jessiepullaro414/Scan/software/docs/APP_API.md

# OpenHandScan Studio: app API (v2, milestones 1 and 2)

Milestone 1 defined everything up to [M2: setup and calibration](#m2-setup-and-calibration), which adds to it without changing it.

This is the contract between the backend (`software/ohs/server/`, FastAPI) and the UI (`software/ui/`, React).

- Server: `http://127.0.0.1:8765`. REST is under `/api`, the WebSocket at `/api/ws/live`, and the built UI is served at `/`.
- JSON uses snake_case.
- Lengths are in **mm**, times in seconds, timestamps in ISO 8601.

**Errors:** 4xx/5xx responses carry JSON `{"detail": "what happened", "hint": "what to do"}`. `hint` is optional.

## Types

```ts
type Emitters = { vertical: number; horizontal: number; dots: number };          // percent 0..100
type DeviceState = {
  source: "none" | "camera" | "replay" | "sim";
  connected: boolean;
  busy: string | null;                                   // e.g. "Generating simulator demo…"
  camera: { connected: boolean; info: Record<string, unknown> } | null;
  pico: { connected: boolean; firmware: string | null; emitters: Emitters } | null;
  calibration: { loaded: boolean; path: string | null; image_size: [number, number] | null;
                 baseline_mm: number | null; lasers: string[]; imu: boolean };
  replay: { path: string; loop: boolean } | null;
};
type ScanStatus = "recording" | "recorded" | "processing" | "processed" | "failed";
type Scan = { id: string; name: string; created: string; mode: "markerless" | "markers";
              n_frames: number; duration_s: number; status: ScanStatus;
              result: { mesh_url: string; stl_url: string; laser_points_url: string | null;
                        report: Record<string, unknown> } | null };
type ProjectSummary = { id: string; name: string; created: string; modified: string;
                        n_scans: number; thumbnail_url: string | null };
type Project = ProjectSummary & { scans: Scan[] };
type SessionState = { state: "idle" | "scanning" | "paused" | "stopping";
                      project_id: string | null; scan_id: string | null;
                      mode: "markerless" | "markers"; elapsed_s: number; frames: number };
type Job = { id: string; kind: string; state: "queued" | "running" | "done" | "failed" | "cancelled";
             progress: number; message: string; result: Record<string, unknown> | null;
             error: string | null; created: string };
```

## REST

| Method and path | Body | Returns |
|---|---|---|
| `GET /api/health` | | `{app:"openhandscan", version, engine:{opencv, open3d}}` |
| `GET /api/device` | | `DeviceState` |
| `POST /api/device/connect` | `{source:"camera"\|"replay"\|"sim", recording?:string, loop?:bool}` | `DeviceState`. For `sim`, the first time a job builds the demo recording: returns **202** with `{job: Job}`, and the device connects itself when the job finishes. |
| `POST /api/device/disconnect` | | `DeviceState` |
| `POST /api/device/emitters` | `Emitters` (partial allowed) | `DeviceState`. Ignored for replay and sim. |
| `GET /api/projects` | | `ProjectSummary[]`, newest first |
| `POST /api/projects` | `{name}` | `Project` |
| `GET /api/projects/{pid}` | | `Project` |
| `PATCH /api/projects/{pid}` | `{name}` | `Project` |
| `DELETE /api/projects/{pid}` | | `204`. The folder moves to `<projects>/.trash/` and is never hard-deleted. |
| `GET /api/scan` | | `SessionState` |
| `POST /api/scan/start` | `{project_id, mode?, name?}` | `SessionState`. `409` if no device is connected, no calibration is loaded, or a scan is already running. |
| `POST /api/scan/pause` / `resume` | | `SessionState` |
| `POST /api/scan/rewind` | `{seconds: 2.0}` | `SessionState`. Drops the last N s from the live model and records a `cut` event, which offline processing skips. |
| `POST /api/scan/stop` | | `{scan: Scan}` (the recording is finalised) |
| `POST /api/projects/{pid}/scans/{sid}/process` | `{quality:"standard"\|"best"\|"preview"}` (default `"standard"`; `"full"` = `"standard"`) | `Job` |
| `GET /api/jobs` / `GET /api/jobs/{jid}` | | `Job[]` / `Job` |
| `POST /api/jobs/{jid}/cancel` | | `Job` |
| `GET /api/projects/{pid}/scans/{sid}/files/{name}` | | result files: `mesh.ply`, `mesh.stl`, `laser_points.ply`, `report.json` |
| `GET /api/settings` | | merged config as JSON (read-only in M1) |

## WebSocket `/api/ws/live`

**Client → server (text JSON):** `{"type":"subscribe","preview":true,"mesh":true,"max_preview_hz":15}`. Every field is optional, and preview and mesh are on by default.

**Server → client, text JSON messages:**
- `{"type":"hello","version":"0.1.0"}` on connect, followed by the current `device`, `session` and active `job` messages.
- `{"type":"status","t":…,"session":SessionState,"tracking":{"state":"idle"|"ok"|"weak"|"lost","reason":string|null,"fitness":number|null,"rmse_mm":number|null},"distance_mm":number|null,"fps":{"camera":number,"pipeline":number},"laser_points":number,"model":{"vertices":number,"triangles":number},"emitters":Emitters|null}` at about 10 Hz.
- `{"type":"pose","T_wc":[16 numbers, row-major],"ok":bool}` with each processed frame, and `{"type":"ghost","T_wc":[…]}` when tracking is lost (the last good pose).
- `{"type":"device", …DeviceState}`, `{"type":"job", …Job}`, `{"type":"log","level":"info"|"warn"|"error","message":…}` whenever they change.

**Server → client, binary messages:** a `uint32` little-endian header length, then the UTF-8 JSON header, then the payload.
- `{"type":"preview","camera":"left"|"depth","format":"jpeg","w":…,"h":…,"seq":…}`. The payload is a JPEG. `left` is the rectified left image with the laser overlay; `depth` is a colourised depth map.
- `{"type":"mesh","seq":…,"vertices":V,"triangles":T,"units":"mm","frame":"world"}`. The payload is four sections, each starting on a 4-byte boundary:
  1. `positions` Float32[V·3]
  2. `normals` Float32[V·3]
  3. `colors` Uint8[V·4] (RGBA quality colours: green = well observed, yellow = thin)
  4. `indices` Uint32[T·3]
  
  It's sent every ~1.5 s while scanning, decimated to at most 300k triangles.

**Backpressure:** the server keeps only the latest message of each binary type per client, so a slow client never stalls the scanner.

## Coordinates
- The world frame is the camera frame of the first tracked frame, with OpenCV axes (x right, y down, z forward), in mm.
- The UI converts to three.js (y up) by rotating 180° about X. It then frames the model automatically.

## Project folders
- Location: `<projects_dir>/<project_id>/` (default `~/OpenHandScan/projects`).
- Contents: `project.json`, plus `scans/<scan_id>/recording/` (the raw recording format from ARCHITECTURE.md) and `scans/<scan_id>/result/` (the output of `process_recording`).
- `project.json` holds `{id, name, created, modified, scans:[{id, name, created, mode, status}]}`.

## API deviations (backend, M1)

Everything above is implemented as written. Where the contract was silent or ambiguous, the backend does this. Fields marked *extra* are additions that a UI can ignore.

**Clarifications**
- Binary framing: the JSON header is padded with spaces so the payload starts on a 4-byte boundary *of the whole message* (`(4 + header length) % 4 == 0`), so `Float32Array`/`Uint32Array` views can be made directly on the received `ArrayBuffer`. Mesh sections follow back to back (their sizes are always multiples of 4).
- `Job.progress` is a fraction from 0 to 1. A job's final `job` message comes after its side effects (scan status updated in the store, the simulator device connected).
- `GET /api/projects` is sorted by `created`, newest first. `POST /api/projects` returns 200 with the `Project`.
- `replay.loop` defaults to `false`. A non-looping replay disconnects at its end (a running scan is stopped and saved, and a `log` message says so). The sim source always loops; its demo is a seamless back-and-forth sweep, so tracking continues across passes.
- `status.laser_points` is the running total of the live model (a rewind lowers it). `status.model` counts the live mesh before decimation.
- Every scan start first sends an empty `mesh` (`seq` 0, 0 vertices) so the UI can clear the previous model. The ghost is the last good pose; the UI hides it when a `pose` arrives with `ok: true`.
- Quality colours: the proxy is the number of tracked frames that saw each 8 mm cell of the world (not the TSDF weight, which a rewind rebuild would distort). Yellow at 4 views or fewer, green at 12 or more, blended in between.
- Pause: frames are neither recorded nor integrated, and the emitters are off. IMU samples and events are still recorded so that offline tracking can bridge the pause with the gyro. `events.csv` gets `session,pause` / `session,resume` rows.
- Rewind cuts the frame-clock interval `[t1 - seconds, t1]`, where `t1` is the newest recorded frame; paused time counts. Offline processing skips cut frames (`report.json` has `frames.cut` and `cuts`).
- `POST /api/device/emitters`: during a scan the levels are kept for the rest of it. While paused they are only stored, and the emitters stay off until Resume. Without a Pico (replay, sim, or a camera with no Pico) the call is ignored and returns the `DeviceState`.
- Status codes besides 409: 400 for an empty name or a replay without `recording`; 404 for a replay path that is not a recording; 422 for an invalid body; 503 when the camera or Pico cannot be opened or the Pico refuses a command; 403 from the local guard. The local guard refuses a `Host` other than localhost or an IP address, and refuses mutating requests or WebSockets whose `Origin` is neither this server nor the Vite dev server on port 5173.
- Pico trigger: a short press pauses or resumes a running scan, or starts a scan in the last-used project when idle. A long press (1 s or more) stops the scan.

**Extra fields**
- `hello`: `app`, `app_version`. `log`: `t`. `health`: `api`.
- `status`: `tracking.code` (machine-readable: `no_depth`, `few_inliers`, `low_overlap`, `degenerate`, `rewound`, ...), `laser_points_frame`, `latency_ms` (frame captured to result published), `process_ms` (pipeline time of the frame), `dropped_frames` (frames the live pipeline skipped; every frame is still recorded), `record_backlog` (frames waiting to be written to disk: the recorder's queue plus unwritten PNGs; 0 when idle; the recorder logs one warning past 120), `gpu_fallback` (`null`, or `{stage: reason}` once a GPU stage failed in the running scan and went on on the CPU, e.g. `{"depth": "out of memory"}`, stages `depth` and `track_filter`; kept until the scan stops; the server also sends one `log` message with level `warn` when it first happens).
- `status.tracking.weak` (M3): what the surface can't pin down in this frame, `"slide"` and/or `"turn"` (a flat panel, a sphere's axis).
  - `degenerate` shows with a matching hint when 4 of the last 6 frames have it.
  - Sliding counts even with the gyro, which holds rotations only; turning counts only without the gyro.
  - The processing report has the share of tracked frames with each, in `frames.weak`.
- `DeviceState`: `error` (the last device failure), `warnings` (strings), `imu_stream` (bool), `camera.info.measured_fps` / `frames` / `frame_size`, `pico.imu` / `port` / `error`.
- `DeviceState.imu_temp_c` (number or null): the IMU chip's temperature in °C, rounded to 0.1. It is live from firmware 1.1+ (about once a second while the IMU streams), or as recorded for a replay or the simulator, and null when there has been no reading for 10 s. A `device` message goes out when it has moved 0.5 °C. Recordings store every reading as a `temperature` event, and a scan starts with the latest one.
- `SessionState`: `name` (the scan name) while a scan is active. The `POST /api/scan/rewind` reply also has `rewind: {t0, t1, seconds, dropped_frames, kept_frames, rebuilt_keyframes, rebuild_s}`.
- `Scan`: `thumbnail_url` (or null), `error` (after a failed processing), `quality` (of the last processing). `ProjectSummary.thumbnail_url` is the newest scan's thumbnail.
- `Job`: `project_id`, `scan_id` and `quality` for `process_scan`. `result` is `{project_id, scan_id, scan}` for `process_scan` and `{path, frames, image_size}` for `generate_demo`.
- `Job.frames` (optional): `{stage, done, total, fps, elapsed_s} | absent`, present only while a job goes through the recording's frames (the track pass, and the fuse passes of straighten and fuse, in the processing jobs).
  - `stage` is `"track"`, `"straighten"` or `"fuse"`; `done` counts frames from 1 to `total` (the frames this pass processes, after Standard's frame limit); `fps` is the rate since the first frame was done (null until the second), and `elapsed_s` the time since then. The rate leaves out loading the recording and the first frame's warm-up.
  - The last frame always goes out. From then until the pass ends (`done == total`) the mesh is made from the frames, cleaned and saved; the message then reads like "Tracking: all 412 frames done, making the mesh".
  - The field disappears when the pass ends and is never in a finished job. A job can have several passes; each starts its own count. The UI turns it into "About 3 min left for tracking" (`ui/src/lib/estimate.ts`). An engine without it simply sends no `frames`.
- `mesh` header: `decimated` (bool).
- `GET .../files/{name}` also serves `trajectory.csv`, `mesh.obj` (when exported) and `thumbnail.jpg` (the left camera view saved at stop).

---

## M2: setup and calibration

The first-run wizard and the calibration screens (see the M2 plan in [`DESKTOP_APP_PLAN.md`](DESKTOP_APP_PLAN.md#m2-plan-setup-and-calibration-wizard)). Everything here adds to the M1 contract; nothing in M1 changes. `health.api` and `hello.version` become `"0.2.0"`.

**Targets.** The wizard calibrates one *target*:
- `"device"`: the real scanner's calibration file (`paths.calibration`).
- `"sim"`: a sandbox file for the simulator (`<data_dir>/sim/calibration.json`). Calibrating the simulator never touches the real calibration, and the simulator's scan demo keeps its own true calibration.

The target is `"sim"` while the simulator is connected, and `"device"` otherwise. `data_dir` defaults to `~/.ohs/studio`.

### Types

```ts
type CalibKind = "stereo" | "lasers" | "imu" | "check";
type CalibTarget = "device" | "sim";
type SimScene = "demo" | "calib_stereo" | "calib_lasers" | "calib_imu" | "calib_check";

// DeviceState gains (M2):
//   launch_check: LaunchCheck | null   the silent drift check run after each connect
//   sim_scene: SimScene | null         what the simulator shows (null unless source is "sim")
type LaunchCheck = { state: "running" | "ok" | "drift" | "unknown"; dv_px: number | null;   // median rectified row error, full-res px
                     matches: number; message: string | null; when: string };

// ---- setup
type StepId = "connect" | "selftest" | "print" | "stereo" | "lasers" | "imu" | "check";
type SetupStep = { id: StepId; state: "done" | "todo" | "warn" | "optional"; summary: string; when: string | null };
type PartInfo = { when: string; summary: string; session: string | null };   // recorded by Studio when it saved that part
type SetupState = {
  target: CalibTarget;
  first_run: boolean;      // the target has no stereo calibration and the wizard was not dismissed
  dismissed: boolean;
  steps: SetupStep[];      // always all seven, in the StepId order above
  calibration: { path: string; exists: boolean; modified: string | null; image_size: [number, number] | null;
                 baseline_mm: number | null; stereo: boolean; lasers: string[]; imu: boolean;
                 parts: { stereo: PartInfo | null; lasers: PartInfo | null; imu: PartInfo | null };
                 backup: string | null };            // the previous version (calibration.json.bak), if any
  selftest: SelfTestResult | null;                    // the last self-test for this target
  print_check: PrintCheck | null;                     // null for the sim target (its board is virtual and exact)
  board: BoardInfo;
  launch_check: LaunchCheck | null;
  last_check: { when: string; ok: boolean; verdict: string } | null;
};
type BoardInfo = { squares_x: number; squares_y: number; square_mm: number; marker_mm: number;   // as printed (config [board])
                   dictionary: string; paper: "letter" | "a4"; scale: number;                    // measured print scale used for calibration (1 = exact)
                   describe: string };

type CheckStatus = "PASS" | "WARN" | "FAIL" | "SKIP" | "INFO";
type SelfTestCheck = { name: string; status: CheckStatus; detail: string; fix: string | null };   // fix: what to do, in plain words
type SelfTestResult = { overall: "PASS" | "WARN" | "FAIL"; when: string; source: "camera" | "replay" | "sim"; checks: SelfTestCheck[] };

type CameraProbe = { index: number; width: number; height: number; fps: number; fourcc: string; name: string | null;
                     stereo_like: boolean; configured: boolean; in_use: boolean };
type DevicesProbe = { cameras: CameraProbe[]; pico_port: string | null; configured_index: number; note: string | null };

type PrintFile = { name: string; kind: "board" | "tags" | "mask"; title: string; description: string;
                   url: string; preview_url: string | null; bytes: number };
type Printables = { dir: string; generated: string | null; paper: "letter" | "a4"; files: PrintFile[] };
type PrintCheck = { measured_mm: number; error_pct: number; ok: boolean; scale: number; verdict: string;
                    can_apply: boolean; when: string };

// ---- calibration session
type CalibState = "idle" | "capturing" | "armed" | "recording" | "solving" | "result" | "saved";
// capturing: stereo / lasers / check take views. armed -> recording: the IMU step (hold still, then rotate).
type CalibView = { index: number; t: number; auto: boolean; corners_left: number; corners_right: number | null;
                   distance_mm: number | null; tilt_deg: number | null;
                   lines: { vertical: number; horizontal: number } | null;     // laser points on the page margin
                   thumb_url: string; error_px: number | null; bad: boolean;   // error and bad: after a solve
                   warnings: string[] };
type CalibMetric = { label: string; value: string; ok: boolean | null; help: string };
type CalibAdvice = { text: string;
                     action: "add_views" | "remove_bad_views" | "start_over" | "recalibrate_stereo" | "reprint" | "check_board" | null };
type CalibResult = {
  kind: CalibKind; ok: boolean; grade: "excellent" | "good" | "usable" | "poor" | "failed";
  headline: string;        // e.g. "Excellent stereo calibration"
  verdict: string;         // one or two plain sentences: what happened and what it means
  metrics: CalibMetric[];  // plain-language rows: "Reprojection error 0.21 px (want < 0.5 px)"
  advice: CalibAdvice[];
  per_view: { index: number; error_px: number; bad: boolean }[];
  sim_truth: CalibMetric[] | null;   // simulator only: the estimate against the virtual scanner's true calibration
  can_save: boolean;                 // false for "check" and for "failed"
  report_url: string;
};
type CalibSession = {
  state: CalibState; kind: CalibKind | null; target: CalibTarget; id: string | null; started: string | null;
  auto: boolean;                     // auto-capture on (default)
  views: CalibView[]; target_views: [number, number]; min_views: number;
  guidance: string;                  // the one-line how-to for this kind
  emitters: string;                  // e.g. "Line lasers on: Class 3R, never look into the beams"
  job_id: string | null;             // the solve job
  result: CalibResult | null;
  recording: string | null;          // folder of the captured views
  saved: { path: string; backup: string | null; notes: string[] } | null;
};
type CalibHint = { text: string;                                   // "Move the board to the top-left corner"
                   region: [number, number, number, number] | null; // x0, y0, x1, y1 as fractions of the image: where to put the board
                   tilt: "left" | "right" | "up" | "down" | "more" | null;
                   distance: "closer" | "farther" | null };
type CalibLive = {
  type: "calib"; t: number; kind: CalibKind; state: CalibState;
  image_size: [number, number];      // full-resolution size of one camera image; every coordinate below is in it
  fps: number;                       // processed frames per second
  left: { corners: number[] } | null;      // flattened [u0, v0, u1, v1, ...]
  right: { corners: number[] } | null;     // stereo only
  common: number | null;                   // stereo: corners seen by both cameras
  board_found: boolean; distance_mm: number | null; tilt_deg: number | null;
  outline: number[] | null;                // board outline, 4 points
  page: number[] | null;                   // lasers / check: page outline, 4 points
  lines: { vertical: number; horizontal: number; vertical_uv: number[]; horizontal_uv: number[] } | null;
  ready: boolean;                          // a capture now would be accepted
  reason: string | null;                   // why not: "Show the whole board to both cameras", "Hold still", "Too close to view 3"
  steady: number;                          // 0..1: progress of the auto-capture hold
  auto: boolean;
  hint: CalibHint | null;
  coverage: { cols: number; rows: number; left: number[]; right: number[] | null;   // views per cell, row-major
              left_pct: number; right_pct: number | null } | null;
  diversity: { flat: number; tilt_left: number; tilt_right: number; tilt_up: number; tilt_down: number;
               near: number; mid: number; far: number } | null;                       // captured views per pose bin
  views: number; target_views: [number, number];
  imu: { phase: "armed" | "still" | "rotate" | "done"; elapsed_s: number; still_s: number; min_s: number; max_s: number;
         gyro_dps: number; board_pct: number } | null;
};
```

### REST

| Method and path | Body | Returns |
|---|---|---|
| `GET /api/setup` | | `SetupState` |
| `POST /api/setup/dismiss` | `{dismissed: bool}` | `SetupState` |
| `POST /api/setup/selftest` | | `Job` (kind `selftest`, result `SelfTestResult`). While it runs, `job.message` is the instruction for the user (e.g. "Press and release the trigger now"). |
| `GET /api/setup/devices` | | `DevicesProbe` (cameras found, the Pico's serial port) |
| `POST /api/settings/camera` | `{index?: int, swap_lr?: bool}` | `Settings`. Written to the config file; takes effect on the next connect. |
| `GET /api/setup/printables` | | `Printables` (what was generated last; `files` empty before) |
| `POST /api/setup/printables` | `{paper?: "letter" \| "a4"}` | `Job` (kind `printables`, result `Printables`). A paper change is saved to `board.paper`. |
| `GET /api/setup/printables/files/{name}` | | a generated file (PDF, PNG, Gerber); 404 for anything else |
| `POST /api/setup/printables/open` | | `{opened: bool, dir: string}`: opens the folder in the system file manager |
| `POST /api/setup/print-check` | `{measured_mm: number, apply?: bool}` | `PrintCheck` |
| `GET /api/calibration` | | `CalibSession` (`state: "idle"` when none) |
| `POST /api/calibration/start` | `{kind}` | `CalibSession` |
| `POST /api/calibration/capture` | | `{view: CalibView, session: CalibSession}`. 409 with the plain reason when the current view can't be used. |
| `DELETE /api/calibration/views/{index}` | | `CalibSession` |
| `POST /api/calibration/auto` | `{enabled: bool}` | `CalibSession` |
| `POST /api/calibration/imu/start` | | `CalibSession` (armed -> recording) |
| `POST /api/calibration/imu/stop` | | `CalibSession` (recording -> capturing, ready to solve) |
| `POST /api/calibration/solve` | | `Job` (kind `calibrate`). The session goes to `solving`, then `result`. A failed solve returns the session to `capturing` with a `result` of grade `failed` that says why. |
| `POST /api/calibration/continue` | | `CalibSession`: back to `capturing` with the views kept ("add more views") |
| `POST /api/calibration/save` | `{force?: bool}` | `{session: CalibSession, setup: SetupState}`. `force` is needed when `result.ok` is false. 409 for `check` and `failed` results. |
| `POST /api/calibration/cancel` | | `CalibSession` (idle). The captured views stay on disk. |
| `GET /api/calibration/views/{index}/thumb.jpg` | | small JPEG of the view's left image |
| `GET /api/calibration/report.json` | | the engine's full report of the last solve |

### WebSocket additions
- Text `{"type":"calib", ...CalibLive}` at about 10 Hz while a calibration session is active (latest-only).
- Text `{"type":"calib_session", ...CalibSession}` whenever the session changes. New clients get it in the seed.
- Text `{"type":"setup", ...SetupState}` whenever it changes (self-test, print check, save, launch check, connect).
- Binary `preview` with `camera` `"calib_left"` or `"calib_right"`: the calibration views, JPEG, downscaled (about 640 px wide). The `preview` subscription flag gates them like the other previews.
  - stereo: raw (unrectified) left and right images;
  - lasers / check / imu: the rectified left image only.
  
  `CalibLive` coordinates are full-resolution pixels of the image that preview shows; the UI scales them by `w / image_size[0]`.

### Rules
- **One activity at a time:** a scan and a calibration session never run together (409 either way). Calibration needs the camera or the simulator. A replay is refused with 409.
- **Preconditions:** lasers, imu and check need a stereo calibration in the target (409 with a hint otherwise). imu also needs IMU data: the Pico's IMU, or the simulator. With a camera, lasers and check need the Pico for the emitters; without it they start with a warning.
- **Device lost:** if the device disconnects during a session, the session is cancelled (the views stay on disk) and a `log` says so.
- **Trigger:**
  - stereo / lasers / check: a short press captures a view; a long press solves (once there are enough views).
  - imu: a short press starts and stops the recording.
- **Emitters:** each kind uses its profile from the config (`[emitters.profiles]` `stereo` / `lasers` / `imu` / `check`) while the session runs, and they are off afterwards.
- **Simulator:** `start` switches the simulator to that kind's virtual board (`DeviceState.sim_scene`). Cancel and save switch it back to `"demo"`. Results carry `sim_truth`.
- **Saving** merges like `ohs calibrate`:
  - A new stereo calibration drops the laser planes and the IMU calibration, and `saved.notes` says so.
  - The previous file is kept as `calibration.json.bak`.
  - After saving to the device target, a connected camera reloads the calibration (`device` message).
- **Launch check:**
  - After each connect with a calibration, the device compares the rectified rows of left and right features on a few idle frames.
  - It stays silent unless they disagree (`launch_check.state: "drift"`). Then a `warn` log and a `DeviceState.warnings` entry suggest running the check.
  - `"unknown"` (too few features, e.g. a blank wall) is also silent.

## API deviations (M2)

Where the backend had to decide something the M2 contract left open, it is listed here.

Everything in the M2 section is implemented as written, with these clarifications. Fields marked *extra* are additions that a UI can ignore.

**Setup state**
- `setup.json` lives in `data_dir` (config key `paths.data_dir`). The dismissed flag is kept per target. The printables manifest is shared by both targets.
- The target is `"sim"` while the simulator is connected, in any scene, and `"device"` otherwise (also with a replay or nothing connected).
- Step rules:
  - `connect` is done once a camera (device target) or the simulator (sim target) has connected. Replays don't count. The summary reads like "Camera (2560x800) and Pico (firmware ohs-fw 1.0) connected, today".
  - `selftest` is done on PASS. It is a warning on WARN or FAIL, and its summary names the checks.
  - `print` (device) is done within ±0.3 % and a warning otherwise, even after "use my measurement".
  - `lasers` is done with both planes and a warning with only one.
  - `check` is done or a warning only when the last check is newer than the last save. The last save is Studio's part info, else the file's modification time. Otherwise the step is to do.
- `when` is the time behind the summary, or null.
- `calibration.parts.<part>` is set only for parts that are in the file and were saved by Studio. A file from `ohs calibrate` gives null.

**Print check**
- `error_pct` is `measured_mm - 100`, signed. `measured_mm` must be greater than 0 and less than 1000, else 422.
- Each check replaces the previous one:
  - within ±0.3 %: scale 1;
  - up to ±4 %: `measured / 100` with `apply: true`, else 1;
  - beyond ±4 %: always 1, and `apply` is ignored.
- The print is physical, so a print check made while the simulator is connected is stored for the device. The sim's `SetupState.print_check` stays null.
- The scale only changes the board spec used to calibrate the device (`board.scale`; `board.describe` mentions it). Capture recordings store that scaled spec as `board`, plus `board_scale`.

**Self-test**
- With nothing connected, the self-test runs on the configured camera and Pico and leaves the device disconnected.
- With the camera connected, the device is busy ("Running the self-test…") during the test and is reconnected afterwards.
- `run_selftest` has one duration for its measurement and its trigger window: 8 s. The measurement therefore also takes 8 s, and the whole test about 25 s.
- `job.message` shows the instructions, then "Camera frame rate: passed" and so on after each check.
- The simulator and replay stream checks take 3 s.
- Refused with 409 also while a self-test is running or the device is busy.
- *extra*: `SelfTestCheck.id` is the engine's check name (e.g. `camera fps`); `name` is the readable one ("Camera frame rate"). The job result also carries `message`, which the stored `setup.selftest` does not.

**Devices probe and camera settings**
- The probe opens indices 0–7 with the configured `camera.backend` and reports each camera's default mode. `name` is only available on Linux.
- The connected camera is never opened again. Its entry (`in_use: true`) comes from the running camera, with the side-by-side size.
- `pico_port` falls back to the connected Pico's port.
- `POST /api/settings/camera` returns the same object as `GET /api/settings`.
  - Errors: 422 for an index outside 0–63; 409 during a scan or a calibration.
  - It updates the running config too and takes effect on the next connect.
  - The file written is `Settings.effective.config_path` (*extra*, along with `data_dir`, `printables_dir` and `sim_calibration`). When there is no file, the commented template is written first. Comments and other lines are kept.

**Printables**
- The paper is saved before the job starts. The job result is `Printables` plus `message`.
- Errors: 409 while a printables job runs; 422 for an unknown paper.
- A new run first removes the previous run's files (only whitelisted names).
- File names:
  - board: `charuco_board.pdf` / `.png`;
  - tags: `apriltags.pdf` / `.png` (`apriltags_p<k>.png` for several sheets);
  - mask: `projector_mask_sheet.pdf` / `.png` and `projector_mask_film.gbr` / `.svg`.
- `preview_url`:
  - board: `charuco_board.png`;
  - tags: the sheet's PNG;
  - mask: `projector_mask_preview.png`, one mask enlarged. It is served but not listed, because the 1200 dpi sheet shows nothing at screen size.
- The file route serves only those names, from the last run, with `X-Content-Type-Options: nosniff`.
- `POST .../open` creates the folder if it is missing.
- The 1200 dpi mask sheet takes about 20 s.

**Simulator scenes**
- `sim_scene` is `"demo"` for the scan demo and `"calib_<kind>"` during a calibration.
- *extra*: `DeviceState.sim_demo_ready` is true when the simulator's demo recording exists, so connecting the simulator is instant and needs no `generate_demo` job.
- A scene swap is not a reconnect: there is no "Connected" log and no launch check.
- During a calibration scene, `DeviceState.replay` is null and `DeviceState.calibration` is the sandbox calibration.
- A scene that cannot start returns 503, and the demo comes back.

**Launch check**
- It runs after every fresh connect with a calibration, including the simulator demo.
- `launch_check` is `{state: "running", dv_px: null, matches: 0, …}` until 3 idle frames, at least 0.3 s apart in frame time, are in. While a scan or a calibration takes the frames, it waits.
- `dv_px` is rounded to 0.001 px.
- `"unknown"` also covers a camera image size that differs from the calibration.
- The result is recorded for the target: `sim` for the simulator, else `device`.
- The drift warning reads "The cameras may have moved since the calibration … Run the 2-minute check (Setup, step 7)."

**Calibration session**
- **Views:**
  - `CalibView.index` is a stable id: 0, 1, 2… in capture order, never reused. Deleting a view leaves a gap, and the next capture continues the count. Show `index + 1` as the view number: "Too close to view 3" means index 2.
  - The snapshot recording uses the same numbers for its frames. A delete rewrites `frames.csv` and `meta.json` and removes the PNG.
  - `CalibView.t` is seconds since the session's first processed frame (frame clock).
  - `CalibView.lines` (lasers / check) counts the laser points on the blank page margin, at least 5 mm clear of ink and of the paper edge: the points the laser fit uses. A view needs ≥ 15 per line.
- **Recordings:**
  - Views are written by Studio's own writer, in the recording format. `RecordingWriter` keeps `frames.csv` open and cannot drop a row.
  - The IMU uses `ohs.app.live.Recorder` and keeps the last second of IMU history (not on the simulator).
  - `recording` is null until the first capture or `imu/start`.
  - A solve writes `calib_report_<kind>.json` into the recording.
  - Cancelled recordings stay on disk, including a partial IMU recording.
- **imu:** `views` is `[]`, `target_views` is `[0, 0]` and `min_views` is 0. States run `armed` → `recording` → `capturing` (recorded, ready to solve) → `solving` → `result`.
- **State rules:**
  - Solve is allowed from `capturing` or `result`, so you can delete views and solve again.
  - Capture only in `capturing`; delete in `capturing` or `result`.
  - `continue` clears `result`: back to `capturing`, or `armed` for imu, to record again. The view errors stay until the next solve.
  - After a save, the state is `saved`, and `GET /api/calibration` shows the saved session until the next start or a cancel.
- **Auto-capture:**
  - Steady means the 90th percentile of the common corners' motion is under 1 px (both cameras for stereo) for 0.5 s.
  - New means the board centre moved more than 12 % of the width, or the distance changed more than 10 %, or the board normal turned more than 8°.
  - It stops at the upper target view count (25 / 10 / 5) with the reason "Enough views: press Finish & calibrate".
- **IMU timing:** `elapsed_s`, `still_s` (2), `min_s` (22, which is 2 s still plus 20 s of rotation) and `max_s` (62) are seconds of frame time since the first recorded frame.
  - `imu/stop` before `min_s` returns 409 "Keep rotating: N s more" (a trigger press logs the same).
  - Recording stops by itself at `max_s`, with an `info` log.
  - On the simulator, `imu/start` restarts the script and drops the one frame rendered before the restart.
- **Emitters:**
  - The kind's profile is on while capturing. The emitters are off while solving and while the result is shown, on again after `continue` or a failed solve, and off after save, cancel or a lost device.
  - `CalibSession.emitters` reads, for example, "Line lasers on: Class 3R, never look into the beams", "Emitters off: ambient light only", "No Pico: the line lasers stay off, …" or "Simulated line lasers on".
- **More 409 rules:**
  - lasers, imu and check also need the camera's image size to match the target's stereo calibration;
  - connect is refused during a calibration, and disconnect cancels it first (the views are kept);
  - `POST /api/setup/selftest` and `POST /api/settings/camera` are refused during a calibration.
- **Device lost:** losing the camera cancels the session. A lost Pico cancels only the IMU step; the other kinds continue with a warning that the lasers are off.
- **Trigger:**
  - imu: a short press starts or stops the recording; after recording, a long press solves.
  - Refusals are sent as `warn` logs in plain words.
- **Thumbnails** are JPEGs 240 px wide.
- *extra*: `CalibLive.frame_t` is the frame time of the processed frame. `CalibLive.t` is wall time, like `status.t`.

**CalibLive**
- Coordinates are full-resolution pixels of the image that the preview shows: raw for stereo, rectified left otherwise.
- `vertical_uv` / `horizontal_uv` are thinned to at most 200 points per line, rounded to 0.1 px.
- `page` is the paper outline.
- `ready` means a manual capture would be accepted now.
- `reason` is the first unmet auto-capture condition. It can also be "View N captured: move the board to a new pose", "Calibrating…" or "Press Continue to add more views".
- `coverage.*_pct` is the percentage (0–100) of the 64 cells that hold at least one view.
- Tilt bins say where the printed face points:
  - `left`: turned toward the image's left side;
  - `up`: tipped back, with the top edge farther away;
  - `flat`: under 15°.
- Distance bins:
  - stereo: near < 300 mm ≤ mid < 400 mm ≤ far;
  - lasers / check: near < 220 mm ≤ mid < 330 mm ≤ far.
- Hints:
  - `region` boxes are thirds of the image: the centre first, then the corners, then the edges.
  - `distance` is relative to the board's current distance, and null without a board.
- `calib` messages are sent about 10 Hz while frames are processed.
- The `calib_left` / `calib_right` previews are the plain images, at most 640 px wide and about 9 Hz (less if `max_preview_hz` asks). They have no overlays: the UI draws them from `calib`.

**Solve and results**
- `job.result` is `{kind, session, result: CalibResult, message}`. *extra* job fields: `calib_kind`, `calib_session`.
- A failed flow ends the job in `failed`, with `error` = the plain reason and the hint. The session is back in `capturing` with the failed result.
- Progress messages read like "Looking at view 3 of 8". The stereo solve itself reports no progress, for up to a minute.
- The IMU flow uses at most about 600 frames (it steps through longer recordings).
- `ok` means a grade of excellent or good. `can_save` is false for `check` and `failed`. Saving anything below good needs `force`.
- Grades:
  - **stereo:**
    - excellent: rms < 0.3 px, coverage > 60 % in both cameras, row error < 0.2 px, scale error < 0.3 %, ≥ 12 views and a tilt of ≥ 20°;
    - good: rms < 0.5 px, coverage > 60 % and a passing rectification check (< 0.3 px, < 0.5 %);
    - usable: rms < 1 px, coverage > 40 % and row error < 0.5 px;
    - else poor.
    - A positive `T_x` (swapped cameras) is `failed`, with the advice to turn on swap left/right and start over.
  - **lasers:**
    - excellent: both planes fitted on the margin, median residual < 0.05 mm, ≥ 6 views;
    - good: both on the margin, < 0.15 mm;
    - usable: both, < 0.3 mm (a plane may also have needed the pattern);
    - poor: one plane only;
    - failed: none.
  - **imu:**
    - excellent: the engine's verdict is good, residual < 0.1° and the board seen in ≥ 90 % of the frames;
    - good: the engine's verdict is good;
    - usable: residual < 0.5° and < 20 % outliers;
    - else poor.
  - **check:**
    - good (excellent with wide margins) when it holds, else poor.
    - On the simulator the engine's IMU part never decides it. The simulator's check moves the board, and that part assumes a still board; a check recording has no IMU samples anyway.
- `per_view` covers the views the solver looked at.
  - `error_px`: for stereo, the larger stereo rms of the view; for lasers, the board-pose rms.
  - It is null for a view the solver rejected, which is `bad: true`.
  - Views are also bad above max(2 × median, 0.5 px) (stereo), or with fewer than half of their laser points as inliers (lasers).
- Metric values include their target, e.g. "0.21 px (want < 0.5 px)".
- `sim_truth` compares planes and `R_ci` in the raw left camera frame.
- *extra*: `sim_truth_values` holds the numbers behind `sim_truth`.
- `GET /api/calibration/report.json`:
  - the engine report of the last solve, plus a `studio` block with kind, session, target, grade and views;
  - after a failed flow, `{kind, error, recording}`;
  - 404 before any solve. It is kept after a cancel.

**Save**
- `saved.notes` is in plain words: the dropped parts, a laser plane that kept its previous value, and the backup's name.
- A new stereo calibration also clears the dropped parts' info.
- The response's `setup` is the target's state after saving.

**WebSocket**
- New clients also get `setup` in the seed.

---

## M3 phase 2: processing studio

The Process page of a scan (see the M3 plan in [`DESKTOP_APP_PLAN.md`](DESKTOP_APP_PLAN.md)). It adds to M1 and M2 and changes nothing in them.
- `POST .../process` ("Make mesh") keeps its contract. It now runs the **Default** recipe at the requested quality.
- **Quality levels** (maintenance plan F2 step 3): `"standard"` (the default) processes at full resolution at most `[process] standard_frame_rate` frames per second of scanning (30: every 2nd frame of the 60 fps camera, every frame of a 30 fps recording); `"best"` processes every frame (less noise on smooth surfaces, about twice the wait); `"preview"` as before. `"full"`, the old name, is accepted everywhere and read as `"standard"`, also in stored state and saved recipes; responses and new state say `"standard"` / `"best"`. Stage summaries name the level ("Tracked 540 of 540 frames (100 %) at standard quality"). The report's `frames` has the effective `step`, `recorded_fps` and `max_frame_rate`.
- `health.api` and `hello.version` become `"0.3.0"`.

**Model.**
- A scan's processing is five **stages**: `track`, `straighten`, `fuse`, `spacetime` (M3 phase 3, a trial build: "Refine from the images") and `refine` (M3 phase 3: "Refine with lasers"). Each ends in a new **base mesh**.
- An ordered list of **edits** applies to the base mesh. `cursor` is how many of them are active; undo and redo move it.
- The **current mesh** is the base plus the active edits. It is always written to the scan's `result/mesh.ply` (and `mesh.stl`, plus `mesh.obj` when configured), so the M1 viewer and downloads show the current version.
- Re-running a stage replaces the base and **clears the edits**: face indices no longer match. The UI confirms first.
- Files live in `scans/<sid>/process/`; their layout is the backend's choice. It records it under "API deviations (M3)".

### Types

```ts
type StageState = "none" | "running" | "done" | "failed" | "skipped";
type MeshOp = "remove_floaters" | "fill_holes" | "smooth" | "decimate" | "delete_faces" | "keep_faces";
// params per op:
//   remove_floaters { min_triangles?: number; min_size_mm?: number; keep_largest_only?: boolean }
//   fill_holes      { max_hole_mm: number; watertight?: boolean }  // largest hole perimeter to fill; the outer edge too
//   smooth          { method: "taubin" | "bilateral"; strength: number /* 0..1 */; keep_edges?: boolean;
//                     within_sigma?: boolean }                     // no vertex moves more than 2 sigma
//   decimate        { target_triangles?: number; ratio?: number;   // at most one of the two, and / or
//                     max_error_mm?: number }                      // a tolerance (0.001-10 mm)
//   delete_faces / keep_faces { faces: string }                    // base64 of little-endian uint32 face indices
//                                                                  // of the CURRENT mesh
type MeshStats = {
  triangles: number; vertices: number; components: number;
  holes: number;                      // boundary loops except the outer border (the longest loop)
  largest_hole_mm: number | null;     // perimeter of the largest hole
  border_mm: number | null;           // perimeter of the outer border
  boundary_edges: number; non_manifold_edges: number; watertight: boolean;
  bbox_mm: [number, number, number]; area_cm2: number; volume_cm3: number | null;   // volume only when watertight
  sigma_mm: SigmaStats | null;        // the confidence, when the mesh has per-vertex sigmas
  filled_cm2: number;                 // area made by hole filling (not measured)
};
type SigmaStats = {                   // each vertex's sigma (1 standard deviation, mm), shares of the surface
  median: number; p95: number;        // mm
  within_0_1: number; within_0_3: number;   // share with sigma <= 0.1 / 0.3 mm
  not_measured: number;               // share nothing measured (sigma 50 mm: filled holes)
};
type EditEntry = { id: string; op: MeshOp; params: Record<string, unknown>;
                   label: string;               // "Fill holes up to 12 mm"
                   created: string; triangles_after: number; ms: number };
type StageInfo = { state: StageState; summary: string | null; when: string | null; job_id: string | null };
type ProcessState = {
  project_id: string; scan_id: string;
  stages: {
    track: StageInfo & { quality: "standard" | "best" | "preview" | null; tracked_pct: number | null };
    straighten: StageInfo & { loops: number | null; correction_mm: number | null; correction_deg: number | null;
                              crossings?: number | null };   // laser crossings used (M3 phase 3)
    fuse: StageInfo & { voxel_mm: number | null };
    spacetime: StageInfo & { source: "track" | "straighten" | "fuse" | null;   // the stage whose mesh was refined
                             frames: number | null; patches: number | null;   // frames read; patches on the surface
                             kept: number | null;                             // patches with dots in enough frames
                             covered_pct: number | null; moved_mm: number | null;  // % refined; p95 move (mm)
                             device: "gpu" | "cpu" | null };
    refine: StageInfo & { source: "track" | "straighten" | "fuse" | "spacetime" | null;   // the stage whose mesh was refined
                          points: number | null; outliers: number | null;  // laser points used / left out
                          moved_pct: number | null; moved_mm: number | null;  // % of the surface moved; p95 offset (mm)
                          residual_before_mm: number | null; residual_after_mm: number | null };  // median, mm
  };
  base: { triangles: number; vertices: number; stage: "track" | "straighten" | "fuse" | "spacetime" | "refine" } | null;
  edits: EditEntry[]; cursor: number;       // edits[0:cursor] are applied
  can_undo: boolean; can_redo: boolean;
  current: { version: number;             // increases on every change: use it to reload the mesh
             mesh_url: string;            // result/mesh.ply of this scan
             stats: MeshStats } | null;
  busy: string | null;                    // e.g. "Filling holes…" while an edit or stage job runs
  job: Job | null;                        // the running job of this scan, if any
};
type Recipe = {
  id: string; name: string; description: string; builtin: boolean;
  settings: { quality: "standard" | "best" | "preview"; straighten: "auto" | "off"; refine: "auto" | "off"; voxel_mm: number | null };
  ops: { op: Exclude<MeshOp, "delete_faces" | "keep_faces">; params: Record<string, unknown> }[];
};
type HoleOutline = { perimeter_mm: number; n_edges: number; points: number[] };   // flattened xyz, closed loop
type TrajectoryView = { raw: number[][]; straightened: number[][] | null;          // camera positions (mm), subsampled
                        loops: [number, number][] };                             // index pairs into raw
```

### REST
Paths are relative to `/api/projects/{pid}/scans/{sid}`.

| Method and path | Body | Returns |
|---|---|---|
| `GET .../process` | | `ProcessState` |
| `POST .../process/track` | `{quality}` | `Job` (kind `process_track`) |
| `POST .../process/straighten` | `{}` | `Job` (kind `process_straighten`): loop closure, then a fuse at the corrected poses |
| `POST .../process/fuse` | `{voxel_mm}` | `Job` (kind `process_fuse`) |
| `POST .../process/spacetime` | `{}` | `Job` (kind `process_spacetime`): "Refine from the images", see below |
| `POST .../process/refine` | `{}` | `Job` (kind `process_refine`): "Refine with lasers", see below |
| `POST .../process/edits` | `{op, params}` | `Job` (kind `mesh_edit`). Any redo steps after the cursor are dropped first. |
| `POST .../process/undo` | | `ProcessState` (instant for the last 10 steps) |
| `POST .../process/redo` | | `ProcessState` |
| `POST .../process/recipe` | `{recipe_id, scope: "edits" \| "all"}` | `Job`. `edits`: replace the edits with the recipe's ops. `all`: run the stages with the recipe's settings, then its ops. |
| `GET .../process/holes.json` | | `HoleOutline[]` of the current mesh |
| `GET .../process/trajectory.json` | | `TrajectoryView` |
| `GET /api/recipes` | | `Recipe[]` (built-ins first) |
| `POST /api/recipes` | `{name, description?, from_scan: {project_id, scan_id}}` or `{name, description?, settings, ops}` | `Recipe` |
| `DELETE /api/recipes/{id}` | | `204` (user recipes only; 409 for a built-in) |

Rules:
- 409 while the scan is recording, or while another stage or edit job of this scan runs.
- `straighten` and `fuse` need a finished `track`.
- Edits need a base mesh.
- A failed edit leaves the mesh as it was, with a plain reason.

### WebSocket
`{"type":"process", ...ProcessState}` whenever a scan's processing state changes (keyed per scan). Jobs keep their M1 `job` messages.

### Engine interfaces (for the agents building this)
```python
# ohs/mesh/ (new): pure functions on (V float64 (N,3), F int64 (M,3)) -> (V, F); no I/O
remove_floaters(V, F, min_triangles=None, min_size_mm=None, keep_largest_only=False)
fill_holes(V, F, max_hole_mm)                     # fair (smooth) fill, not flat fans
smooth(V, F, method="taubin"|"bilateral", strength=0.5, keep_edges=True)
decimate(V, F, target_triangles=None, ratio=None)
delete_faces(V, F, faces) / keep_faces(V, F, faces)
mesh_stats(V, F) -> dict (MeshStats)              ;  hole_outlines(V, F) -> list[dict]
sigma_stats(S, V, F) -> dict (SigmaStats) | None  ;  carry_sigma(op, V, F, S, V2, faces=None) -> S2  # ohs/mesh/confidence.py
anchor_to_points(V, F, P, params=AnchorParams()) -> (V2, delta, report)   # ohs/mesh/anchor.py: Refine with lasers
refine_from_images(V, F, left, right, T_wc, K, baseline, params=SpacetimeParams()) -> (V2, delta, report)
frames_from_recording(rec, calib, poses, max_frames=120) -> (left, right, T_wc, K, baseline)   # ohs/track/spacetime.py

# ohs/track/posegraph.py (new)
straighten_trajectory(rec_path, calib, trajectory, *, params=None, depth_params=None, progress=None,
                      cancelled=None) -> tuple[dict[int, np.ndarray], dict]
#   trajectory: [(frame_index, t_host, ok, T_wc 4x4)] as process_recording writes trajectory.csv
#   returns the corrected T_wc for every tracked frame and a report:
#   {keyframes, loop_candidates, loops_accepted, correction_mm, correction_deg, loops: [(i, j)],
#    verdict (plain words), ground_truth: {before, after} when the recording has true poses,
#    drift_scale (M3 phase 3: the drift model scaled to the loops), candidates[]: {..., large, via}}
#   large drift (M3 phase 3 item 6): a candidate ICP can't verify from the tracked pose is checked
#   again with wider bounds, from the tracked pose or a global FPFH + FGR guess (global_match)

# ohs/track/curve_ba.py (M3 phase 3): the laser lines' crossings line up the poses (research plan 7.3)
laser_curve_adjustment(rec_path, calib, trajectory, *, reference=None, params=None, progress=None,
                       cancelled=None) -> tuple[dict[int, np.ndarray], dict]
#   report: {frames, crossings, miss_mm: {before, after}, holdout: {before_mm, after_mm, ratio}, moved_mm,
#            moved_deg, changed, reason (adjusted | no_lasers | few_crossings | not_better), verdict, ...}

# ohs/app/process.py: process_recording(..., poses: dict[int, np.ndarray] | None = None)
#   fuses at the given poses (no tracking) when poses are passed
```

## API deviations (M3)

The backend lists here what it had to decide.

Everything in the M3 phase 2 section is implemented as written, with these clarifications. Fields marked *extra* are additions that a UI can ignore.

**Files** (`scans/<sid>/process/`)
- `state.json`: stages, base, edits, cursor, version, and the stats of every step.
- `track/`, `straighten/`, `fuse/`: each stage's `process_recording` output (`mesh.ply`, `trajectory.csv`, `report.json`, `laser_points.ply`, `marker_map.json` in marker mode). `straighten/` also holds `straighten.json`; `process/straighten.json` is the last loop-closure report, also when the stage was skipped.
- `cache/base.npz` and `cache/<edit id>.npz`: the base and the mesh after each edit within 10 steps of the cursor (V float32, F int32, vertex normals float16; about 21 MB per step at 1M triangles).
- `selections/<edit id>.npy`: the face indices of a delete / keep edit, to replay it.
- A new base also copies the stage's `report.json`, `trajectory.csv`, `laser_points.ply` and `marker_map.json` into `result/`, and updates the scan's `report` summary and `quality`.
- The current mesh in `result/` is written to a temporary file and renamed, so a download never sees half a file. `mesh.ply` carries area-weighted vertex normals and, when the mesh has them, each vertex's sigma (`quality`, see "Confidence" below).
- **A scan processed before M3** (`result/mesh.ply` but no `state.json`) is taken over on first access: its result becomes the `track` stage (done) and the base, version 1.

**ProcessState**
- `current.mesh_url` is `/api/projects/{pid}/scans/{sid}/files/mesh.ply`, the M1 file. The files route sends `Cache-Control: no-cache` and ignores a query, so `?v=<version>` can be appended.
- `current.version` starts at 1 with the first base. It goes up by 1 on every change of the current mesh: a new base, an edit, an undo, a redo, and the clearing of the edits by a recipe.
- `busy` reads "Tracking the scan…", "Straightening…", "Fusing…", "Refining from the images…", "Refining with the laser lines…", "Making the mesh…", "Applying the recipe Body panel…", "Removing floaters…", "Filling holes…", "Smoothing…", "Simplifying…", "Deleting the selection…" or "Keeping the selection…".
- `job` is the scan's running processing job, or null. A `process` message is also sent with every update of that job (at most 5 per second), so its `job.progress` is current.
- Stages:
  - `when` is when the stage last finished; `job_id` is the job that ran it (for a recipe or Make mesh, that job's id).
  - `track.tracked_pct` is 0–100. *extra*: `track.voxel_mm`, the voxel size a recipe asked for (null = the quality's default).
  - `straighten.loops` is the engine's `loops_accepted`; `correction_mm` / `correction_deg` are its largest change of a camera position / orientation.
  - `fuse.voxel_mm` is the voxel size actually used.
  - A new track resets straighten, fuse and both refinements to `none`, a new straighten resets fuse and the refinements (they built on the old poses), a new fuse resets the refinements, and a new `spacetime` resets `refine`.
- A cancelled stage returns to its previous state, and its files are untouched. A failed stage is `failed` with the reason as its `summary`; the base and the edits stay.

**Stages**
- **The base keeps every piece.** The M1 filter that dropped pieces under 1 % of the triangles is no longer part of tracking, so removing floaters is an edit you can see and undo. The Default recipe removes the same pieces (see Recipes).
- `POST .../process/track`: `quality` defaults to `"standard"`; anything but `"standard"`, `"best"`, `"preview"` and `"full"` is 422.
- `POST .../process/straighten`: the body is optional. It runs `ohs.track.posegraph.straighten_trajectory` on the track stage's trajectory, then fuses at the corrected poses (`process_recording(poses=...)`). The stage is `skipped`, and the base and edits stay, when:
  - the engine's loop closure is missing ("Straightening is not available in this version of the engine, so the scan was left as it is") or fails ("Straightening failed (…), so the scan was left as it is");
  - it accepts no loop;
  - its loops show that the passes already line up (report `changed: false`).

  The `summary` is then the engine's verdict, e.g. "No loops found: to let Studio straighten a scan, pass over an earlier part again.". When straightening worked, the stage is `done` and its summary is the verdict, e.g. "Closed 4 loops: the end moved 1.8 mm into place.".
  - **Laser crossings** (M3 phase 3, research plan 7.3): after the loops, Straighten lines the poses up where the laser lines of different frames cross (`ohs.track.curve_ba.laser_curve_adjustment`, with the loops' fuse, or the track's mesh without loops, as the reference surface). It changes the poses only when, fitted on half the crossings, the other half meet clearly better; then it fuses again. So the stage can be `done` without loops: "No loops found, but the laser lines cross: lined the scan up on 597 laser crossings (median miss 0.10 -> 0.04 mm, the camera moved by up to 1.1 mm)". With loops, that part follows the loops' verdict after "; then". *extra*: `straighten.crossings`, the crossings used (null when they changed nothing). `straighten.json` gets a `laser_curves` section with the full numbers.
- `POST .../process/fuse`:
  - `voxel_mm` must be 0.25–10 (else 422); null means the track's voxel size.
  - It fuses at the track stage's resolution (its quality), at the given poses, so exactly the frames the track processed.
  - The poses are the straightened ones when straighten is `done`, else the track's tracked frames.
- `POST .../process/refine` ("Refine with lasers", M3 phase 3): the body is optional; 409 without a finished Track.
  - It takes the mesh of the stage that made the base (`source`; when the base is already refined, the mesh it refined) and that stage's `laser_points.ply`, and moves the vertices along their normals by a smooth correction where the laser lines disagree with the surface (`ohs.mesh.anchor_to_points`). Laser points off the surface (more than 2 mm, or rejected by the robust fit) are `outliers`.
  - It is `skipped`, and the base and edits stay, when the scan has fewer than 200 laser points ("This scan has no laser points (the lasers were off or not calibrated), so the mesh was left as it is") or when less than 1 % of the surface would move ("The mesh already agrees with the laser lines (0.08 mm median difference over 65,643 points), so nothing was changed").
  - When it moves the mesh, it is `done`, the refined mesh becomes the base (each vertex keeps its sigma), and the summary says by how much, e.g. "Pulled 9.7 % of the surface onto 65,589 laser points, by up to 0.50 mm (95 %); the median difference fell from 0.41 to 0.07 mm". `report.json` gets a `refine` section with the full numbers.
  - A new track, straighten (when it changes the poses) or fuse resets it. Recipes run it after Straighten when `settings.refine` is `"auto"` (the default; "Quick preview" has `"off"`), so Make mesh refines too; when it fails there, the recipe goes on with the fused mesh.
- `POST .../process/spacetime` ("Refine from the images", M3 phase 3 item 5, a **trial build**): the body is optional; 409 without a finished Track.
  - It takes the mesh of the stage that made the base (`source`: when the base is refined by either refinement, the mesh before it) and up to 120 frames of the recording with a pose (the straightened poses when Straighten is `done`), rectified at full resolution, and measures the surface against them (`ohs.track.spacetime.refine_from_images`, research plan 7.2): small patches of the surface are searched along their normals for where the left and right images of every frame agree best. Where a patch holds dots in at least 16 frames and its match is clear, the vertices around it move onto the measured surface; elsewhere the mesh stays as fused.
  - It runs on the GPU when there is one (about 10 s for 36 frames on a Radeon 680M); without one the same search runs on the CPU, much more slowly.
  - It is `skipped`, and the base and edits stay, when fewer than 50 patches (or 1 % of the surface) qualify ("Too few parts of the surface hold dots in enough frames (0 of 9,875 patches), so the mesh was left as it is").
  - When it moves the mesh, it is `done`, the refined mesh becomes the base (each vertex keeps its sigma), and the summary says how much, e.g. "Measured 45 % of the surface against 36 frames (20,338 patches, on the GPU); it moved by up to 0.12 mm (95 %)". `report.json` gets a `spacetime` section with the full numbers.
  - It resets `refine`: run it before Refine with lasers. Recipes and Make mesh don't run it (a trial build).
- **Laser points** are also checked per frame against that frame's dense depth (`ohs.vision.laser.depth_check`: within 4 sigma, at least 1 mm, at the point's pixel or 6 px to a side). The report counts the dropped ones as `lasers.n_rejected_by_depth`.
- **Scan status:** stage jobs and recipe `all` jobs set the scan to `processing`. Afterwards it is `processed` when it has a mesh, else `failed` (with `error`) or `recorded`. Edit jobs leave the status alone.
- **Make mesh** (`POST .../process`) is the Default recipe with scope `all` at the requested quality. Its job kind (`process_scan`), result `{project_id, scan_id, scan, message: "Mesh ready"}` and statuses are M1's.
  - Second Make mesh on the same scan: 409 "this scan is already being processed".
  - Any other processing job running on the scan: 409 "this scan is busy (…)".

**Jobs**
- Kinds: `process_track`, `process_straighten`, `process_fuse`, `process_spacetime`, `process_refine`, `mesh_edit`, `process_recipe` (the contract leaves the recipe kind open) and `process_scan`.
- *extra* job fields: `project_id`, `scan_id`, plus:
  - `quality` (track, Make mesh);
  - `op` (edits);
  - `voxel_mm` (fuse);
  - `recipe_id`, `recipe_name`, `scope` (recipes).
- Results:
  - stage jobs and recipe `all`: `{project_id, scan_id, scan, message}`, where `message` is the stage's summary;
  - `mesh_edit`: `{project_id, scan_id, edit: EditEntry, message}`;
  - recipe `edits`: `{project_id, scan_id, recipe_id, message}`.
- Progress messages read like "Tracking: frame 12 of 696 on the GPU (…)", "Fill holes up to 12 mm: Filling hole 3 of 40" or "Simplify to 200,000 triangles: Simplifying: 412,000 triangles".

**Edits**
- `params` in an `EditEntry` are normalised (defaults filled in). For `delete_faces` / `keep_faces` they are `{"count": n}`: the indices themselves are kept in `selections/`.
- *extra* `EditEntry` fields:
  - `summary`: what the edit did, e.g. "Removed 12 loose pieces (3,410 triangles)", "Filled 3 holes (412 new triangles)", "Moved the surface by 0.012 mm on average and 0.08 mm at most", "1,204,311 -> 200,000 triangles";
  - `job_id`.
- Labels:
  - "Remove loose pieces smaller than 5 mm or under 1 % of the mesh";
  - "Keep the largest piece only";
  - "Fill holes up to 12 mm";
  - "Smooth (bilateral, 50 %, edges kept)";
  - "Simplify to 200,000 triangles", "Simplify to 50 % of the triangles" or "Simplify to within 0.02 mm";
  - "Delete 1,234 triangles" or "Keep 1,234 triangles".
- `remove_floaters`:
  - A piece is a set of faces connected through shared edges; the largest piece is the one with the most triangles. A lone triangle or a flap that touches the surface at one vertex only is a piece of its own (since 2026-11-13; before, pieces were connected through shared vertices and such a flap counted as surface).
  - `min_size_mm` compares the diagonal of the piece's bounding box. *extra* `min_fraction` (0–1) compares the piece's share of all triangles.
  - The given limits combine with "or".
  - `{}` means `{min_size_mm: 5}`, and `keep_largest_only` ignores the other limits.
  - The largest piece is never removed.
- `fill_holes`:
  - `max_hole_mm` is the hole's perimeter.
  - Outer borders are left open (see MeshStats), unless `watertight` (M3 phase 3): then every opening up to `max_hole_mm` is closed, the outer edge too ("Make watertight: close every opening up to 60 mm"). The summary says whether the mesh is now watertight, or how many openings are still larger than the limit.
  - New vertices are added only where the hole is wider than the mesh around it, so pin holes get a few triangles and larger holes a smooth patch. A smooth patch that would leave the hole (more than 1.25 hole radii from its centre) becomes a flat "soap film" instead.
  - **Filled faces are flagged** (M3 phase 3): `mesh.ply` gets the face property `uchar filled` (1 = made by hole filling, not measured), the flags follow every later edit, and `MeshStats.filled_cm2` adds up their area. The viewer and the Process page draw them striped grey, and the viewer's distance tool won't put a point on them.
- `smooth`:
  - `keep_edges` defaults to true; `strength` must be 0–1.
  - Strength sets the work: Taubin `1 + 49 s` iterations; bilateral `2 + 18 s` normal and `5 + 15 s` vertex iterations.
  - `within_sigma` (M3 phase 3; the Process page sends it by default when the mesh has sigmas, and the Body panel and Bracket recipes use it): no vertex moves more than twice its own sigma; a longer move is shortened. Without sigmas it does nothing.
- `decimate`:
  - Send at most one of `target_triangles` (at least 4) or `ratio` (above 0, at most 1), and / or `max_error_mm` (0.001–10). A target at or above the current count changes nothing.
  - `max_error_mm` (M3 phase 3) simplifies only while the surface stays within that tolerance, with the outer edge and folds held; with a target too, whichever stops first.
  - The summary measures how far every old vertex now lies from the new surface: "855,246 -> 473,148 triangles; the surface moved at most 0.062 mm (0.016 mm for 99.9 % of it)".
- `delete_faces` / `keep_faces`:
  - `faces` is base64 of little-endian uint32; duplicates are ignored.
  - They are checked against the current mesh when posted. An index the mesh does not have, bad base64, a length that is not a multiple of 4, or an empty selection is 422.
  - The edits body may carry a top-level `version`: the `current.version` the selection was made on. When it is given and is not the current version, any edit is refused with 409 "the mesh changed since you selected (version N, now M)", hint "select again on the current mesh".
- **Failed and empty edits:**
  - An edit that would leave no triangle fails ("this would remove the whole mesh"), and the mesh stays as it was.
  - The redo steps are dropped only when the new edit succeeds.
  - An edit that matches nothing is still recorded, with a summary saying so, and its version counts.
- Parameter errors are 422 naming the parameter, e.g. "fill_holes: max_hole_mm is missing", "remove_floaters: unknown parameter 'size'".

**Undo / redo**
- The last 10 steps around the cursor are cached on disk, with their normals, so undo and redo only load the step and write `mesh.ply` + `mesh.stl`: about 0.3 s per step at 1.3M triangles.
- A step outside the cache is rebuilt in the request by replaying the edits from the nearest cached step, which takes as long as those edits.
- Repeated calls are safe: each moves one step and answers with the new state, and past either end it is 409 "nothing to undo" / "nothing to redo" with nothing changed. Also 409 while any processing job of the scan runs.

**MeshStats**
- `components` counts the pieces with faces (faces connected through shared vertices).
- **Outer borders:**
  - Every open piece's longest boundary loop is its outer border, not a hole.
  - A *nearly closed* piece has no outer border: one whose longest loop could be capped with less than a fifth of the piece's area (perimeter² / 4π < 0.2 × area). All its loops are holes, so a part scanned all round can have its last hole filled.
  - Small loose pieces therefore never count as holes.
- `border_mm` is the longest outer border.
- Where two loops touch at one vertex, they are separated by walking around that vertex.
- A boundary chain that cannot be closed (inconsistently oriented faces) counts as a hole but is never filled.
- Rounding: perimeters and `bbox_mm` to 0.01 mm, `area_cm2` to 0.01 cm², `volume_cm3` to 0.001 cm³ (the absolute volume).

**Confidence (per-vertex sigma)**
- A mesh made by the confidence reconstruction (the default with a GPU; report `mesh.reconstruction`) gives each vertex its standard deviation in mm. `mesh.ply` carries it as the vertex property `float quality`, which MeshLab reads too; STL and OBJ have no place for it. A sigma of 50 mm means "nothing measured it", and caps the rest.
- Every step keeps it: smoothing moves the vertices, which keep their sigma; filled holes are 50 mm; deleting or keeping faces keeps the vertices left; removing floaters and simplifying take the nearest vertex's sigma from the step before. The cache stores it with each step.
- `MeshStats.sigma_mm` sums it up, area-weighted (each vertex stands for a third of its triangles' area). It is `null` for meshes without sigmas: made without a GPU, by Poisson, or before this version (run Track again to get them).
- The processing report has the same summary for the fused mesh, as `mesh.sigma_mm`.

**Recipes**
- Built-ins, in this order:
  - `default`: standard quality, straighten `auto`, then remove loose pieces under 5 mm or 1 % of the mesh and fill holes up to 5 mm. No smoothing and no simplification.
  - `body-panel`: the same, then holes up to 15 mm and bilateral smoothing at 0.5 with `keep_edges`.
  - `bracket`: the same as `default`, then bilateral smoothing at 0.25 with `keep_edges`.
  - `quick-preview`: preview quality, straighten `off`, remove loose pieces, simplify to 200,000 triangles.
- User recipes are `<data_dir>/recipes/<id>.json`, where the id is a slug of the name plus 4 hex digits (*extra* `created` in the file). They are listed after the built-ins, sorted by name.
- `POST /api/recipes`:
  - `name` is required (400 when empty, at most 80 characters); `description` is optional (at most 500 characters).
  - With `from_scan`:
    - `quality` is the track stage's;
    - `straighten` is `auto` when the straighten stage ran (done or skipped), else `off`;
    - `voxel_mm` is the fuse stage's when the base came from fuse, else the track's;
    - `ops` are the active edits, without the selections.
    - 409 if the scan has no mesh.
  - Otherwise `settings` and `ops` are both required (422).
  - Ops are validated like edits, at most 30. `delete_faces` / `keep_faces` are refused (422): a selection belongs to one scan.
- A recipe's `voxel_mm` is used by its track (and straighten) stage; a recipe never runs a separate fuse stage.
- `POST .../process/recipe`:
  - `edits` first clears the edits, then applies each op as an edit of its own. Undo steps back through them; the edits from before the recipe are gone. If an op fails, the ones before it stay.
  - `all` runs track at the recipe's quality, straighten when `auto`, then the ops.
  - 404 for an unknown recipe.
- `DELETE /api/recipes/{id}`: 204, 409 for a built-in, 404 when unknown.

**Overlays**
- `holes.json` (409 before there is a mesh):
  - the holes of `MeshStats.holes`: outer borders are left out;
  - the 500 largest holes, largest first;
  - `points` has `n_edges + 1` points, the first repeated at the end, so it draws as a closed line with any line primitive;
  - coordinates are rounded to 0.01 mm.
- `trajectory.json` (404 before a track):
  - `raw` is the track stage's tracked camera positions: every k-th, at most 2000, the last always included.
  - `straightened` holds the same frames after straightening, or null unless straighten is `done`.
  - `loops` are the engine's loop frame pairs, mapped to the nearest `raw` entries.
  - *extra* `frames`: the frame index of each `raw` point.

**WebSocket**
- `process` messages are latest-only per scan.
- New clients get the `process` state of every scan with a running processing job.
- `hello.version` and `health.api` are `"0.3.0"`.

**Errors besides 409:** 404 for an unknown project, scan or recipe; 422 for invalid bodies and parameters; 500 when the process folder lost its base mesh (run the stage again).

**Speed** of the mesh operations on 1.3M triangles (Ryzen 7 7735U, CPU only):

| Operation | Time |
|---|---|
| Stats | 1.3 s |
| Remove floaters | 0.3 s (about 1.1 s on 1.7 million triangles since pieces are counted by shared edges, 2026-11-13; 0.45 s before) |
| Fill holes up to 5 mm / 80 mm | 1.5 s / 3.4 s |
| Smooth: Taubin 0.5 (with `keep_edges`) | 1.8 s (3.7 s) |
| Smooth: bilateral 0.5 / 1.0 | 5.0 s / 9.1 s |
| Simplify to 200k | 9.2 s |
| Delete / keep a selection | 0.05 s |
| Undo / redo | 0.3 s |

An edit job adds about 2 s at this size: stats, normals, the cached step and the result files.

## M5 first slice: fitted shapes
The plan is in [`DESKTOP_APP_PLAN.md`](DESKTOP_APP_PLAN.md), "M5 plan, first slice". The fits work on the
scan's current mesh, the one the viewer shows (`result/mesh.ply`, `ProcessState.current.version`).

### Types
```ts
type FitKind = "plane" | "cylinder" | "hole";
type FitRequest = {
  kind: FitKind;
  face: number;                        // the clicked face of result/mesh.ply
  point: [number, number, number];     // the clicked point on it (mm, the mesh's frame)
  tolerance_mm?: number | null;        // null = chosen from the seed's measured scatter (and sigma, when it agrees)
  version?: number;                    // the mesh version the click was made on: 409 when it is no longer current
};
// All ± values are 1σ, statistical only (calibration and scale errors come on top).
type PlaneShape = { kind: "plane"; point: number[]; normal: number[]; rms_mm: number; flatness_mm: number; n: number;
                    normal_sigma_deg: number; offset_sigma_mm: number };
type CylinderShape = { kind: "cylinder"; point: number[]; axis: number[]; radius_mm: number; diameter_mm: number;
                       rms_mm: number; n: number; radius_sigma_mm: number; diameter_sigma_mm: number;
                       axis_sigma_deg: number; point_sigma_mm: number };
type CircleShape = { kind: "circle"; center: number[]; normal: number[]; radius_mm: number; diameter_mm: number;
                     rms_mm: number; n: number; radius_sigma_mm: number; diameter_sigma_mm: number; center_sigma_mm: number };
type FitResult = {
  kind: FitKind;                        // as asked; a hole's shape is a circle
  shape: PlaneShape | CylinderShape | CircleShape;
  faces: string;                        // the region: base64 of little-endian uint32 face indices, sorted
  n_faces: number;
  tolerance_mm: number | null;          // the tolerance used (null for a hole)
  mean_sigma_mm: number | null;         // mean sigma of the fitted points (null when the mesh has none)
  warnings: string[];                   // plain language, e.g. "small region: 23 points"
  version: number;                      // the mesh version it was fitted on
};
```

### REST
Paths are relative to `/api/projects/{pid}/scans/{sid}`.

| Method and path | Body | Returns |
|---|---|---|
| `POST .../fit` | `FitRequest` | `FitResult` |

Rules:
- 409 before the scan has a mesh (as `holes.json`).
- 422 for an unknown kind, a face outside the mesh, or when no such shape is found there; the
  detail says why and the hint what to try (e.g. "click on the wall of the bore and choose
  Cylinder").
- 409 when `version` is given and the mesh has changed since (reload it and click again).
- A hole is always a circle; a click on a scanned bore wall answers 422 with the hint to use Cylinder.
- Face indices are those of `result/mesh.ply` (polygon faces as in the file, like `delete_faces`).
- Read-only and quick (well under a second on a 1M-triangle mesh); it does not wait for a running
  edit job of the scan: it uses the current version and says which in `version`.

## M5 second slice: the deviation map
The plan is in [`DESKTOP_APP_PLAN.md`](DESKTOP_APP_PLAN.md), "M5 plan, second slice". It compares the scan's
current mesh with its base mesh: the last stage's result, before any edit.

```ts
type DeviationInfo = {
  version: number;                      // the mesh version it was made for
  vertices: number;                     // values in deviation.bin = vertices of result/mesh.ply
  edits: number;                        // the cursor: 0 = no edits, every value is 0
  reference: { stage: string; triangles: number; vertices: number };   // the base mesh
  stats: { n: number; new: number;      // compared vertices; vertices of filled faces only (no value)
           rms_mm: number | null; mean_mm: number | null;               // mean: signed
           p50_mm: number | null; p95_mm: number | null; p99_mm: number | null; max_mm: number | null;  // of |move|
           moved: number | null };      // share moved by more than 0.01 mm; the numbers are null when n = 0
};
```

Paths are relative to `/api/projects/{pid}/scans/{sid}`.

| Method and path | Returns |
|---|---|
| `GET .../process/deviation.json` | `DeviationInfo` |
| `GET .../process/deviation.bin` | one little-endian float32 per vertex of `result/mesh.ply`, in its order: the signed distance to the base mesh in mm (+ outward along the base's normal, - inward), NaN for a vertex that only filled faces use. The header `X-OHS-Mesh-Version` has the version. |

Rules:
- 409 before the scan has a mesh.
- Made once per mesh version (about 1.5 s for 1M vertices against 2M triangles), then kept; a second
  request during the first waits for it.

## M5 fourth slice: where the lasers and the mesh disagree
[`ROADMAP.md`](ROADMAP.md), section 3, item 4. The laser lines are triangulated on their calibrated planes,
independently of the stereo depth that makes the mesh. This map shows how far the two are apart on the scan's
current mesh (`ohs.mesh.laser_agreement`). It moves nothing: "Refine with lasers" does that.

```ts
type LaserInfo = {
  version: number;                      // the mesh version it was made for
  vertices: number;                     // values in lasers.bin = vertices of result/mesh.ply
  available: boolean;                   // false: this scan has no laser points (the lasers were off or not calibrated)
  gate_mm: number;                      // laser points farther than this from the surface are left out as stray (3)
  points: { total: number;              // laser points of the scan (result/laser_points.ply)
            on_surface: number;         // those that fall on the mesh (not past an edge or over a hole)
            used: number;               // those within gate_mm: they make the map
            stray: number };            // on the surface but farther than gate_mm (glints, reflections)
  stats: { n: number;                   // vertices with a value
           covered: number | null;      // share of the surface (by area) that has a value, 0..1
           mean_mm: number | null;      // signed mean
           rms_mm: number | null; p50_mm: number | null; p95_mm: number | null; max_mm: number | null;  // of |distance|
           within_0_1: number | null;   // share of the vertices with a value that are within 0.1 mm
           within_0_3: number | null }; // ... within 0.3 mm; the numbers are null when n = 0
};
```

Paths are relative to `/api/projects/{pid}/scans/{sid}`.

| Method and path | Returns |
|---|---|
| `GET .../process/lasers.json` | `LaserInfo` |
| `GET .../process/lasers.bin` | one little-endian float32 per vertex of `result/mesh.ply`, in its order: the mean signed distance in mm from the mesh to the laser points nearest that vertex, along the vertex normal (+ = the lasers see the surface further out than the mesh, - = further in); NaN where no laser point came near. The header `X-OHS-Mesh-Version` has the version. |

Rules:
- 409 before the scan has a mesh. With `available: false` every value is NaN.
- A laser point belongs to its nearest vertex. One that projects more than 1.5 median edges from that vertex is
  off the mesh and ignored.
- Made once per mesh version (1.2–2.1 s for 0.6–0.8 million vertices and 150,000 laser points), then kept; a
  second request during the first waits for it.
- On simulated scans at Standard quality the lines cover 8–9 % of the surface, and there the mesh and the lasers
  agree within 0.1 mm for 62–69 % of the vertices and within 0.3 mm for 91–97 % (median 0.06–0.07 mm).

## M5 third slice: areas that need another pass
The plan is in [`DESKTOP_APP_PLAN.md`](DESKTOP_APP_PLAN.md), "M5 plan, third slice". It works on the scan's
current mesh.

```ts
type CheckArea = {
  kind: "uncertain" | "not_measured";  // 2 sigma above the tolerance | made up by hole filling (or no sigma there)
  area_mm2: number; share: number;      // share of the whole surface, 0..1
  center: [number, number, number];     // area-weighted, mm
  extent_mm: number; radius_mm: number; // largest side of its bounding box; farthest vertex from the centre
  n_faces: number;
  sigma_median_mm: number | null; sigma_worst_mm: number | null;   // over its measured vertices
  faces: string;                        // base64 of little-endian uint32 face indices of result/mesh.ply, sorted
};
type CheckResult = {
  version: number; tolerance_mm: number; k: number;                 // k = 2: a face fails when k x its mean sigma > tolerance
  has_sigma: boolean;                   // false: this mesh has no confidence values (made without a GPU)
  area_mm2: number; min_area_mm2: number;                           // the whole surface; smaller areas are not listed
  share_ok: number | null; share_uncertain: number | null;          // null when has_sigma is false
  share_not_measured: number | null;
  n_areas: number;                      // all areas above the minimum
  areas: CheckArea[];                   // largest first, at most 50
};
```

| Method and path | Body | Returns |
|---|---|---|
| `POST /api/projects/{pid}/scans/{sid}/check` | `{tolerance_mm}` (above 0, at most 100) | `CheckResult` |

Rules: 409 before the scan has a mesh; 422 for a bad tolerance. Read-only and quick (about 0.5 s on a
2M-triangle mesh). The answer rests on each vertex's sigma: statistical, and so far checked on
simulated scans only (`VALIDATION.md`).
