jessiepullaro414/Scan/docs/screenshots/01-live-scan.png

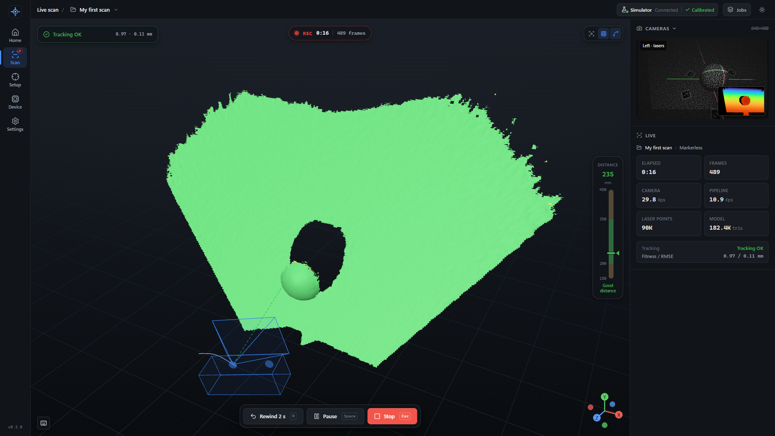
docs/screenshots/01-live-scan.png
