jessiepullaro414/Scan/docs/screenshots/04-process-studio.png

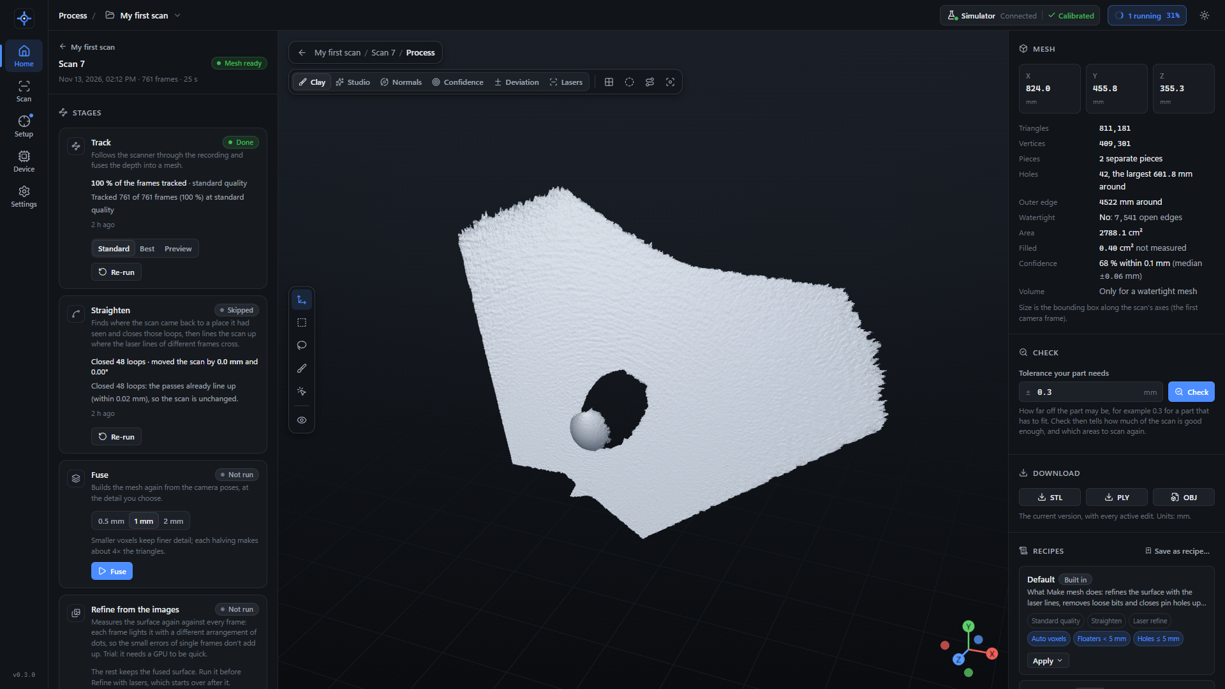
docs/screenshots/04-process-studio.png
