jessiepullaro414/Scan/renders/rear.png

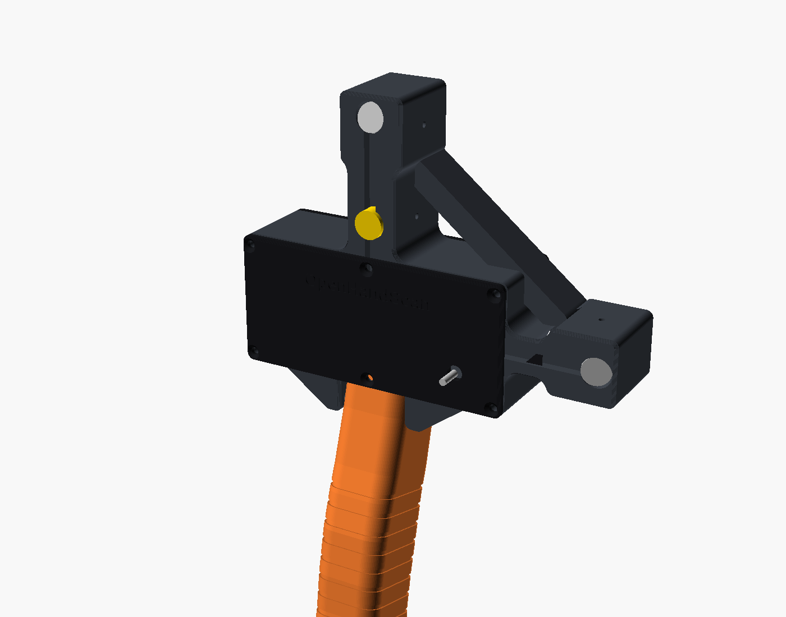
renders/rear.png
