jessiepullaro414/Scan/renders/side_led.png

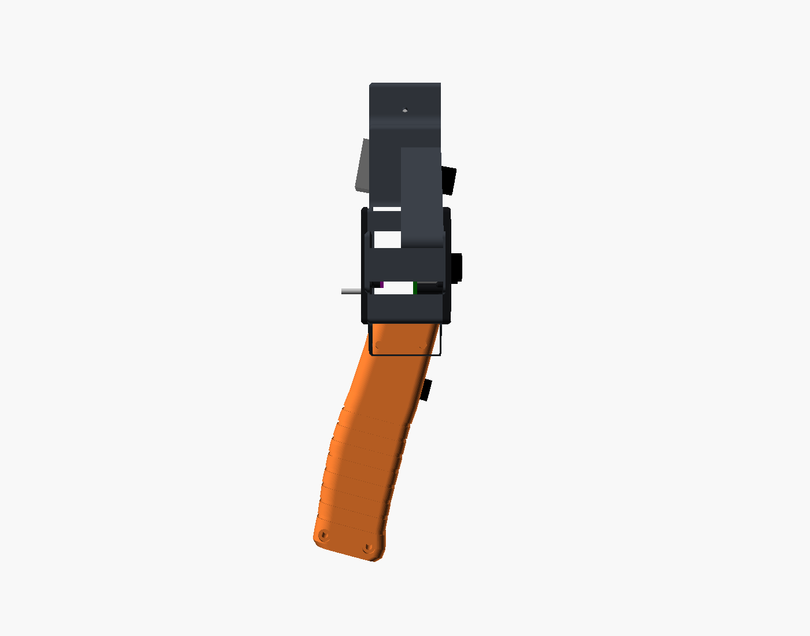
renders/side_led.png
