jessiepullaro414/Scan/PARTS.md

# OpenHandScan: parts order list (US)

Links collected November 2026. Prices change; check before you order.

Each link has a **Status**:
- **✔ loaded**: the page was opened and matches the spec.
- **search**: the URL came from search results; the page itself wasn't opened (often Amazon blocked it). Check the listing title before buying.
- **Amazon search**: a commodity part where any listing matching the spec is fine.

## Order these

| # | Part | Qty | Buy here | Backup | Price seen | Status |
|---|---|---|---|---|---|---|
| 1 | **Stereo camera**: ELP dual-lens, hardware-synced, global-shutter OV9281 mono, USB, "83° no distortion" lens | 1 | [Amazon B0D9VY8JG4](https://www.amazon.com/ELP-Monochrome-Synchronization-OmniVision-Distortion/dp/B0D9VY8JG4) | [hdusbcameras (ELP)](https://www.hdusbcameras.com/elp-ov9281-global-shutter-stereo-usb-camera-module-monochrome-120fps-at-800x600-210fps-at-320x240-hardware-synchronized-for-robotics-3d-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) | ~$100–150 | search |
| 2 | **Line laser module** 650 nm 5 mW, Ø12 mm, 3–5 V, adjustable focus (glass lens if offered) | 2 (+spare) | [Amazon search](https://www.amazon.com/s?k=650nm+5mW+line+laser+module+12mm+adjustable+focus) | [Phipps (ships from Australia)](https://www.phippselectronics.com/product/650nm-5mw-red-line-laser-module-with-adjustable-focus-5v-industrial-grade/) | ~$8–15 per pack | Amazon search |
| 3–4 | **Pattern projector**: pick **option A** or **option B** from the tables below | — | — | — | — | — |
| 5 | Raspberry Pi Pico (no headers) | 1 | [Adafruit 4864](https://www.adafruit.com/product/4864) | — | $4.00 | ✔ loaded |
| 5b | **Instead of 5:** Waveshare ESP32-S3-Pico (no headers, SKU 23803); needs a USB-C data cable. Same wiring; not yet tried on a real board | 1 | [Amazon search](https://www.amazon.com/s?k=Waveshare+ESP32-S3-Pico) | [Waveshare](https://www.waveshare.com/esp32-s3-pico.htm?sku=23803) | ~$9 | Amazon search |
| 6 | IMU: Adafruit LSM6DSOX 6-DoF | 1 | [Adafruit 4438](https://www.adafruit.com/product/4438) | — | $11.95 | ✔ loaded |
| 7 | Trigger: 16 mm panel-mount momentary pushbutton | 1 | [Adafruit 1504 (green)](https://www.adafruit.com/products/1504) | [1503 (burgundy)](https://www.adafruit.com/products/1503) | ~$1 | search |
| 8 | Laser kill switch: MTS-102 mini toggle (SPDT, 2-position ON-ON) | 1 | [Amazon search](https://www.amazon.com/s?k=MTS-102+mini+toggle+switch) | — | ~$7 per pack | Amazon search |
| 9 | NPN transistors PN2222 (10-pack) | 3 | [Adafruit 756](https://www.adafruit.com/product/756) | — | $1.95 | ✔ loaded |
| 10 | 1 kΩ resistors (25-pack) | 3 | [Adafruit 4294](https://www.adafruit.com/product/4294) | [Jameco](https://www.jameco.com/z/4294-Adafruit-Industries-Through-Hole-Resistors-1-0K-Ohm-5-1-4W-Pack-of-25_2517951.html) | $0.75 | ✔ loaded |
| 11 | 26 AWG silicone wire (get 3 colours) | 3 spools | [Adafruit 2514 (blue)](https://www.adafruit.com/product/2514) | other colours: Adafruit 2517 black / 2516 green / 2518 white (IDs not checked) | $4.95 each | ✔ loaded (2514) |
| 12 | Heat-shrink assortment | 1 | [Adafruit 4559](https://www.adafruit.com/product/4559) | — | $9.95 | ✔ loaded |
| 13 | Micro-USB **data** cable, ~2 m (for the Pico) | 1 | [Amazon search](https://www.amazon.com/s?k=micro+usb+data+cable+6ft) | — | ~$8 | Amazon search |
| 14 | M3 heat-set inserts, M3 × 5.7, OD 4.6 (100) | 22 used | [Prusa 100 pcs](https://www.prusa3d.com/en/product/threaded-inserts-m3-standard-100-pcs/) | [VXB (US)](https://vxb.com/products/100-pcs-m3-brass-heat-set-threaded-inserts-for-3d) | $10.99 / $19.99 | search |
| 15 | M3 socket-head screw kit (must include 10, 12, 16 mm) | 1 | [Amazon search](https://www.amazon.com/s?k=M3+socket+head+cap+screw+assortment+kit+8mm+10mm+12mm+16mm) | — | ~$12 | Amazon search |
| 15b | M3 × 8 flat-head (countersunk) screws, black, for the faceplate and back cover | 12 used | [Amazon search](https://www.amazon.com/s?k=M3+x+8mm+flat+head+countersunk+socket+screw+black) | — | ~$7 | Amazon search |
| 16 | M2 + M2.5 screw kit (M2×5–6, M2.5×5) | 1 | [Amazon search](https://www.amazon.com/s?k=M2+M2.5+socket+head+screw+assortment+kit) | — | ~$12 | Amazon search |
| 17 | ASA filament 1.75 mm, 1 kg, black | 1 | [MatterHackers: Polymaker PolyLite ASA](https://www.matterhackers.com/store/l/polymaker-polylite-asa-black-175mm-1kg/sk/M4QCXUKG) | [B&H](https://www.bhphotovideo.com/c/product/1721180-REG/polymaker_pf01001_polylite_asa_1_75mm_1000g.html) | ~$30 | ✔ loaded (MH) |
| 18 | AESUB Blue vanishing scanning spray | 1 | [UMAX (US only)](https://umax.com/products/aesub-blue-scanning-spray-universal-self-evaporating-3d-scanning-spray.html) | [Einstar US](https://us.einstar.com/products/aesub-blue-spray) | $39.99 | search |
| 19 | Removable full-sheet label paper (for printing AprilTag stickers) | 1 pack | [Avery 6465 at Staples](https://www.staples.com/Avery-reg-6465-Removable-Inkjet-Laser-Labels-8-1-2-x-11-25-Pack/product_859654) | [Avery 6470 at Office Depot](https://www.officedepot.com/a/products/580826/Avery-Removable-Full-Sheet-Labels-6470) | — | search |
| 20 | 8.5×11 in picture frame with **real glass** (flat backing for the calibration board) | 1 | [Amazon search](https://www.amazon.com/s?k=8.5x11+picture+frame+real+glass) | — | ~$10 | Amazon search |
| 21 | 150 mm digital calipers | 1 | [iGaging at Walmart](https://www.walmart.com/ip/18872621958) | [Amazon search](https://www.amazon.com/s?k=6+inch+digital+caliper) | ~$25–46 | search |

## Pattern projector: two options

Both options plug into the same Pico channel (GP6), and the software works with either. Print `head.stl` for option A, or `head_led.stl` + `led_cartridge.stl` for option B.

| | **Option A: laser + DOE** | **Option B: LED + printed mask** |
|---|---|---|
| How it works | 650 nm dot laser through a 10k random-dot diffractive element | Red LED backlights a random-dot mask, projected by a 3.6 mm M12 lens |
| Simulated depth accuracy (median) | 0.11–0.18 % (≈0.3–0.45 mm at 250 mm) | 0.23–0.27 % with a film mask (≈0.6 mm), 0.31–0.46 % with a printed mask |
| Depth coverage of the view | 92–98 % | 73–97 % |
| Sourcing | Lasermate DOE is quote-only, single source | All commodity parts, and you print the mask yourself |
| Cost | ~$16 laser + DOE (quote) | ~$30 |

### Option A: laser + DOE

| Part | Qty | Buy here | Backup | Price seen | Status |
|---|---|---|---|---|---|
| Dot laser module, 650 nm 5 mW, Ø12 mm, 3–5 V, adjustable focus | 1 (+spare) | [Amazon search](https://www.amazon.com/s?k=650nm+5mW+dot+laser+module+12mm+adjustable+focus) | [Phipps (ships from Australia)](https://www.phippselectronics.com/product/5mw-650nm-red-dot-laser-module-focus-adjustable-laser-head-5v-industrial-grade/) | ~$8–15 per pack | Amazon search |
| Random-dot DOE: Lasermate DOE-RD10K650 (10k dots, 650 nm, 80°×64°) | 1–2 | [Lasermate product page](https://lasermate.com/optics/diffractive-optical-element/random-dots-pattern/doe-rd10k650) | [Request a quote](https://lasermate.com/quotation-and-information-request/) | quote | ✔ loaded |
| (alternative) complete module: Lasermate MDOE650A10R103, 650 nm, 10k dots, with lens + driver | 1 | [Lasermate](https://lasermate.com/lasers/laser-modules/structured-light-laser-modules/mdoe650a10r103/) | — | quote | search |

### Option B: LED + printed mask

| Part | Qty | Buy here | Backup | Price seen | Status |
|---|---|---|---|---|---|
| Red 3 W LED on a 20 mm star: **one** LED (not "3-up"), red **620–630 nm** (not 660 nm deep red) | 1 (+spare) | [Addicore 3W Red LED on Star (ships from US stock)](https://addicore.com/products/3w-red-led-on-star-board-heatsink) | [Amazon search](https://www.amazon.com/s?k=3W+red+LED+620nm+20mm+star) | — | search |
| Heatsink 25×25×20 mm with 3M thermal tape (LEDSupply "1-inch chipset") | 1 | [LEDSupply](https://www.ledsupply.com/led-heatsinks/chipset-led-heatsink) | — | — | search |
| M12 lens, **3.6 mm**, made for 1/2.5" (or larger) sensors, e.g. Arducam M25360H06 or M25360H06S (low distortion isn't needed) | 1 | [Amazon search](https://www.amazon.com/s?k=Arducam+M12+3.6mm+lens) | [Arducam M25360H06S](https://www.arducam.com/product/m25360h06s-2/) | ~$10 | Amazon search |
| M12 lens holder, **metal, 20 mm hole spacing**: Arducam LHK01 holder kit. Use the **10 mm** tall metal one; the other heights help if the lens can't reach focus | 1 kit | [Amazon search](https://www.amazon.com/s?k=Arducam+M12+lens+holder+kit) | [Commonlands CLA020](https://commonlands.com/products/m12-lens-mount-20mm-spacing) (then print the `_cla020` parts) | — | Amazon search |
| Lens-holder screws: M2×6 from your M2 kit (Arducam holder). Only the Commonlands holder needs M1.6×6 | 2 | [Amazon search: M1.6×6](https://www.amazon.com/s?k=M1.6+x+6mm+screws) | — | — | — |
| N-MOSFET IRLB8721 (logic level) | 1 | [ProtoSupplies](https://protosupplies.com/product/irlb8721/) | — | ~$2 | search |
| 8.2 Ω 3 W resistor (LED current ≈ 340 mA) | 1 | [Amazon search](https://www.amazon.com/s?k=8.2+ohm+3W+resistor) | — | — | Amazon search |
| 10 kΩ ¼ W resistor (gate pull-down) | 1 | [Amazon search](https://www.amazon.com/s?k=10k+ohm+resistor+1%2F4W) | — | — | Amazon search |
| White diffusion film, polyester ~0.1 mm (only a 10×10 mm piece is needed) | 1 kit | [RENIAN GEL-09 kit, Amazon B08PTCGTX9](https://www.amazon.com/dp/B08PTCGTX9) | [Amazon search: LEE 216](https://www.amazon.com/s?k=LEE+216+white+diffusion+filter+sheet) | — | search (chosen by you) |
| Laser-printer transparency film (for the printed mask) | 1 pack | [Amazon search](https://www.amazon.com/s?k=laser+printer+transparency+film) | — | — | Amazon search |
| (optional, sharper) film mask from any photoplot service | 1 | send `projector_mask_film.gbr` from `ohs printables` | — | — | — |

Print the mask with `ohs printables` at 100 % on a 1200 dpi laser printer. You get 48 copies per sheet, so cut out the cleanest one.

## Optional

| Part | Link | Status |
|---|---|---|
| 650 nm laser safety glasses, OD 2+ at 630–660 nm | [MSE Supplies](https://www.msesupplies.com/products/mse-pro-laser-safety-glasses-630-660nm-od-2-800-1100nm-od-5) | search |
| Perma-Proto half-size board (for the 3 transistor circuits) | [Adafruit 1609](https://www.adafruit.com/product/1609) | ✔ loaded |
| Heat-set insert soldering tips (TS100/TS101/Pinecil) | [West3D CNC Kitchen tip set](https://west3d.com/products/cnc-kitchen-installation-tips-set-and-adapter-compatible-with-ts100-ts101) | search |
| USB 2.0 extension, 2 m (if the camera cable is short) | [Amazon search](https://www.amazon.com/s?k=usb+2.0+extension+cable+6ft) | Amazon search |

## Notes before ordering

- **Camera:**
  - ELP's own page for the same board family (model ELP-USB3DGS800P-V90, 73° lens) lists the PCB as **80 × 16.5 mm**, with MJPEG 2560×800 at 120 fps. [ELP page](http://www.elpcctv.com/elp-800p-global-shutter-monochrome-synchronous-dual-lens-usb-camera-module-m9-lens-73-degree-p-489.html) (quote only).
  - The lens spacing (baseline) and mounting holes are **not published**. Measured on the real board: lenses 60 mm apart, four M2 corner holes (see "Stereo board measurements" in README.md).
  - On Windows it delivers 2560×800 MJPG at about 46–55 fps through DirectShow (its MJPG decoder is the limit), not 60 or 120.
  - Lens options run from 63° to 86°. Choose the ~83–86° "no distortion" version if offered.
- **Camera IR filter vs 650 nm lasers:**
  - Reviews say the ELP stereo camera has an IR-cut filter. Common ones cut off around 650 nm, which is right where the lasers are. Expect the laser lines (and the option-A dots) to come through dimmer, and to vary a little as the lasers warm up.
  - The simulation shows that losing half the light still works fine (0.13 % vs 0.11 % depth error).
  - If lines look weak in `ohs preview`, raise exposure or gain. Other fixes: use 635–638 nm lasers (fewer US sellers), or remove the IR-cut glass from the lens holders.
  - Option B's 625 nm LED is unaffected.
- **Picking laser modules on Amazon.** The listing should show all of these:
  - **"Line"** (or "dot" for option A), not "cross"
  - **650 nm**
  - **5 mW**, not 50 or 58 mW
  - **Ø12 mm** body
  - **3–5 V** supply
  - **adjustable focus**
  
  Packs of 5–10 are cheapest and give you spares. A glass lens is nicer than plastic but not required. Line fan angles of 60–90° are best; 110–120° lines are dimmer.
- **Lasers:**
  - Lengths vary by seller (12×30 to 12×45 mm). Any length works: the bore is open at the back.
  - Make sure the listing says **line** for #2 and **dot** for #3, and **5 mW** (some look-alikes are 58 mW).
  - Ideally choose a 60–90° fan angle; 120° lines are dimmer.
- **DOE (option A):**
  - Lasermate sells by quote: sales@lasermate.com, (909) 718-0999.
  - Ask for a 5 mm PET disc of DOE-RD10K650. The page lists a 6×6 mm active area and ≥2 mm beam, so confirm the disc size.
  - The 30k-dot version (DOE-RD30K650) also works.
- **Trigger button:** the grip now takes a **16 mm** button (Adafruit's), not 12 mm. The STLs are updated.
- **MTS-102:** comes with M6 or 1/4-40 threads; the back-cover hole fits either.
- **Transistors:** Adafruit lists the part as PN2222, without the "A". The pinout is the same E-B-C as the PN2222A, so it works.
