jessiepullaro414/Scan/stl/faceplate.stl

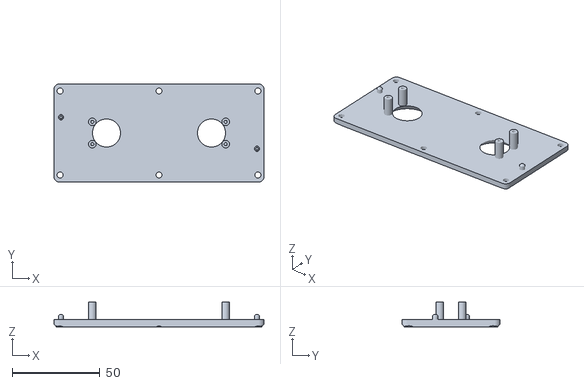
[picture p7: CAD file, 2026-11-12]
stl/faceplate.stl
120.0 x 56.0 x 14.0
