jessiepullaro414/Scan/stl/back_cover.stl

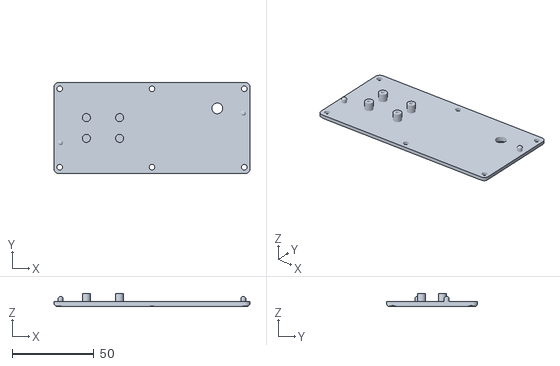
[picture p8: CAD file, 2026-11-12]
stl/back_cover.stl
120.0 x 56.0 x 8.00
