jessiepullaro414/Scan/stl/grip_left.stl

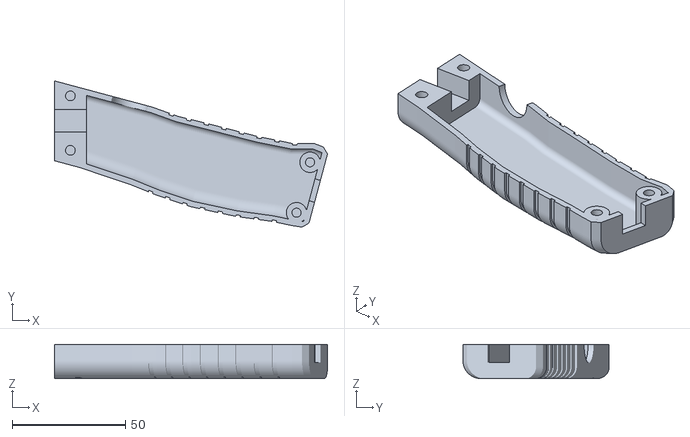
[picture p9: CAD file, 2026-11-12]
stl/grip_left.stl
120.3 x 64.4 x 15.0
