jessiepullaro414/Scan/stl/grip_right.stl

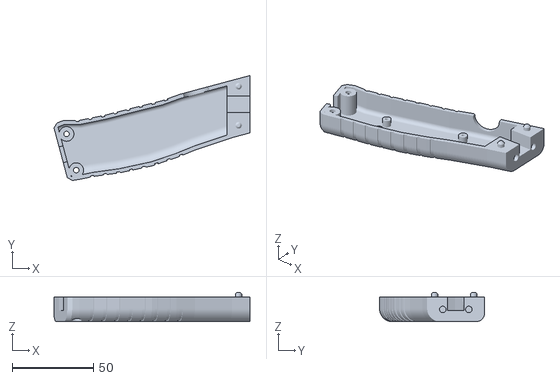
[picture p10: CAD file, 2026-11-12]
stl/grip_right.stl
120.3 x 64.4 x 18.0
