jessiepullaro414/Scan/stl/head.stl

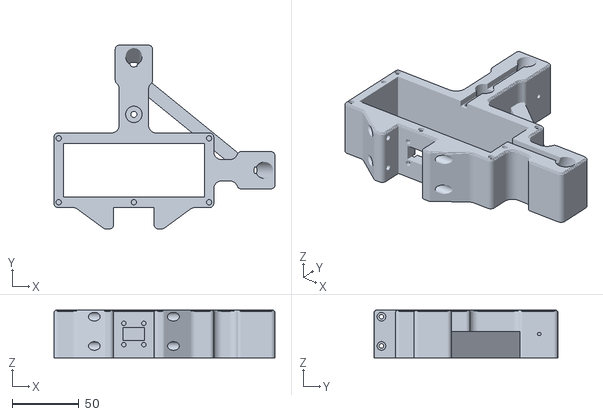
[picture p11: CAD file, 2026-11-12]
stl/head.stl
166.0 x 138.0 x 36.0
