jessiepullaro414/Scan/stl/head_led.stl

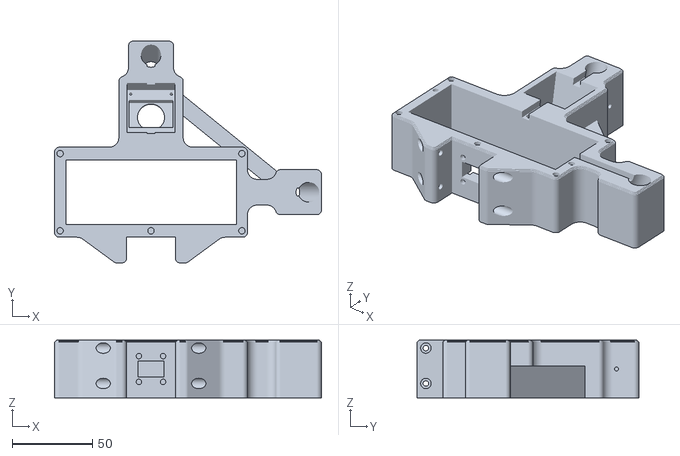
[picture p12: CAD file, 2026-11-12]
stl/head_led.stl
166.0 x 138.0 x 36.0
