jessiepullaro414/Scan/stl/led_cartridge.stl

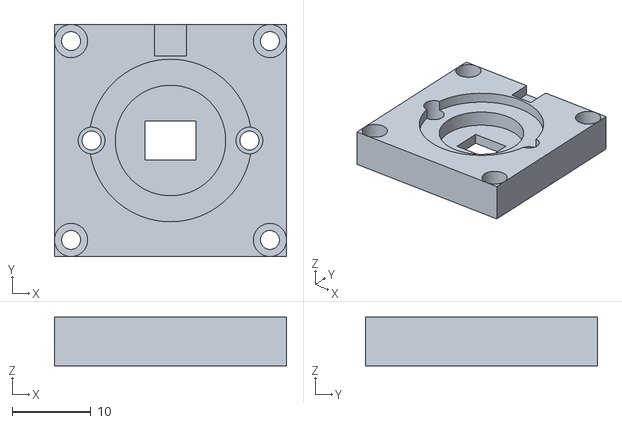
[picture p13: CAD file, 2026-11-09]
stl/led_cartridge.stl
29.4 x 29.4 x 6.20
