jessiepullaro414/Scan/(list of files, cad)

Other CAD files:
stl/head_led_cla020.stl
stl/led_cartridge_cla020.stl
