jessiepullaro414/Scan/renders/assembly.png

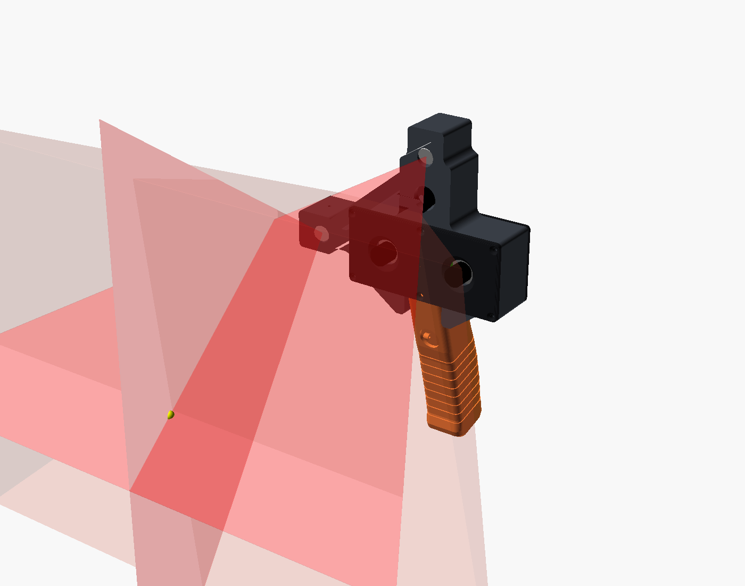
renders/assembly.png
