jessiepullaro414/Scan/renders/grip_print.png

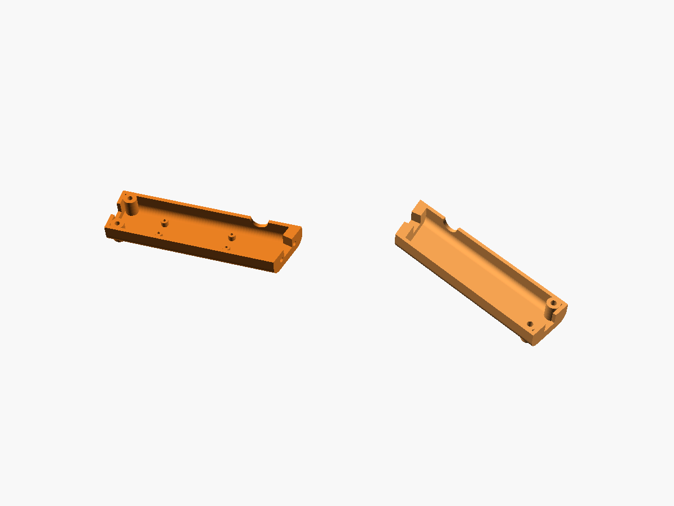
renders/grip_print.png
