jessiepullaro414/Scan/docs/screenshots/02-viewer-measure.png

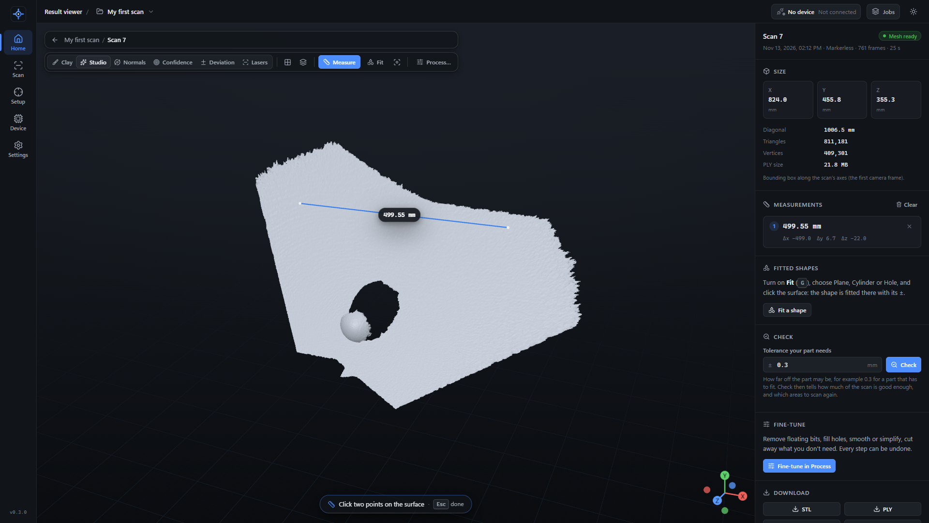
docs/screenshots/02-viewer-measure.png
