jessiepullaro414/Scan/docs/screenshots/03-stereo-calibration.png

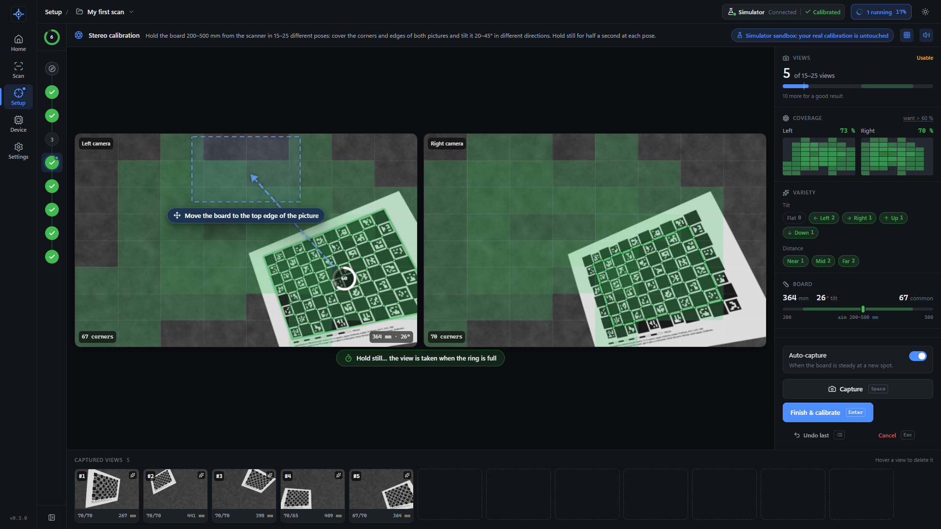
docs/screenshots/03-stereo-calibration.png
