jessiepullaro414/Scan/software/tests/test_server_process_studio.py

"""The processing studio (APP_API.md, M3 phase 2) through the real server.

Small simulated recordings are copied into scans (no live scan needed):

* a 10-frame sphere scan (640x400): track -> edits -> undo / redo -> selections -> overlays ->
  recipes (edits and all) -> fuse -> straighten (no loops: skipped); the WebSocket ``process``
  messages; the 409 rules (recording, busy, no track, no mesh); a cancelled track; recipes CRUD;
  "Make mesh" running the Default recipe; a scan processed before M3 being taken over;
* ``process_recording(poses=...)``: fusing at the tracked poses gives the tracked mesh again, at
  the true poses the trajectory error is zero;
* a 400 deg orbit around the bracket (as in ``test_track_posegraph.py``) whose trajectory is the
  truth plus synthetic drift: the real ``straighten_trajectory`` closes loops, the scan is fused
  again at the corrected poses, and the trajectory overlay shows both with the loop links.
"""
from __future__ import annotations

import base64
import csv
import dataclasses
import json
import shutil
import time
from pathlib import Path

import numpy as np
import pytest

pytest.importorskip("fastapi")
pytest.importorskip("open3d")
requests = pytest.importorskip("requests")

from websockets.sync.client import connect as ws_connect  # noqa: E402

from ohs.app.config import Config  # noqa: E402
from ohs.app.pipeline import PipelineParams  # noqa: E402
from ohs.app.process import ProcessParams, process_recording  # noqa: E402
from ohs.io.recording import RecordingReader  # noqa: E402
from ohs.server.app import create_app  # noqa: E402
from ohs.server.processing import read_trajectory  # noqa: E402
from ohs.server.testing import ServerThread, recv_until  # noqa: E402
from recordings import scan_recording  # noqa: E402
from ohs.track.export import load_ply  # noqa: E402

T = 30  # HTTP timeout


@pytest.fixture(scope="module")
def env(tmp_path_factory):
    root = tmp_path_factory.mktemp("studio")
    rec = scan_recording(root / "rec", n_frames=10, image_size=(640, 400), seed=3, depth_every=0)
    cfg = Config()
    cfg.paths.calibration = str(root / "no-calibration.json")
    app = create_app(cfg, projects_dir=root / "projects", demo_dir=root / "demo", static_dir=root / "static",
                     data_dir=root / "data", config_path=root / "config.toml")
    with ServerThread(app) as srv:
        e = {"srv": srv, "url": srv.url, "root": root, "studio": app.state.studio, "rec": rec}
        e["pid"], e["sid"] = add_scan(e, "Sphere", rec)
        yield e


def add_scan(env: dict, name: str, rec: Path, project: str | None = None) -> tuple[str, str]:
    """A project with one recorded scan whose recording is a copy of ``rec``."""
    st = env["studio"]
    pid = project or requests.post(env["url"] + "/api/projects", json={"name": name}, timeout=T).json()["id"]
    scan, rec_dir = st.projects.add_scan(pid, name, "markerless")
    shutil.copytree(rec, rec_dir)
    n = len(RecordingReader(rec_dir))
    st.projects.update_scan(pid, scan["id"], status="recorded", n_frames=n, duration_s=n / 30.0)
    return pid, scan["id"]


def base_url(env: dict, pid: str | None = None, sid: str | None = None) -> str:
    return f"{env['url']}/api/projects/{pid or env['pid']}/scans/{sid or env['sid']}"


def post(url: str, body: dict | None = None):
    return requests.post(url, json=body, timeout=T)


def get(url: str):
    return requests.get(url, timeout=T)


def err(r, status: int, needle: str = "") -> dict:
    assert r.status_code == status, r.text
    body = r.json()
    assert body["detail"] and body.get("hint"), body  # every error says what to do
    assert needle.lower() in body["detail"].lower(), body
    return body


def wait_job(env: dict, jid: str, timeout: float = 180.0) -> dict:
    deadline = time.monotonic() + timeout
    while time.monotonic() < deadline:
        j = get(f"{env['url']}/api/jobs/{jid}").json()
        if j["state"] not in ("queued", "running"):
            return j
        time.sleep(0.1)
    raise AssertionError(f"job {jid} did not finish within {timeout:.0f} s")


def run_job(env: dict, r, kind: str) -> dict:
    assert r.status_code == 200, r.text
    job = r.json()
    assert job["kind"] == kind and job["state"] in ("queued", "running")
    done = wait_job(env, job["id"])
    assert done["state"] == "done", done
    return done


def mesh_faces(env: dict, url: str) -> int:
    r = get(env["url"] + url)
    assert r.status_code == 200 and r.content.startswith(b"ply")
    p = env["root"] / f"dl-{time.monotonic_ns()}.ply"
    p.write_bytes(r.content)
    return len(load_ply(p)["faces"])


def mesh_quality(env: dict, url: str) -> np.ndarray | None:
    """Each vertex's sigma in the served PLY (``quality``), None when it has none."""
    r = get(env["url"] + url)
    p = env["root"] / f"dl-{time.monotonic_ns()}.ply"
    p.write_bytes(r.content)
    return load_ply(p)["quality"]


def faces_b64(idx) -> str:
    return base64.b64encode(np.asarray(idx, dtype="<u4").tobytes()).decode("ascii")


# --------------------------------------------------------------------------- engine
def test_process_recording_fuses_at_given_poses(env, tmp_path):
    params = ProcessParams(pipeline=PipelineParams(scale=0.5), export=("ply",))
    tracked = process_recording(env["rec"], tmp_path / "tracked", params=params)
    rows = read_trajectory(tmp_path / "tracked" / "trajectory.csv")
    poses = {i: T for i, _, ok, T in rows if ok}
    fused = process_recording(env["rec"], tmp_path / "fused", params=params, poses=poses)
    assert fused["poses"] == "given" and fused["frames"]["processed"] == len(poses) == fused["frames"]["tracked"]
    assert fused["params"]["tracking"]["model"].startswith("none")
    assert len(load_ply(tmp_path / "fused" / "mesh.ply")["faces"]) == tracked["mesh"]["n_faces"]
    assert [r[0] for r in read_trajectory(tmp_path / "fused" / "trajectory.csv")] == sorted(poses)
    # at the true poses (in the tracked world frame), half of the frames: no trajectory error
    gt = RecordingReader(env["rec"]).ground_truth_poses()
    i0 = min(poses)
    A = poses[i0] @ np.linalg.inv(gt[i0])
    half = {i: A @ gt[i] for i in sorted(poses)[::2]}
    at_truth = process_recording(env["rec"], tmp_path / "truth", params=params, poses=half)
    n_rec = len(RecordingReader(env["rec"]))  # a frame the tracker lost (it can, on a busy CPU) has no pose either
    assert at_truth["frames"]["processed"] == len(half) and at_truth["frames"]["without_pose"] == n_rec - len(half)
    assert at_truth["ground_truth"]["rms_trans_mm"] < 1e-3
    with pytest.raises(ValueError, match="none of the given poses"):
        process_recording(env["rec"], tmp_path / "none", params=params, poses={999: np.eye(4)})


# --------------------------------------------------------------------------- REST
def test_a_fresh_scan_and_the_409_rules(env):
    b = base_url(env)
    s = get(b + "/process").json()
    assert s["project_id"] == env["pid"] and s["scan_id"] == env["sid"]
    assert {k: v["state"] for k, v in s["stages"].items()} == {"track": "none", "straighten": "none", "fuse": "none",
                                                               "spacetime": "none", "refine": "none"}
    assert s["base"] is None and s["current"] is None and s["edits"] == [] and s["cursor"] == 0
    assert s["can_undo"] is False and s["can_redo"] is False and s["busy"] is None and s["job"] is None
    assert {"quality", "tracked_pct"} <= set(s["stages"]["track"]) and {"loops", "correction_mm", "correction_deg"} <= \
        set(s["stages"]["straighten"]) and "voxel_mm" in s["stages"]["fuse"]
    assert {"source", "points", "outliers", "moved_pct", "moved_mm", "residual_before_mm", "residual_after_mm"} <= \
        set(s["stages"]["refine"])
    err(post(b + "/process/straighten", {}), 409, "track")
    err(post(b + "/process/refine", {}), 409, "track")
    err(post(b + "/process/fuse", {"voxel_mm": 2.0}), 409, "track")
    err(post(b + "/process/edits", {"op": "fill_holes", "params": {"max_hole_mm": 5}}), 409, "no mesh")
    err(post(b + "/process/undo"), 409, "no mesh")
    err(post(b + "/process/redo"), 409, "no mesh")
    err(post(b + "/process/recipe", {"recipe_id": "default", "scope": "edits"}), 409, "no mesh")
    err(get(b + "/process/holes.json"), 409, "no mesh")
    err(post(b + "/fit", {"kind": "plane", "face": 0, "point": [0, 0, 250]}), 409, "no mesh")
    err(post(b + "/check", {"tolerance_mm": 0.1}), 409, "no mesh")
    err(get(b + "/process/deviation.json"), 409, "no mesh")
    err(get(b + "/process/deviation.bin"), 409, "no mesh")
    err(get(b + "/process/trajectory.json"), 404, "trajectory")
    err(post(b + "/process/track", {"quality": "draft"}), 422)
    err(post(b + "/process/fuse", {"voxel_mm": 0.01}), 422)
    err(post(b + "/process/edits", {"op": "explode"}), 422)
    err(post(b + "/process/recipe", {"recipe_id": "nope", "scope": "edits"}), 404, "recipe")
    err(get(base_url(env, sid="scan-missing") + "/process"), 404, "no scan")


def test_track_edits_undo_redo_and_the_process_messages(env):
    b = base_url(env)
    with ws_connect(env["srv"].ws_url, max_size=None, open_timeout=5) as ws:
        ws.send(json.dumps({"type": "subscribe", "preview": False, "mesh": False}))
        r = post(b + "/process/track", {"quality": "preview"})
        assert r.status_code == 200, r.text
        job = r.json()
        assert job["kind"] == "process_track" and job["project_id"] == env["pid"] and job["scan_id"] == env["sid"]
        err(post(b + "/process/track", {"quality": "preview"}), 409, "busy")  # one job per scan
        err(post(b + "/process", {"quality": "preview"}), 409, "busy")
        seen: list[dict] = []

        def done(m, p, raw):
            if m.get("type") == "process" and m.get("scan_id") == env["sid"]:
                seen.append(m)
                return m["stages"]["track"]["state"] == "done" and m["job"] is None
            return False

        recv_until(ws, done, timeout=180)
        running = [m for m in seen if m["stages"]["track"]["state"] == "running"]
        assert running and running[0]["busy"] == "Tracking the scan…" and running[0]["job"]["id"] == job["id"]
        assert running[0]["stages"]["track"]["job_id"] == job["id"]
    assert wait_job(env, job["id"])["state"] == "done"
    s = get(b + "/process").json()
    tr = s["stages"]["track"]
    assert tr["quality"] == "preview" and tr["tracked_pct"] >= 80 and tr["summary"].startswith("Tracked") and tr["when"]
    assert s["base"]["stage"] == "track" and s["base"]["triangles"] > 1000 and s["edits"] == [] and s["cursor"] == 0
    cur = s["current"]
    assert cur["version"] >= 1 and cur["mesh_url"] == f"/api/projects/{env['pid']}/scans/{env['sid']}/files/mesh.ply"
    r = get(env["url"] + cur["mesh_url"] + f"?v={cur['version']}")  # the UI adds the version to the URL
    assert r.status_code == 200 and r.headers["cache-control"] == "no-cache"
    st0 = cur["stats"]
    assert st0["triangles"] == s["base"]["triangles"] and st0["vertices"] == s["base"]["vertices"]
    assert {"components", "holes", "largest_hole_mm", "border_mm", "boundary_edges", "non_manifold_edges",
            "watertight", "bbox_mm", "area_cm2", "volume_cm3"} <= set(st0)
    assert st0["border_mm"] is not None  # an open scan has an outer border
    assert mesh_faces(env, cur["mesh_url"]) == s["base"]["triangles"]
    # each vertex's sigma: with the confidence reconstruction (a GPU), not with Open3D's
    qs = [mesh_quality(env, cur["mesh_url"])]
    confident = qs[0] is not None
    assert (st0["sigma_mm"] is not None) == confident
    if confident:
        assert len(qs[0]) == st0["vertices"] and np.all(qs[0] > 0) and 0 < st0["sigma_mm"]["median"] < 50.0
    scan = get(f"{env['url']}/api/projects/{env['pid']}").json()["scans"][0]
    assert scan["status"] == "processed" and scan["result"]["report"]["quality"] == "preview"
    res = env["root"] / "projects" / env["pid"] / "scans" / env["sid"] / "result"
    assert {"mesh.ply", "mesh.stl", "report.json", "trajectory.csv", "laser_points.ply"} <= {p.name for p in res.iterdir()}
    # edits
    v0 = cur["version"]
    plan = [("remove_floaters", {"min_size_mm": 5}, "Remove loose pieces smaller than 5 mm"),
            ("fill_holes", {"max_hole_mm": 30}, "Fill holes up to 30 mm"),
            ("smooth", {"method": "bilateral", "strength": 0.3}, "Smooth (bilateral, 30 %, edges kept)"),
            ("decimate", {"ratio": 0.5}, "Simplify to 50 % of the triangles")]
    tris = [s["base"]["triangles"]]
    for k, (op, params, label) in enumerate(plan):
        j = run_job(env, post(b + "/process/edits", {"op": op, "params": params}), "mesh_edit")
        e = j["result"]["edit"]
        assert e["op"] == op and e["label"] == label and e["ms"] >= 0 and e["summary"] == j["result"]["message"]
        s = get(b + "/process").json()
        assert len(s["edits"]) == k + 1 and s["cursor"] == k + 1 and s["current"]["version"] == v0 + k + 1
        assert s["edits"][-1]["triangles_after"] == s["current"]["stats"]["triangles"]
        tris.append(s["edits"][-1]["triangles_after"])
        qs.append(mesh_quality(env, s["current"]["mesh_url"]))
        if confident:  # the sigmas follow every edit; filled holes are "not measured"
            sm = s["current"]["stats"]["sigma_mm"]
            assert len(qs[-1]) == s["current"]["stats"]["vertices"] and sm is not None
            if op == "fill_holes":
                assert (sm["not_measured"] > 0) == (tris[-1] > tris[-2]) and np.any(qs[-1] == 50.0) == (tris[-1] > tris[-2])
        else:
            assert qs[-1] is None
    assert s["edits"][0]["params"] == {"min_size_mm": 5.0}
    assert s["edits"][2]["params"] == {"method": "bilateral", "strength": 0.3, "keep_edges": True}
    assert tris[2] >= tris[1] and abs(tris[4] - tris[3] / 2) <= max(10, 0.01 * tris[3])
    assert s["can_undo"] and not s["can_redo"]
    assert mesh_faces(env, s["current"]["mesh_url"]) == tris[4]
    # undo / redo: instant, and the result files follow; a step missing from the cache is rebuilt
    # by replaying its edit (sigmas too)
    cache = env["root"] / "projects" / env["pid"] / "scans" / env["sid"] / "process" / "cache"
    (cache / f"{s['edits'][2]['id']}.npz").unlink()
    ver = s["current"]["version"]
    t0 = time.perf_counter()
    u = post(b + "/process/undo").json()
    assert time.perf_counter() - t0 < 5.0
    assert u["cursor"] == 3 and u["can_redo"] and u["current"]["version"] == ver + 1
    assert u["current"]["stats"]["triangles"] == tris[3] and mesh_faces(env, u["current"]["mesh_url"]) == tris[3]
    if confident:  # the step's own sigmas come back
        assert np.array_equal(mesh_quality(env, u["current"]["mesh_url"]), qs[3])
    u = post(b + "/process/undo").json()
    assert u["cursor"] == 2 and mesh_faces(env, u["current"]["mesh_url"]) == tris[2]
    r = post(b + "/process/redo").json()
    assert r["cursor"] == 3 and r["current"]["version"] == ver + 3 and mesh_faces(env, r["current"]["mesh_url"]) == tris[3]
    for _ in range(3):
        u = post(b + "/process/undo").json()
    assert u["cursor"] == 0 and not u["can_undo"] and u["current"]["stats"]["triangles"] == tris[0]
    err(post(b + "/process/undo"), 409, "nothing to undo")
    for _ in range(4):
        r = post(b + "/process/redo").json()
    assert r["cursor"] == 4 and not r["can_redo"] and mesh_faces(env, r["current"]["mesh_url"]) == tris[4]
    err(post(b + "/process/redo"), 409, "nothing to redo")
    # a new edit after an undo drops the redo steps
    post(b + "/process/undo")
    run_job(env, post(b + "/process/edits", {"op": "decimate", "params": {"target_triangles": tris[3] // 3}}),
            "mesh_edit")
    s = get(b + "/process").json()
    assert len(s["edits"]) == 4 and s["cursor"] == 4 and not s["can_redo"]
    assert s["edits"][3]["params"] == {"target_triangles": tris[3] // 3}
    assert {p.stem for p in cache.glob("*.npz")} == {"base"} | {e["id"] for e in s["edits"]}


@pytest.mark.slow
def test_undo_writes_the_files_without_the_main_lock(env, monkeypatch):
    """Undo / redo hold ``Studio._lock`` only for the 409 rules and write the result files under the
    scan's own lock: starting or stopping a scan, the trigger and connect never wait for them. What
    comes meanwhile still sees the undo whole: a second undo, an edit, a project delete."""
    import threading

    from ohs.server.processing import ProcessManager

    pid, sid = add_scan(env, "Undo lock", env["rec"])
    b = base_url(env, pid, sid)
    run_job(env, post(b + "/process/track", {"quality": "preview"}), "process_track")
    n0 = get(b + "/process").json()["current"]["stats"]["triangles"]
    run_job(env, post(b + "/process/edits", {"op": "delete_faces", "params": {"faces": faces_b64(range(10))}}),
            "mesh_edit")
    run_job(env, post(b + "/process/edits", {"op": "keep_faces", "params": {"faces": faces_b64(range(100))}}),
            "mesh_edit")
    v = get(b + "/process").json()["current"]["version"]
    real = ProcessManager._write_result
    gate = {"held": threading.Event(), "go": threading.Event()}
    gate["go"].set()

    def slow(self, *a, **kw):  # the result files of a large mesh: written when the test lets go
        g = gate.copy()
        if not g["go"].is_set():
            g["held"].set()
            g["go"].wait(30)
        return real(self, *a, **kw)

    def in_thread(fn):
        out: dict = {}
        t = threading.Thread(target=lambda: out.update(r=fn()), daemon=True)
        t.start()
        return t, out

    def undo_held(then):
        """An undo that is writing its files when ``then()`` sends another request (in a thread);
        returns both answers."""
        gate.update(held=threading.Event(), go=threading.Event())
        t1, u = in_thread(lambda: post(b + "/process/undo"))
        try:
            assert gate["held"].wait(30)
            t2, o = then()
            time.sleep(0.3)  # the other request arrives while the undo writes
        finally:
            gate["go"].set()
            t1.join(30)
        t2.join(30)
        return u["r"], o["r"]

    monkeypatch.setattr(ProcessManager, "_write_result", slow)
    lock = env["studio"]._lock

    def lock_free_then_undo():
        free = lock.acquire(timeout=2.0)
        if free:
            lock.release()
        assert free, "the undo holds Studio._lock while it writes the result files"
        return in_thread(lambda: post(b + "/process/undo"))

    # 1. the main lock is free while an undo writes; a second undo at once waits for the first
    u1, u2 = undo_held(lock_free_then_undo)
    assert u1.status_code == 200 and u2.status_code == 200, (u1.text, u2.text)
    s = get(b + "/process").json()
    assert s["cursor"] == 0 and s["current"]["version"] == v + 2 and s["current"]["stats"]["triangles"] == n0
    assert mesh_faces(env, s["current"]["mesh_url"]) == n0
    # 2. an edit sent while an undo writes is made from the undone step (n0 - 10 triangles, not 100)
    for _ in range(2):
        assert post(b + "/process/redo").status_code == 200
    u, e = undo_held(lambda: in_thread(lambda: post(b + "/process/edits", {"op": "decimate", "params": {"ratio": 0.5}})))
    assert u.status_code == 200, u.text
    run_job(env, e, "mesh_edit")
    s = get(b + "/process").json()
    assert [x["op"] for x in s["edits"]] == ["delete_faces", "decimate"] and s["cursor"] == 2
    assert abs(s["edits"][1]["triangles_after"] - (n0 - 10) / 2) <= max(10, 0.01 * n0)
    # 3. a project deleted while an undo writes moves to the trash after it (no folder written again)
    u, d = undo_held(lambda: in_thread(lambda: requests.delete(f"{env['url']}/api/projects/{pid}", timeout=T)))
    assert u.status_code == 200 and d.status_code == 204, (u.text, d.text)
    assert not (env["root"] / "projects" / pid).exists()


def test_selections_and_their_checks(env):
    b = base_url(env)
    s = get(b + "/process").json()
    n = s["current"]["stats"]["triangles"]
    ver = s["current"]["version"]
    sel = list(range(0, n, 3))
    j = run_job(env, post(b + "/process/edits", {"op": "delete_faces", "params": {"faces": faces_b64(sel)}, "version": ver}),
                "mesh_edit")
    e = j["result"]["edit"]
    assert e["label"] == f"Delete {len(sel):,} triangles" and e["params"] == {"count": len(sel)}
    assert e["triangles_after"] == n - len(sel)
    s = get(b + "/process").json()
    m = s["current"]["stats"]["triangles"]
    j = run_job(env, post(b + "/process/edits", {"op": "keep_faces", "params": {"faces": faces_b64([5, 1, 1, 7])}}),
                "mesh_edit")
    assert j["result"]["edit"]["triangles_after"] == 3 and j["result"]["edit"]["label"] == "Keep 3 triangles"
    post(b + "/process/undo")
    sel_dir = env["root"] / "projects" / env["pid"] / "scans" / env["sid"] / "process" / "selections"
    assert len(list(sel_dir.glob("*.npy"))) == 2  # kept for replays until the edit is dropped
    err(post(b + "/process/edits", {"op": "delete_faces", "params": {"faces": faces_b64([m])}}), 422, "has triangle")
    err(post(b + "/process/edits", {"op": "delete_faces", "params": {"faces": "not base64!"}}), 422, "base64")
    err(post(b + "/process/edits", {"op": "delete_faces", "params": {"faces": base64.b64encode(b"abc").decode()}}),
        422, "bytes")
    err(post(b + "/process/edits", {"op": "keep_faces", "params": {}}), 422, "missing")
    err(post(b + "/process/edits", {"op": "delete_faces", "params": {"faces": faces_b64([0])}, "version": 1}),
        409, "changed")
    err(post(b + "/process/edits", {"op": "fill_holes", "params": {}}), 422, "max_hole_mm")
    err(post(b + "/process/edits", {"op": "smooth", "params": {"method": "gauss", "strength": 0.5}}), 422, "method")
    err(post(b + "/process/edits", {"op": "decimate", "params": {"ratio": 0.5, "target_triangles": 100}}), 422)
    err(post(b + "/process/edits", {"op": "remove_floaters", "params": {"size": 5}}), 422, "unknown parameter")
    # deleting everything is refused and leaves the mesh as it was
    r = post(b + "/process/edits", {"op": "delete_faces", "params": {"faces": faces_b64(range(m))}})
    failed = wait_job(env, r.json()["id"])
    assert failed["state"] == "failed" and "whole mesh" in failed["error"]
    after = get(b + "/process").json()
    assert after["current"]["version"] == s["current"]["version"] + 2 and after["cursor"] == s["cursor"]


def test_overlays(env):
    b = base_url(env)
    while get(b + "/process").json()["cursor"] > 0:
        post(b + "/process/undo")
    holes = get(b + "/process/holes.json").json()
    assert isinstance(holes, list)
    for h in holes:
        assert h["perimeter_mm"] > 0 and len(h["points"]) == 3 * (h["n_edges"] + 1)
    assert [h["perimeter_mm"] for h in holes] == sorted((h["perimeter_mm"] for h in holes), reverse=True)
    st = get(b + "/process").json()["current"]["stats"]
    assert len(holes) == st["holes"]
    tj = get(b + "/process/trajectory.json").json()
    tracked = get(b + "/process").json()["stages"]["track"]["tracked_pct"]
    assert len(tj["raw"]) == round(10 * tracked / 100) and all(len(p) == 3 for p in tj["raw"])
    assert tj["straightened"] is None and tj["loops"] == []


def test_fit_a_plane_on_the_table(env, tmp_path):
    b = base_url(env)
    cur = get(b + "/process").json()["current"]
    ply = tmp_path / "mesh.ply"
    ply.write_bytes(get(env["url"] + cur["mesh_url"]).content)
    m = load_ply(ply)
    V, F = m["vertices"], m["faces"]
    C = V[F].mean(axis=1)
    far = np.flatnonzero(C[:, 2] >= np.percentile(C[:, 2], 90))  # the table, behind the sphere
    face = int(far[np.argmin(np.linalg.norm(C[far] - C[far].mean(axis=0), axis=1))])
    click = {"face": face, "point": [float(x) for x in C[face]], "version": cur["version"]}
    r = post(b + "/fit", {"kind": "plane", **click})
    assert r.status_code == 200, r.text
    fit = r.json()
    shape = fit["shape"]
    assert fit["kind"] == "plane" and shape["kind"] == "plane" and fit["version"] == cur["version"]
    faces = np.frombuffer(base64.b64decode(fit["faces"]), dtype="<u4")
    assert len(faces) == fit["n_faces"] > 100 and face in faces and np.all(np.diff(faces.astype(np.int64)) > 0)
    # this short, coarse scan is noisy (face normals about 10° off the table, 0.4 mm scatter): the
    # check is that the fit agrees with its own region, not precision (that is step 5's)
    Nf = np.cross(V[F[faces, 1]] - V[F[faces, 0]], V[F[faces, 2]] - V[F[faces, 0]])
    mean_n = Nf.sum(axis=0) / np.linalg.norm(Nf.sum(axis=0))
    assert abs(float(np.dot(mean_n, shape["normal"]))) > np.cos(np.radians(10))
    assert shape["rms_mm"] < 1.0 and shape["flatness_mm"] >= shape["rms_mm"] and shape["normal_sigma_deg"] > 0
    # the tolerance follows the scatter (its sigma, when there is one, claims ~3 mm)
    assert 0 < fit["tolerance_mm"] < 3.0 and isinstance(fit["warnings"], list)
    assert fit["mean_sigma_mm"] is None or fit["mean_sigma_mm"] > 0
    # clear answers for what does not fit
    err(post(b + "/fit", {"kind": "cone", **click}), 422, "unknown kind")
    err(post(b + "/fit", {**click, "kind": "plane", "face": len(F) + 5}), 422, "not on the mesh")
    err(post(b + "/fit", {**click, "kind": "plane", "version": cur["version"] - 1}), 409, "changed")
    # shapes the scene does not have: a cylinder or a hole in a table with a sphere on it. (On this
    # short, noisy scan the cylinder was at times accepted, with a radius of metres: MAINTENANCE_PLAN.md, F1.)
    err(post(b + "/fit", {"kind": "cylinder", **click}), 422)
    err(post(b + "/fit", {"kind": "hole", **click}), 422)
    assert post(b + "/fit", {"kind": "plane", **{**click, "point": [0, 0]}}).status_code == 422


def test_the_laser_agreement_map(env):
    """``lasers.json`` / ``lasers.bin``: one value per vertex of the current mesh where a laser point
    came near, NaN elsewhere, with the numbers the legend shows."""
    b = base_url(env)
    s = get(b + "/process").json()
    info = get(b + "/process/lasers.json").json()
    r = get(b + "/process/lasers.bin")
    assert r.status_code == 200 and r.headers["x-ohs-mesh-version"] == str(info["version"]) == str(s["current"]["version"])
    val = np.frombuffer(r.content, dtype="<f4")
    assert len(val) == info["vertices"] == s["current"]["stats"]["vertices"]
    pts, st = info["points"], info["stats"]
    assert info["available"] is True and info["gate_mm"] == 3.0
    assert pts["total"] >= pts["on_surface"] >= pts["used"] > 100 and pts["stray"] == pts["on_surface"] - pts["used"]
    has = np.isfinite(val)
    assert st["n"] == int(has.sum()) > 100 and 0.0 < st["covered"] < 1.0
    assert np.abs(val[has]).max() <= 3.0 + 1e-6 and st["max_mm"] == pytest.approx(float(np.abs(val[has]).max()), abs=1e-3)
    assert 0.0 <= st["within_0_1"] <= st["within_0_3"] <= 1.0 and st["p50_mm"] <= st["p95_mm"] <= st["max_mm"]
    assert get(b + "/process/lasers.json").json() == info  # kept per mesh version


def test_the_deviation_map_follows_the_edits(env, tmp_path):
    b = base_url(env)
    s = get(b + "/process").json()
    assert s["cursor"] == 0 and s["can_redo"]  # as test_overlays left it

    def both():
        info = get(b + "/process/deviation.json").json()
        r = get(b + "/process/deviation.bin")
        assert r.status_code == 200 and r.headers["x-ohs-mesh-version"] == str(info["version"])
        return info, np.frombuffer(r.content, dtype="<f4")

    info, off = both()  # no edits: the mesh is its own reference
    assert info["edits"] == 0 and info["version"] == s["current"]["version"] and info["reference"]["stage"] == "track"
    assert len(off) == info["vertices"] == s["current"]["stats"]["vertices"] and not off.any()
    assert info["stats"]["max_mm"] == 0.0 and info["stats"]["new"] == 0 and info["stats"]["moved"] == 0.0
    for _ in range(3):  # remove floaters, fill holes, smooth
        s = post(b + "/process/redo").json()
    info, off = both()
    assert info["edits"] == 3 and info["version"] == s["current"]["version"]
    assert info["reference"]["triangles"] == s["base"]["triangles"]
    ply = tmp_path / "mesh.ply"
    ply.write_bytes(get(env["url"] + s["current"]["mesh_url"]).content)
    m = load_ply(ply)
    assert len(off) == len(m["vertices"]) == info["vertices"]  # one value per vertex of mesh.ply
    st = info["stats"]
    assert st["new"] == int(np.isnan(off).sum()) and st["n"] == len(off) - st["new"]
    filled = m.get("filled")
    if filled is not None and np.any(filled):  # the new vertices are those no measured face uses
        measured = np.zeros(len(off), dtype=bool)
        measured[m["faces"][~filled.astype(bool)]] = True
        assert np.array_equal(np.isnan(off), ~measured)
    # smoothing moved the surface a little, both ways, and nowhere far
    assert 0 < st["p50_mm"] <= st["p95_mm"] <= st["max_mm"] < 10.0 and st["moved"] > 0.1
    assert np.nanmin(off) < 0 < np.nanmax(off) and st["max_mm"] == pytest.approx(float(np.nanmax(np.abs(off))), abs=1e-3)
    assert get(b + "/process/deviation.json").json() == info  # kept for this version
    for _ in range(3):
        s = post(b + "/process/undo").json()
    assert s["cursor"] == 0 and not both()[1].any()


def test_check_lists_the_areas_that_miss_a_tolerance(env):
    b = base_url(env)
    s = get(b + "/process").json()
    n_faces = s["current"]["stats"]["triangles"]
    loose, tight = (post(b + "/check", {"tolerance_mm": t}) for t in (20.0, 0.05))
    assert loose.status_code == 200 and tight.status_code == 200, loose.text + tight.text
    loose, tight = loose.json(), tight.json()
    for r, tol in ((loose, 20.0), (tight, 0.05)):
        assert r["version"] == s["current"]["version"] and r["tolerance_mm"] == tol and r["k"] == 2.0
        assert r["area_mm2"] > 0 and r["min_area_mm2"] >= 4.0 and r["n_areas"] >= len(r["areas"]) <= 50
        sizes = [a["area_mm2"] for a in r["areas"]]
        assert sizes == sorted(sizes, reverse=True)
        for a in r["areas"]:
            faces = np.frombuffer(base64.b64decode(a["faces"]), dtype="<u4")
            assert len(faces) == a["n_faces"] > 0 and int(faces.max()) < n_faces and np.all(np.diff(faces.astype(np.int64)) > 0)
            assert a["kind"] in ("uncertain", "not_measured") and len(a["center"]) == 3
            assert a["area_mm2"] >= r["min_area_mm2"] and a["radius_mm"] > 0 and 0 < a["share"] <= 1
    if tight["has_sigma"]:  # the confidence reconstruction (a GPU): a tighter tolerance passes less
        assert tight["share_ok"] < loose["share_ok"] and tight["areas"] and tight["areas"][0]["kind"] == "uncertain"
        for r in (loose, tight):
            assert r["share_ok"] + r["share_uncertain"] + r["share_not_measured"] == pytest.approx(1.0, abs=1e-6)
    else:  # Open3D's mesh has no sigma: nothing to check a tolerance against
        assert tight["share_ok"] is None and tight["share_uncertain"] is None and tight["areas"] == loose["areas"]
    err(post(b + "/check", {"tolerance_mm": 0}), 422)
    err(post(b + "/check", {}), 422)


def test_recipes_crud(env):
    url = env["url"] + "/api/recipes"
    rs = get(url).json()
    assert [r["id"] for r in rs[:4]] == ["default", "body-panel", "bracket", "quick-preview"]
    assert all(r["builtin"] and r["name"] and r["description"] for r in rs[:4])
    default = rs[0]
    assert default["settings"] == {"quality": "standard", "straighten": "auto", "refine": "auto", "voxel_mm": None}
    assert [o["op"] for o in default["ops"]] == ["remove_floaters", "fill_holes"]  # no smoothing, no simplification
    assert default["ops"][1]["params"]["max_hole_mm"] == 5.0
    assert rs[3]["settings"]["quality"] == "preview" and rs[3]["ops"][-1] == {"op": "decimate",
                                                                              "params": {"target_triangles": 200000}}
    body = {"name": "Coarse look", "description": "fast", "settings": {"quality": "preview", "straighten": "off"},
            "ops": [{"op": "remove_floaters", "params": {"keep_largest_only": True}},
                    {"op": "decimate", "params": {"ratio": 0.5}}]}
    r = post(url, body)
    assert r.status_code == 200, r.text
    rec = r.json()
    assert rec["id"].startswith("coarse-look-") and rec["builtin"] is False and rec["name"] == "Coarse look"
    assert rec["settings"] == {"quality": "preview", "straighten": "off", "refine": "auto", "voxel_mm": None}
    assert rec["ops"][0] == {"op": "remove_floaters", "params": {"keep_largest_only": True}}
    assert (env["root"] / "data" / "recipes" / f"{rec['id']}.json").is_file()
    assert [x["id"] for x in get(url).json()][4:] == [rec["id"]]
    # from a scan: its active edits, without the selections
    r2 = post(url, {"name": "From the sphere", "from_scan": {"project_id": env["pid"], "scan_id": env["sid"]}})
    assert r2.status_code == 200, r2.text
    fs = r2.json()
    assert fs["settings"]["quality"] == "preview" and fs["settings"]["straighten"] == "off"
    assert fs["ops"] == []  # the sphere's edits are all undone (cursor 0)
    err(post(url, {"name": "Bad", "settings": {}, "ops": [{"op": "delete_faces", "params": {}}]}), 422)
    err(post(url, {"name": "Bad", "settings": {}, "ops": [{"op": "fill_holes", "params": {}}]}), 422, "max_hole_mm")
    err(post(url, {"name": "Bad"}), 422, "from_scan")
    err(post(url, {"name": "   ", "settings": {}, "ops": []}), 400, "empty")
    err(requests.delete(f"{url}/default", timeout=T), 409, "built-in")
    assert requests.delete(f"{url}/{fs['id']}", timeout=T).status_code == 204
    err(requests.delete(f"{url}/{fs['id']}", timeout=T), 404, "no recipe")
    env["user_recipe"] = rec["id"]
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
