jessiepullaro414/Scan/(commit log)

2026-11-09 Initial import: OpenHandScan handheld 3D scanner
    Hardware: parametric OpenSCAD housing with two pattern-projector options
    (laser + DOE, or LED + printed mask), print-ready STLs, renders, and a
    parts list with links.
    Firmware: MicroPython for the Raspberry Pi Pico (emitters, trigger,
    IMU streaming, clock sync).
    Software: the ohs package (devices, calibration, stereo depth, laser
    lines, tracking and fusion, simulator, CLI and live app) with tests.
    The offline pipeline and end-to-end validation are still in progress.
    [back_cover.stl, faceplate.stl, grip_left.stl, grip_right.stl, head.stl, head_led.stl, head_led_cla020.stl, led_cartridge.stl]
2026-11-09 Use the repository's MIT license for the whole project
    The repository was created with an MIT LICENSE. Drop LICENSE.md, which
    proposed CERN-OHL-S / GPL / CC-BY-SA, and point the README, pyproject
    and CAD header at the MIT LICENSE instead.
    [scanner.scad]
2026-11-09 Finish the processing pipeline and end-to-end validation
    - Laser-plane calibration can use the printed white page margin
    (region="margin"), which avoids the ink-edge bias in the laser line
    centres: median laser-point error 0.011-0.028 mm vs 0.16-0.20 mm on
    the board itself. lasers_from_recording uses it by default.
    - Calibration flows run on recordings (stereo, lasers, IMU, check).
    - End-to-end tests on the simulator cover stereo, laser and IMU
    calibration, markerless and marker scans, the car panel, and the full
    chain with estimated calibration. software/VALIDATION.md has the
    numbers (e.g. markerless sphere: 36/36 frames tracked, max drift
    0.29 mm, mesh median error 0.20 mm).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
    [test_app_pipeline.py, test_e2e_calibration.py, test_e2e_scan.py]
2026-11-09 Plan the desktop app (OpenHandScan Studio)
    - software/docs/DESKTOP_APP_PLAN.md: competitor research (Revo Scan,
    Creality Scan, Shining 3D, Artec Studio, Creaform VXelements, Peel 3D,
    Scantech, reverse-engineering and open-source tools), what users love
    and hate, our differentiators for car work, UX flows, the tech stack
    (Python engine + FastAPI + React/three.js in a pywebview window),
    architecture, and milestones M1-M6.
    - software/docs/APP_API.md: the REST / WebSocket / binary streaming
    contract between the backend and the UI for milestone 1.
    - .gitignore: ignore the UI's node_modules and its build output.
2026-11-09 Desktop app milestone 1: OpenHandScan Studio (engine server + UI)
    Backend (software/ohs/server, FastAPI + uvicorn, `ohs app`):
    - REST and the live WebSocket from docs/APP_API.md: device (camera,
    replay, simulator demo), projects, scan session, processing jobs,
    result files, settings. Binary previews (JPEG) and live mesh
    snapshots (decimated to 300k triangles, coloured by coverage), with
    latest-only delivery so a slow UI never stalls the scanner.
    - Scan sessions record every frame, pause/resume, and rewind the last
    N seconds: the live model is rebuilt from keyframes and a `cut`
    event is written, which offline processing now skips.
    - Projects are plain folders; deleting moves them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
    [__main__.py, app.py, demo.py, devices.py, hub.py, imaging.py]
2026-11-09 Desktop app milestone 2: setup and calibration wizard
    Studio now walks a new scanner from the first connect to a verified
    calibration. The whole wizard also runs on the simulator, before any
    hardware exists.
    Wizard (Setup in the sidebar, #/setup):
    - Connect: lists the cameras found and marks the side-by-side stereo
    one. The camera choice and the left/right swap are saved to the
    config. Shows the Pico's port and firmware, the steps to flash it,
    and "try the simulator".
    - Self-test: camera, Pico, IMU, clock sync, each emitter (confirmed
    by the camera) and the trigger, each with a plain fix. On the
    simulator it checks the stream.
    - Print targets: the board, the AprilTag stickers and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
    [app.py, calib_guide.py, calib_results.py, calibration.py, devices.py]
2026-11-09 M3 phase 1: GPU processing on any vendor, plus ohs bench
    The heavy processing steps now run on the GPU when there is one (NVIDIA,
    AMD or Intel, discrete or integrated), through OpenCL. The CPU path
    stays as the fallback. On the simulator the GPU path is also more
    accurate than the CPU one.
    GPU layer (ohs/compute):
    - Picks one OpenCL GPU per process: a discrete one first, then an
    integrated one. It skips OpenCL CPU devices and Microsoft's software
    "Basic Render Driver", and prefers native platforms over the D3D12
    compatibility layer.
    - Config [compute] device = "auto" | "cpu" | part of a GPU name. The
    OHS_COMPUTE environment variable overrides it.
    - Without PyOpenCL or a GPU it says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
2026-11-09 RTX 3070 Ti benchmark results, M3 phase 2 plan, NVIDIA warning fix
    - VALIDATION.md: ohs bench on the owner's RTX 3070 Ti laptop.
    Full quality is 2.58x faster (3.24 -> 8.38 frames per second),
    preview 1.60x, with the same accuracy as on the Radeon 680M. All
    50 GPU tests pass on NVIDIA's OpenCL compiler.
    - DESKTOP_APP_PLAN.md: the GPU tuning still open for discrete GPUs,
    and the phase 2 (processing studio) plan.
    - APP_API.md: the "M3 phase 2: processing studio" contract.
    - depth_gpu.py: the left-right check is a compile-time #if, which
    silences the warning NVIDIA's compiler gave for a runtime test of a
    constant.
2026-11-09 Research plan: algorithms to integrate, ranked and mapped to M3-M6
    software/docs/RESEARCH_PLAN.md surveys papers and open-source work on
    active-stereo depth, laser lines, tracking, loop closure, fusion, mesh
    post-processing, multi-scan alignment, reverse engineering,
    calibration over time and difficult surfaces. Each algorithm has its
    benefit for this scanner, licence (MIT-compatible only), cost, place
    in the pipeline and a way to validate it on the simulator.
    The top 10:
    1. depth confidence and uncertainty-weighted fusion on the GPU
    2. laser anchoring
    3. degeneracy-aware tracking
    4. metrology-safe mesh edits
    5. Straighten v2
    6. N-way multi-scan merging from raw data
    7. dot-centroid triangu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
2026-11-09 Research plan: innovation track and first simulator results
    Add section 7, an innovation track of ideas that use what only this
    scanner has: world-space spacetime stereo, laser-curve bundle adjustment
    with self-calibration, a digital twin that states each measurement's
    uncertainty, laser gauges for body work (gap & flush, edges, holes),
    projector self-calibration and dot-free images, dent maps, symmetry
    tools, re-measuring from raw frames, honest averaging and scan guidance.
    Each card has prior art, licence, cost, the module it plugs into and a
    first test.
    Revise the top 10: spacetime stereo enters at #2 (in a simulator
    prototype, 4-6x lower median error than averaging per-frame depth where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
2026-11-09 M3 phase 2: the processing studio
    Every scan gets a Process page (#/projects/:pid/scans/:sid/process):
    - Stages, each a job with progress and cancel: Track (preview or full
    quality), Straighten (loop closure) and Fuse (0.5 / 1 / 2 mm).
    - Edits on the fused mesh, applied in order, with undo / redo (the last
    10 steps are cached): remove floaters, fill holes (Liepa fill with
    fairing), smooth (Taubin, or bilateral normal filtering that keeps
    edges), simplify (quadric), delete or keep a selection.
    - Selection in the viewer: box, lasso, brush and "select connected",
    with add / subtract, invert and clear, on visible faces only or
    through the model. A notice says when a new version clea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
    [app.py, mesh_shapes.py, processing.py, protocol.py]
2026-11-09 Temperature logging: the IMU chip's temperature in every recording
    Calibration drifts with heat. Logging the temperature from the very
    first hardware recording lets that be modelled later (research plan,
    top 10 #8).
    - Firmware 1.1.0 reads the LSM6DSOX's own sensor (256 LSB/degC) right
    after the first IMU sample of a stream, then about once a second, in
    the slack after a sample: "C <t_us> <centi_degC>". STATUS adds
    "temp=". A failed read is reported once (E temp-read) and stops only
    the temperature; the IMU and the emitters carry on.
    - The Pico client turns C lines into temperature events (degC, on the
    host clock) and keeps the latest in Pico.temperature_c.
    - Recordings store every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
    [devices.py, lsm6dsox.py, main.py, pico.py, test_app_live.py, test_core.py]
2026-11-09 M3 phase 3, item 1: say what the surface lets the scanner slide or turn
    For each frame, the tracker now says which motions the surface can't
    pin down. info["weak"] classifies the weak subspace of the ICP
    information as "slide" (a flat area) and/or "turn" (a sphere's axis, a
    flat area's normal), with its axis. Weak eigenvectors mix freely, so
    the subspace is classified, not each eigenvector.
    - Live hints:
    - "Flat surface: keep an edge, a crease or a hole in view, or add
    AprilTags" now shows even with the gyro, which holds rotations
    only;
    - "Round or symmetric shape" shows without the gyro;
    - a majority vote over the last 6 frames keeps them from flickering;
    - status.tracking.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
2026-11-09 M3 phase 3, item 2: depth confidence and a per-vertex confidence map
    Every depth pixel now has a calibrated standard deviation, the 1 mm
    reconstruction TSDF runs on the GPU, and every mesh vertex has a sigma
    that the viewer shows as a confidence map.
    - Depth sigma (compute_with_sigma): from the Lucas-Kanade residual of
    the sub-pixel refinement, plus terms for nearby holes, grazing
    incidence and the near range (SigmaModel, fitted per backend; on the
    GPU the model runs as kernels, about 4-5 ms). On 12 simulated
    recordings with true depth, 2 sigma covers 96.7 % of the depth errors
    on the GPU and 95.9 % on the CPU (90-99 % per recording).
    - Reconstruction (ohs/track/recon_tsdf.py, Con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
    [processing.py]
2026-11-09 Fill holes: a big hole around an object no longer turns into a spike
    Filling the large hole of a simulated scan, whose edge climbs around a
    ball sitting in it, made a patch that reached about 4.4 m from the hole
    (the mesh grew to 6.2 m). The loop (722 mm around, 918 edges) is
    ear-clipped with folds, and on folds the cotangent bi-Laplace fairing is
    nearly singular: it returned finite but absurd positions, which were
    accepted because only non-finite ones were rejected.
    - A faired patch now counts only if every new vertex stays within 1.25
    loop radii of the loop's centroid (FAIR_BOUND); otherwise the umbrella
    version is tried, and then a soap film (the membrane L x = 0, loop
    fixed), whos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
    [test_mesh_holes.py]
2026-11-10 M3 phase 3, item 3: Refine with lasers
    The laser lines are triangulated on their calibrated planes,
    independently of the dense stereo. A new Process stage pulls the fused
    surface onto them where the two disagree, and a per-frame check drops
    laser points that disagree with the dense depth.
    - ohs.mesh.anchor_to_points: each laser point's signed distance from its
    nearest vertex along the normal, then a smooth correction field by
    normalized convolution (heat diffusion on the mesh, a 5 mm Gaussian),
    Tukey re-weighting, and a fade where the laser coverage thins out.
    Only corrections over 0.1 mm apply (in full from 0.2 mm): the lines
    carry correlated errors of 0.05-0.08 mm per frame. Abo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
    [app.py, processing.py, test_mesh_anchor.py, test_server_process_studio.py]
2026-11-10 M3 phase 3, item 4: measurement-safe mesh edits
    Four edits that keep measurements honest.
    - Simplify to a tolerance (decimate max_error_mm, the default in the
    Process page): a collapse needs its quadric's mean squared distance
    within half the tolerance and neither end moving off its surface by
    more than it; the outer edge and folds are held. Straightening the
    ragged edge or flattening a fin (a fill patch back to back with a
    scan face) had moved old vertices by about 1 mm whatever the
    tolerance. Every simplify now measures how far each old vertex lies
    from the new surface (ohs.mesh.deviation) and says so: "855,246 ->
    473,148 triangles; the surface moved at most 0.062 mm (0.01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
    [processing.py, test_mesh_confidence.py, test_mesh_holes.py]
2026-11-10 M3 phase 3, item 5: Refine from the images (spacetime stereo trial)
    A trial build of world-space spacetime stereo (research plan 7.2): a new
    Process stage between Fuse and Refine with lasers measures the fused
    surface again against up to 120 frames of the recording. Each frame lights
    the surface with a different arrangement of dots, so the camera-fixed
    errors of single-frame matching don't add up.
    - ohs/track/spacetime.py: patches about 7 px across every 2.6 mm of the
    mesh, each a quadric fitted within 7 mm; which frames see each patch in
    both cameras (ray casts against the mesh); a texture test once per
    frame; a coarse-to-fine search along the normal of the ZNCC between the
    left an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
    [app.py, processing.py, test_server_process_studio.py, test_track_spacetime.py]
2026-11-10 M3 phase 3, item 6: Straighten closes large drift
    Research plan 4.4.1. Straighten could not close drift beyond about 20 mm:
    candidates came from the drifted trajectory, ICP started from the drifted
    relative pose, and the graph's fixed drift model made the line process
    prune loops that needed more bending than it allowed.
    - A wider candidate gate that grows with the camera travel between the
    two views (global_drift_frac, at most global_max_drift_mm).
    - A second check for a candidate that fails: against wider bounds, by ICP
    from the tracked pose, then from a global first guess (global_match:
    FPFH features of the coarse clouds matched by Fast Global Registration,
    else RANSAC, in Open3D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
    [test_track_posegraph.py]
2026-11-10 Spacetime: pose refinement tried (no gain); release GPU buffers after a search
    The second half of research plan 7.2, refining each frame's pose against
    the images, prototyped on the simulator (not added to the engine): every
    frame's pose fitted to where that frame alone puts the refined patches
    (the minimum of its own left-right cost), point-to-plane along the
    measurable directions, then the patches searched again.
    The poses became more consistent (error after a best rigid fit 0.051 ->
    0.027 mm, 0.133 -> 0.046 deg on the sphere scan), but the shape did not
    improve (0.037 -> 0.038 mm after a rigid fit to the truth, against
    0.019 mm at the true poses), also with the corrections smoothed over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
2026-11-10 Straighten lines the scan up on the laser crossings (research plan 7.3, poses only)
    Every frame gives two laser curves, triangulated on the calibrated planes
    independently of the dense stereo. Where curves of different frames cross
    on the surface they must meet. ohs/track/curve_ba.py solves all the poses
    together so they do:
    - curves of up to 200 frames at full resolution (stereo-checked, with
    tangents); crossings of curves from different frames (one per pair of
    curves, the miss measured along the normal of the two tangents);
    - Gauss-Newton on every frame's pose (about the scan's centre, the first
    frame fixed) with the tracked motion as a random-walk prior and a weak
    point-to-plane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
    [processing.py, test_track_curve_ba.py]
2026-11-10 GPU tuning: integrate weighs pixels on the GPU; ICP samples every 8th pixel
    From the standard bench on the Radeon 680M and the RTX 3070 Ti laptop
    (ohs bench at a024ec4), where integrate and ICP were slower on the GPU
    path than on the CPU:
    - ConfidenceTsdf (GPU): the kernel now takes the raw depth and sigma and
    applies pixel_weights' rules itself (valid depth in [min, max], weight 1,
    variance min(sigma, trunc)^2), instead of several full-image numpy
    passes on the CPU and a third image to upload. The brick search drops
    samples that share a brick with their left or upper neighbour before the
    sort. Integrate on the Radeon: 32 -> 16 ms a frame. The CPU twin and
    the GPU/CPU agreement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
2026-11-10 GPU tuning: laser lines during the depth step, ICP strides scale with the width, cheaper bricks at preview
    - FramePipeline: the laser lines of the left and right image are extracted
    in two CPU threads while the depth runs (on the GPU, or in SGBM's own
    threads). laser_extract is now how long the frame still waits for them;
    laser_extract_cpu is the extraction's own time. One thread was slower
    than two on the Radeon (the depth step's own CPU work competes).
    - Markerless ICP: icp_strides are set for 1280 px wide images and scale
    with the width, so every resolution samples about as many points: full
    quality keeps every 8th pixel at the finest level (e21a899), a 640 px
    preview every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
2026-11-10 GPU tuning: a minimum ICP spacing instead of width-scaled strides; results written up
    Scaling the ICP strides with the image width (880aa6b) made a 320x200 scan
    sample every 2nd pixel, and the CPU path's live-scan test then crashed in
    Open3D's ray cast (access violation) in 2 of 3 runs. The strides are back
    to (16, 8, 4) px, with a new minimum spacing (icp_min_spacing: 8 px at
    1280 px width, scaled): full resolution samples every 8th pixel at the
    finest level, as benched, and 640 px and below are exactly as before.
    Four CPU runs of the live tests pass; the bench is unchanged (full
    quality 172 ms on the Radeon, trajectory 0.13 mm median).
    Results of the first GPU tuning round (VALIDATION.md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
2026-11-10 GPU tuning write-up: the laptop's bench of the final version (279d709)
    The RTX 3070 Ti laptop re-ran `ohs bench --frames 90 --quality both` at
    279d709. GPU full quality 67.2 ms (14.9 fps), preview 28.4 ms
    (35.2 fps); accuracy identical to 880aa6b. The minimum ICP spacing did
    not slow the preview down. The CPU path improved as well: full quality
    332 -> 264 ms, trajectory error 0.33 -> 0.24 mm. VALIDATION.md's table
    and DESKTOP_APP_PLAN now show the final numbers (Radeon 172 / 67 ms).
2026-11-10 GPU tuning round 2: the tracking filter and the brick search on the GPU
    The two CPU steps left in the GPU path.
    - Tracking filter (ohs/track/filter_gpu.py, TrackingFilterGpu): the same
    map as tracking_depth() with the pipeline's work size (an integer
    fraction of the input) in four OpenCL kernels: edge test and block
    average, a row and a column Gaussian pass with OpenCV's kernel, an
    erosion with the offsets cv2.distanceTransform itself rates within the
    radius, and the bilinear upsampling. On the simulator 12 of 15.4 M
    pixels differ in validity. FramePipeline.tracking_input uses it when
    there is a GPU and falls back to the CPU on any error. Radeon 680M:
    16 -> 7 ms at full qual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
    [test_track_filter_gpu.py, test_track_recon_tsdf.py]
2026-11-10 GPU tuning round 2 written up: the laptop's bench (49 ms, 20.4 fps)
    The RTX 3070 Ti laptop benched 2b1eae0: full quality 67.2 -> 49.1 ms a
    frame (14.9 -> 20.4 fps), preview 28.4 -> 25.5 ms (39.2 fps), the
    trajectory error unchanged. The tracking filter went 11.5 -> 1.6 ms and
    the confidence TSDF's integration 7.4 -> 2.4 ms; the depth step waits
    less on queued GPU work (27.2 -> 23.8 ms). Since this morning (a024ec4)
    the laptop's GPU path is 2.5 times faster at full quality.
    VALIDATION.md "GPU tuning" gets a round-2 table and what limits the
    frame now (the stereo matcher, the laser threads below ~16 ms of depth,
    ICP at preview, the depth crossing PCIe several times a frame);
    DESKTOP_APP_PLAN,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
2026-11-10 Simulator: real parts' meshes; a door scans well, a carburetor breaks tracking
    - ohs/sim/scene.py: TriangleMesh, any triangle mesh as a scene object
    (Open3D's Embree ray caster, float32; hits within 0.01 mm of the ray
    origin are ignored so shadow rays don't hit their own triangle;
    interpolated vertex normals). Scene.cast asks the primitive for its
    hit normals (_hit_normal_local), so a mesh reuses its last ray cast.
    load_mesh() lays a file flat (principal axes), turns Y-up files Z-up or
    keeps them, and scales them; mesh_on_floor() builds a scene around it.
    A test checks a tessellated sphere against the analytic one.
    - VALIDATION.md "Large and detailed parts": two CC BY scans of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
2026-11-10 Tracking detailed parts: decide at the start of a scan whether the filtered depth holds
    The tracking filter erodes around every depth step, so a detailed part (the
    simulated carburetor, the bracket preset) loses most of its depth and the
    pose slides along what is left, often the bench. Now:
    - markerless: every final ICP measures how well its input holds the
    weakest translation while the gyro holds the rotation
    (_translation_strength, info["trans_strength"]; it shares the scaled
    information matrix with the weak-direction analysis). track() takes an
    alt_depth: with detail_mode every frame uses it (falling back to the
    main input for the pose when it fails), otherwise a frame tries it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
    [session.py, test_app_pipeline.py, test_track_markerless.py]
2026-11-10 Maintenance plan: 43 fix and update tasks from a review of the baseline
    software/docs/MAINTENANCE_PLAN.md lists what a review of software/ at
    db7b328 found (per-frame engine, offline processing, server and devices,
    app UI, test suite), written as tasks a Sonnet or Opus session can do
    cold: where, the problem, the change, the tests that guard it, and the
    size. Each task is marked as checked against the code by a second read or
    as reported by the reviewer only.
    - F: performance a user feels, first. Live scanning is in good shape
    (15.9 / 39.2 fps); the wait after a scan is the weak spot (computed at
    about 9 / 3 minutes per minute of scanning at full quality). Four
    tasks: measure it and s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
2026-11-10 Snapshot tool: before/after comparison of the engine output (plan A2)
    software/tools/snapshot.py processes the bench recording at preview and
    full quality and saves poses, mesh and laser points per quality;
    `compare` prints the largest difference per array and exits 0 only if
    everything is identical (or within --tol). It warns when two snapshots
    come from different compute devices.
    The mesh is stored in a canonical order (vertices sorted, faces rotated
    and sorted) because the engine returns the same mesh in a different
    vertex order on every run.
    The real-snapshot test is strict on the GPU path. On the CPU path it only
    checks loosely: the builder saw run-to-run pose differences there, which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
    [test_tools_snapshot.py]
2026-11-10 Bench: report the wait per minute of scanning (plan F1, first part)
    `ohs bench` prints one more line per run: how long a user waits for one
    minute of scanning when every frame is processed, from the mean frame
    time and the camera's frame rate (CameraParams().fps, 60). The runs also
    carry `scan_fps` and `wait_per_minute_min`.
    F1 stays open: the fixed tail after the last frame, the engine start
    time, the table in VALIDATION.md and the targets are not done.
    Full suite on the GPU path: 539 passed. The CPU-path run was still going
    when this was committed.
    [test_app_bench.py]
2026-11-10 Jobs: a job cancelled while queued now settles (plan B1)
    cancel() marked a queued job cancelled, and _run then skipped it without
    calling on_done or setting `finished`. A scan whose processing job was
    cancelled before a worker picked it up stayed in "processing".
    cancel() now calls on_done itself for a job that was still queued, once
    and outside the lock, then sets `finished`. _run flips queued to running
    under the same lock, so on_done cannot run twice. shutdown() settles
    queued jobs the same way.
    Tests: one for the runner (on_done exactly once, wait() returns) and one
    through the server (the scan leaves "processing").
    Full suite on the GPU path: 539 passed. The CPU-path run was still go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
    [jobs.py, test_server_basic.py, test_server_process_studio.py]
2026-11-10 Depth: skip the unused disparity download, share constants (plan E1, E6)
    Two plan tasks in one commit: they were done in one session and their
    tests share a hunk in test_vision_depth_gpu.py.
    E1: with exact division, GpuStereoMatcher.depth_sigma downloads only
    depth and sigma and returns (None, depth, sigma); compute_with_sigma
    converts the disparity on the CPU only when it got one. The disparity
    was downloaded every frame and never read on this path.
    E6: GPU_MIN_SIZE, LK_EPS2 and LK_MIN_TEXTURE are defined once in
    depth.py and imported by depth_gpu.py. One helper,
    _drop_gpu_if_too_small, replaces three copies of the size check.
    Evidence: snapshot of the engine output before and after is i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
    [test_vision_depth_gpu.py]
2026-11-10 Tracker: no depth copy per call, each ICP level computed once (plan E2, E3)
    Two plan tasks in one commit: both are in markerless.py, done in one
    session, and their tests share a hunk in test_track_markerless.py.
    E2: _clean_depth treated zero pixels as bad, so it copied the depth map
    on every call (one to three times a frame). Zeros are already the
    "no depth" value; only non-zero pixels that are not finite or out of
    range are cleared now, and the input is returned as it is when there are
    none. One difference: a pixel holding -0.0 is no longer rewritten to
    +0.0.
    E3: at full quality the strides (16, 8, 4) become [16, 8, 8], and
    _source_points computed the points and normals of the last level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
    [test_track_markerless.py]
2026-11-10 Lower two memory peaks: marker map and mesh refinement (plan P1, P3)
    Two plan tasks in one commit: they were done in one session.
    P1: markers._consensus built an (n, n, 3) float array for the pairwise
    distances. It now fills a bool (n, n) table in blocks of 64 rows. Peak
    at 1,410 frames: 511 MB before, 28 MB after, same time (about 0.3 s).
    P3: spacetime.project_onto_patches worked in fixed chunks of 200,000
    vertices. The chunk is now a parameter with a default of 25,000. Peak
    with 200,000 vertices and 10,000 patches: 606 MB before, 145 MB after,
    same time (2.6 s).
    The memory numbers were measured by the subagent that made the change
    and were not repeated in review. Results are unchanged: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
    [test_track_markers.py, test_track_spacetime.py]
2026-11-10 Maintenance plan: results of the first wave's slower checks
    Bench before and after (Radeon 680M, 90 frames, three runs each,
    alternating): E1 saves about 1.6 ms a frame in the depth stage at both
    qualities. E2 and E3 show about 1 ms in the tracking stage at full
    quality, inside the noise. The whole frame went from 161.7 to 160.1 ms
    at full quality, which is about the spread between runs. The raycast
    line reads 1.3 ms higher after; not explained, the frame is not slower.
    E1, E2 and E3 are ticked with these numbers.
    CPU-path test run: 509 passed, 1 failed (test_overlays, a hole with a
    perimeter of zero). The module passes alone, twice on the new code and
    twice on the old code. New task B12.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
2026-11-10 Maintenance plan: E2 and E3 timed directly
    The frame bench could not separate the gain of E2 and E3 from the noise,
    and rule 5 of the plan says such a change is not kept. Timed side by
    side on a 1280x800 depth map, the old and new functions differ clearly:
    _clean_depth 3.6 to 1.5 ms a call, _source_points 4.9 to 2.9 ms a call
    at full quality. Both changes stay.
    Only about 1.3 ms of those 4 ms shows in the frame time on the Radeon
    680M. Likely the ray cast now waits for GPU work that used to finish
    during that CPU time; not proven, to be checked on the RTX laptop.
2026-11-10 Bench: time the tail after the last frame and the engine start
    Second part of plan task F1. Each bench run now also times what a user
    waits for after the last frame: mesh extraction, cleaning, each export
    file and the laser points file, with the same calls and arguments as
    process_recording. Once per bench it starts ohs app in a new process
    with built-in settings and a temporary home folder, and times it until
    the port accepts a connection and until the first status message.
    Existing report lines are unchanged; the new ones are added after the
    wait lines. New result keys: tail_ms per run, engine_start per report.
    The start is found by asking the port with a 50 ms timeout. A plain
    connectio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
2026-11-10 Validation: the waits a user feels, measured (plan F1 done)
    Three bench runs on the idle Radeon 680M at 6e1c102. Live scanning
    15.1 to 15.3 fps, which only just meets the 15 fps target. Wait per
    minute of scanning 9.5 to 9.7 min at full quality by the bench, and
    about 11 min once frame reading is counted (from the whole-run times of
    the two long simulated scans). The target is 3 min, so it is missed by
    a factor of about 3, as on the RTX laptop (2.9 min against 1 min).
    Tail after a 3 s scan 1.8 to 1.9 s at full quality. Engine start 1.9 to
    2.0 s from a new process to the first status message; about 0.8 s of
    that passes between the app's hello message and its first status, in
    the engine and n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
2026-11-10 Validation: processing fewer frames after a scan, measured (plan F2 step 1)
    Measure only, no code change. frame_step 1 to 4 on nine simulated
    scans, full quality, Radeon 680M GPU path, each run twice.
    The wait falls as 1 / step. The trajectory and the error on the two
    large parts hold up to step 8 on the 60 fps device. On smooth surfaces
    the mesh median rises 18 to 22 % at step 2 and 47 to 53 % at step 4,
    and the floor noise 23 to 34 % at step 2. The GPU path repeats exactly,
    so this is far beyond the spread: by the plan's stop rule the default
    stays at 1 on this evidence.
    One finding for the decision in step 3: the validation scans are 30 fps
    recordings, which equal step 2 on the 60 fps d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
2026-11-10 Process: pick frames by motion with the gyro (plan F2 step 2, off by default)
    New settings process.frame_motion_deg (0 = off) and
    process.frame_max_gap (4), and ohs process --motion DEG --max-gap N.
    When on, the first frame is processed, then the next frame at which the
    gyro's rotation since the last processed frame reaches the angle, or
    the gap reaches the cap, whichever comes first. frame_step stays the
    smallest gap. The first frame after a cut is always processed.
    Nothing is skipped without gyro data: with no IMU samples, no IMU
    calibration or use_imu off it falls back to frame_step with a warning,
    and frames in a hole of the IMU stream are all processed. The second
    pass at given poses m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
    [studio.py, test_app_cli.py, test_app_config.py, test_app_frame_motion.py, test_app_pipeline.py]
2026-11-10 Validation: picking frames by motion against a fixed step, measured (plan F2 step 2)
    Measure only, no code change. Full quality, Radeon 680M GPU path, on
    the 60 fps recordings, the carburetor and the door, and two new
    recordings where the hand goes slow, fast, slow and hovers.
    At the same number of frames, picking by motion is neither better nor
    worse than a fixed step on a steady hand: it mostly picks the very same
    frames. On a hand that changes speed it puts 1.7 to 2 times as many
    frames into the fast part and the trajectory error is a little lower,
    but no fixed step lost tracking either, so the advantage is small and
    two recordings do not prove it. It does not bring back the noise that
    f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
2026-11-10 Two quality levels for the final mesh: Standard (default) and Best (plan F2 step 3)
    The owner's decision after the two F2 measurements. Standard processes
    at most process.standard_frame_rate (30) frames per second of scanning:
    every 2nd frame of the 60 fps camera, every frame of a 30 fps
    recording. Best processes every frame: less noise on smooth surfaces,
    about twice the wait. The preview is unchanged; picking frames by
    motion stays a setting, off.
    - Engine: ProcessParams.max_frame_rate; the recorded rate is 1 / the
    median time between the frames. The report has the effective step,
    recorded_fps and max_frame_rate. With given poses the limit is not
    applied, so the later stages fuse th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
    [app.py, processing.py, projects.py, protocol.py]
2026-11-11 Record F3: a narrower stereo search per frame was tried and not adopted
    The simple form of plan F3 (one disparity range per frame from the
    model's predicted depth) was built and measured. The plan's stop rule
    hit: the mean frame time on the bench fell by 2 to 7 % in five pairs
    of runs on the Radeon 680M, under the 10 % the plan asks for. The
    depth in view spans nearly the whole range in every frame, so one
    range drops only 17 % of the disparities.
    No engine change: the code stays on the branch
    experiment/f3-narrow-depth-search. VALIDATION.md has the table, the
    reason, and a weakness found on the way (false depth on surfaces
    outside a narrowed range). The plan marks F3 as tried, not adopted.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
2026-11-11 Show the time left while the mesh is made, and swap the finished mesh in (plan F4)
    The wait after a scan is not shorter, but it is usable now.
    Server: a job reports the pass over the frames it is in as an extra
    field, Job.frames (stage, done, total, measured frames per second,
    seconds since the first frame). The field is present only while a pass
    runs. The last frame's update is always sent, with a message that the
    mesh is now made from the frames. The protocol version stays 0.3.0.
    App: the time left for the running pass shows under the progress bar
    and in the Jobs menu, once at least 5 frames and 3 s (or 15 % of the
    pass) are measured. On the Scan page the finished mesh takes the live
    mod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
    [jobs.py, processing.py, test_server_basic.py, test_server_process_studio.py]
2026-11-11 Record the profile of a frame, and the three tasks it leads to (plan F5 to F7)
    VALIDATION.md gets "Where a frame's time goes": the stages of a Standard frame
    on the Radeon 680M, the device time of every matcher kernel, and where the
    tracker's host time goes.
    The main finding: the stereo matcher drops the event of a non-blocking copy,
    and pyopencl waits for such an event without releasing Python's lock. The main
    thread holds the lock for about 78 ms per frame and the two laser threads
    wait for it. With the events kept alive (patched in from outside) the mean
    frame fell by 4 to 5 % in two pairs of bench runs, with identical results.
    The plan gets F5 (that fix), F6 (read the recording one fra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
2026-11-11 Let the laser threads run while the stereo matcher waits for the GPU (plan F5)
    GpuStereoMatcher._run dropped the event of its first output copy at once.
    pyopencl waits for a dropped copy event without releasing Python's lock, so
    the main thread held the lock for nearly the whole matcher run and the two
    laser threads beside it stood still. The events are now kept until the
    blocking copy at the end has returned.
    Radeon 680M, GPU path, Standard, 90 frames, old and new runs alternated:
    mean frame 160.8 / 161.4 ms -> 151.4 to 152.7 ms (5 to 6 % less), wait for
    the laser threads 16.3 -> about 1 ms. The depth stage itself is 5 ms slower
    now that the threads run beside it. The snapshot is identical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
2026-11-11 Read the recording's frames ahead in a thread during Make mesh (plan F6)
    The frame pass read each frame's two images when the pipeline asked for
    them, 16 to 17 ms in which nothing else ran. RecordingReader.iter_ahead
    now reads them in a thread, at most two frames before they are needed, in
    the same order; a read error is raised in the pass at its frame, and the
    pass closes the iterator when it ends, fails or is cancelled.
    Radeon 680M, GPU path, default settings, 150 frames of a recording on
    disk, old and new runs alternated three times: 167.5 to 172.9 ms per
    frame -> 149.7 to 152.1 ms (about 11 % less). Same mesh in all runs, and
    the snapshot is identical.
    Not changed: the later passes (po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
    [test_core.py]
2026-11-11 Build the tracker's model view only where ICP reads it (plan F7)
    A line-by-line timing of the frame pass (355-frame recording, Radeon
    680M, GPU path) shows that of the tracker's 53 ms per frame about 17 are
    waits for the device, and that the host work that can go without
    changing a result sits in two places:
    - The GPU model view built float64 vertices and normals for all
    1280x800 pixels (8.2 ms), though ICP reads them only where a source
    point lands. _ModelView.at(pix) now makes them at those pixels, with
    the same arithmetic per pixel; .V and .N still give the whole maps.
    The Open3D view keeps its whole maps.
    - np.count_nonzero on a float32 depth map takes 3.6 ms; counting
    depth !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
2026-11-11 Let the reconstruction's fusion run without waiting for the GPU (plan E4)
    ConfidenceTsdf.integrate ended with a wait for the device (5.4 ms per
    frame on the Radeon 680M), only to keep two small host arrays alive. It
    now returns once the fusion is queued:
    - the two brick lists are kept in _lists until the next frame;
    - download, reset, close and every buffer release wait first (_wait);
    - the depth and sigma uploads are still waited for, now with
    wait_for_events, which does not hold the GIL, so the caller's arrays
    are its own again when integrate returns.
    The pass goes on with the laser points and the next frame's
    rectification while the device works. 150 frames, default settings, old
    an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
    [test_track_recon_tsdf.py]
2026-11-11 Triangulate the laser points while the frame is tracked (plan E5, part)
    A frame's laser points need its depth and laser lines, not its pose.
    FramePipeline.process now hands laser_points to one of the two laser
    threads as soon as both are there, and takes the result after tracking
    and fusion. The cloud and the rejected counts are still updated on the
    main thread, in the same order, and only for a frame that got that far.
    150 frames, default settings, Radeon 680M, old and new runs alternated
    three times: 137.0 to 137.4 ms per frame -> 133.4 to 134.3 ms (about
    3.3 ms, 2.4 %). Same mesh in all runs, and the snapshot is identical.
    timings_ms["laser_triangulate"] is now the wait that is left aft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
2026-11-11 Start the tracking filter early, on the matcher's depth buffer (plan E5, part)
    The depth map was downloaded from the GPU and uploaded again for the
    tracking filter (4 MB), and the pass waited for the filter before going
    on. Now:
    - GpuStereoMatcher.device_depth / DepthEstimator.device_depth give the
    device buffer that holds the depth map just returned (only where the
    device divides exactly, so the buffer is that very map);
    - TrackingFilterGpu has start (a map or such a buffer, no wait) and
    finish; a plain call is start + finish;
    - FramePipeline.process starts the filter as soon as the depth is there
    and tracking_input collects it for the same array. The device filters
    while the hos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
2026-11-11 Plan: note what is left of E5, record the first look at the SGM kernels
    E5: the owner said to move on and note what could still be better. Three
    things are left (the reconstruction and the tracking volume read the depth
    from the matcher's buffers, the tracking filter queued behind the matcher),
    together at most about 3 to 4 ms of 132 ms per frame on the Radeon.
    SGM kernels: sgm_vertical 28.2 ms and sgm_horizontal 28.0 ms per frame.
    Three changes with identical results were tried (stored matching cost,
    column-major path costs, in-place sums). The first was slower, the second
    gave nothing, the third stayed inside the noise. No code change. What is
    left changes the depth map and needs the owne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
2026-11-11 U1: the 10 Hz status no longer re-renders the Scan and Project pages
    The engine sends the session with every status message, ten times a second,
    scanning or not. The store saved a new object each time, and the Scan and
    Project pages read the whole object, so both pages and the live 3D scene
    were rendered again ten times a second.
    - store/sameSession.ts: a pure comparison; the store keeps the old object
    when the new one is equal. Node test added to npm test (16 checks).
    - ScanPage reads only the phase, ProjectPage only "scanning here".
    - LiveCanvas is memoised.
    Renders counted in npm run dev:mock over 10 s (development mode renders
    twice): Scan page, LiveCanvas and its scene 152 -> 0, idl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
2026-11-11 U8: the first use of Measure no longer freezes the viewer for seconds
    The tree for picking points on the mesh is built on the first use of
    Measure or of the confidence view, on the main thread. drei's default
    split (SAH) is the slow one to build. The CENTER split builds about five
    times faster and gives the same hits.
    Measured in Chrome on this PC, with drei's other options unchanged:
    852,847 triangles (a usual scan): 1724 ms -> 316 ms
    3,627,310 triangles (door at Best): 7173 ms -> 1587 ms
    3000 rays through each mesh give the same hit distances with both splits,
    to the last digit; 3000 rays take 10 to 13 ms with either.
    In the app (npm run dev:mock, 235,674 triangles, development m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
2026-11-12 B10: a failed Pico open no longer leaves the serial port open
    When the Pico opened its own serial port and clearing the port's input
    buffer then failed (a port pulled out right away), the error went up
    without the shutdown that the rest of open() has, so the port stayed
    open and could not be opened again until the program ended.
    The clearing now has its own try with the same shutdown. It still runs
    before the reader thread starts, so stale bytes are dropped first as
    before.
    New test test_open_closes_its_port_when_clearing_the_input_fails: failed
    on the old code (port not closed), passes now. test_devices_pico.py
    (13 passed, the real-Pico test skipped), test_server_devices.py and
    test_serve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
    [pico.py, test_devices_pico.py]
2026-11-12 B8: the Viewer no longer parses a mesh after you leave it
    The Viewer parses a downloaded mesh in a 30 ms timer, so the "Preparing"
    state can paint first. The timer did not check whether the load had been
    cancelled meanwhile (the Process page does). Leaving the Viewer, or
    changing scan, in that window still parsed the whole mesh after the
    page's clean-up had run, and on a scan change the old mesh could replace
    the new download's progress.
    The geometry never reached the GPU and was freed by the garbage
    collector, so this was wasted work rather than a lasting leak.
    Checked in the mock app with the timer stretched to 1.5 s in the page:
    leaving during it, the callback takes 0 ms (nothing parsed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
2026-11-12 B12: a hole with a perimeter of zero is no longer listed
    hole_outlines listed every boundary loop that is not the outer border,
    also a collapsed one whose vertices all sit on one spot, so the app's
    hole list could show a hole of 0.0 mm.
    Confirmed with a sphere missing one triangle whose three corners were
    moved to one spot. Such loops are now left out of the list, in
    hole_outlines itself: one condition, nothing changes for loops with a
    real perimeter. Merging coincident vertices in the clean-up was the
    other choice; it would change every mesh, so it was not taken.
    New test test_a_hole_whose_vertices_coincide_is_not_listed: failed on
    the old code (one extra hole with perimeter_mm 0.0), pass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
    [test_mesh_holes.py]
2026-11-12 B7: a GPU failure mid-scan is now recorded, not only logged
    When the GPU stereo matcher or the GPU tracking filter failed during a
    scan (lost device, out of memory), the pipeline logged a warning and went
    on on the CPU for the rest of the scan: about four times slower, with
    another depth noise model, and nothing in the results said so.
    Now:
    - DepthEstimator.gpu_failure holds why the matcher failed (not set for
    the planned, quiet switch on images too small for the GPU).
    - FramePipeline.gpu_fallbacks maps each failed stage ("depth",
    "track_filter") to its reason, for the whole run.
    - The frame on which a stage switches carries extra["gpu_fallback"]
    with the new entries.
    Nothing else ch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
    [test_app_pipeline.py]
2026-11-12 B2: a failed frame write is now reported
    The recording writer saved frame images with cv2.imwrite in a thread
    pool. cv2.imwrite returns False when it fails (a full disk, for example)
    and nothing read that value; and finished futures were dropped when the
    list was pruned, so even a write that raised was lost. A scan could end
    "fine" with frames missing, and processing then stopped at the first
    missing file.
    - frames are written through _imwrite, which raises OSError when
    cv2.imwrite returns False (same call, same arguments otherwise, so a
    clean recording is unchanged);
    - RecordingWriter.error keeps the first failed write, also when the
    list of pending writes is pruned;
    - close() s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
    [test_app_live.py, test_core.py]
2026-11-12 B5: rewind's model choice pinned by a test; a failed rescale is a warning
    The plan asked whether a rewind could meet the confidence TSDF, which
    cannot rescale its weights. Confirmed that it cannot happen today: the
    live session takes its parameters from PipelineProcessor.params(),
    which pins recon="open3d", and both models a rewind rescales (Open3D's
    TSDF and the GPU tracking volume) have scale_weights. So there is
    nothing to measure and no scale_weights to add to ConfidenceTsdf.
    What changes:
    - a test pins the choice: a ScanSession's parameters use recon
    "open3d" (passes on the old code too, as a pin should);
    - a failed rescale is now logged as a warning instead of at debug
    level, sinc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
    [session.py, test_server_rewind.py]
2026-11-12 Plan: B13 checked and not needed
    B13 (found during B12) said fill_holes also patches a collapsed boundary
    loop, with a face of area 0. True, but on the B12 test mesh that face is
    what closes the mesh: mesh_stats goes from watertight False, 1 hole, to
    watertight True, 0 holes. Leaving the loop out of fill_holes would leave
    the mesh open, which is worse for an STL, so nothing is changed.
    Docs only.
2026-11-12 B3: a recording stays readable after a crash mid-scan
    frames.csv got a frame's row as soon as its PNG was queued, before the
    file existed, and the three CSV files were only flushed at close(). A
    crash or power loss mid-scan could leave rows pointing at missing or
    half-written PNGs, or lose many rows, and the reader then stopped at
    that frame.
    Now the pending PNG writes are kept in frame order with their rows, and
    a row is written only once its PNG write has returned, still in frame
    order. The CSV files are flushed about once a second while frames, IMU
    samples or events come in (flush only, no fsync); RecordingWriter.flush()
    does it on demand. close() writes the remaining rows as before.
    No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
    [test_core.py]
2026-11-12 B4: the recording backlog is capped in the writer and shown in the status
    If PNG encoding fell behind the camera, frames piled up with no limit
    (about 4 MB each) and nothing showed it.
    - RecordingWriter now uses min(8, cpu count) PNG threads by default
    (was 4) and waits on the oldest PNG write while twice that many
    frames are unwritten. Only the recorder thread (ohs-recorder) waits:
    the camera thread only puts frames into the Recorder's queue.
    - Recorder.backlog counts the frames in that queue plus the writer's
    unwritten PNGs (it had no caller and counted every queue item); a
    warning is logged once when it passes 120 frames (about 0.5 GB,
    about 2 s at 60 fps).
    - The status messa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
2026-11-12 B6: undo/redo no longer holds the app's main lock while writing files
    An undo or redo of a mesh edit held Studio._lock while it loaded the
    step (replaying the edits when it was not cached) and wrote the PLY,
    the STL and an optional OBJ. Start scan, stop scan, the trigger and
    connect all wait on that lock, so they waited for the files.
    Now _move checks the 409 rules under Studio._lock, takes the scan's
    own lock before letting Studio._lock go (so no job on that scan can
    start in between), and loads and writes the step under the scan lock
    only. The lock order stays Studio._lock -> scan lock -> store locks,
    and the scan-lock holder never takes Studio._lock, so no cycle can
    form. Status codes, 4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
    [processing.py, studio.py, test_server_process_studio.py]
2026-11-12 B14: a recording cut by a crash no longer trips over its last CSV line
    Python writes a file's buffer out when it fills, which can be in the
    middle of a line, so after a crash mid-scan the last line of
    frames.csv, imu.csv or events.csv can be cut short. The reader then
    listed a frame with a broken file name ("0000" for "000003.png"), read
    a wrong IMU value or a half event, and the scan list counted the row.
    Every writer ends its rows with a line end (RecordingWriter, the
    calibration recorder, the one test that appends rows), so a last line
    without one is the cut one. The reader now leaves that line out for
    all three files (_complete_lines), and _count_rows counts only lines
    that have a line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
    [projects.py, test_core.py]
2026-11-12 B11: the self-tests share their image and gravity checks
    The hardware self-test (ohs.app.selftest, used by `ohs selftest` and by
    the app with the real scanner) and the app's stream self-test (simulator
    or replay) had copies of the "camera image" check and of the gravity
    range. They now share image_check (thresholds and messages; each caller
    adds its own hints) and gravity_ok (9.3 to 10.3 m/s^2).
    The accelerometer value itself stays as each test computes it, on
    purpose: the hardware test takes the norm of the mean, so turning the
    scanner during the test (it should be held still) gives a warning; the
    stream test takes the mean of the norms, since a replayed scan moves.
    So no check result and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
2026-11-12 A3: UI tests for the PLY reader, binary frames and downloads
    - npm test now runs every src/**/*.test.ts with node's test runner
    (each file still prints its own count); it listed files by hand.
    - parsePly and its types moved unchanged into src/three/plyParse.ts,
    which has no imports, so node can load it in a test. ply.ts imports
    and re-exports them; no importer changes. The moved lines were
    compared with the old ones: identical.
    - ply.test.ts (36 checks): all triangles, quad and pentagon fans with
    the face map, the filled property, big-endian against little-endian,
    ASCII / non-PLY / truncated / bad index giving null, an empty face
    element, degenerate faces. Two checks are marked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
2026-11-12 Camera: ask for MJPG again when setting the size drops it
    The ELP OV9281 stereo board, plugged in for the first time, gave raw YUY2
    at 5 fps through DirectShow: it forgets the requested format once the
    frame size is set. The engine now reads the format back after size and
    frame rate and asks for it again if it changed. Cameras that need the
    format first keep getting it first.
    On this PC the self-test now reports MJPG at about 46 fps instead of
    YUY2 at 4 fps. The rest of the gap to 60 fps is DirectShow's own MJPG
    decoder (18-20 ms per 2560x800 frame).
2026-11-12 Docs: a roadmap from the owner's vision notes
    software/docs/ROADMAP.md: the vision and its principles (accuracy over
    appearance, keep the original evidence, the user decides when a scan is
    finished, no accuracy claim before measuring against reference parts),
    where the project stands area by area, what comes next (fitted shapes in
    the viewer, a deviation map, confidence the user can act on, showing
    laser/stereo disagreement, then reference parts on the real hardware),
    what comes later, what is left out on purpose (a public plugin API for
    now), and the open questions with what is known today.
    It links to the app, research and maintenance plans and VALIDATION.md
    instead of repeating them. Doc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
2026-11-12 Docs: the roadmap names the LED projector as the build route
    The owner chose the LED dot projector (option B) for the build today;
    the laser + DOE projector (option A) stays available. The roadmap's
    measurement-methods row said otherwise. Docs only.
2026-11-12 Housing: alignment pins, a yoke that clamps the grip, rounder product look
    Alignment pins
    - Faceplate and back cover each carry two printed 3 mm pins that drop
    into holes in the head (one hole of each pair is a short slot).
    - The right grip half carries two 4 mm pins into the left half's ledge.
    Stiffer grip mount
    - The head grows two cheeks with gussets under the camera block (the
    yoke). The top of the grip slides between them and is held by four
    M3 x 10 cross screws into new heat-set inserts in the grip's ledge,
    in addition to the four screws from above. This is what resists the
    head rocking sideways on the grip.
    - The grip's solid top ledge is 14 mm (was 7); the trigger button m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
    [back_cover.stl, faceplate.stl, grip_left.stl, grip_right.stl, head.stl, head_led.stl, head_led_cla020.stl, scanner.scad]
2026-11-12 App: Make mesh starts by itself when a scan is stopped
    The wait after a scan now starts at the moment the scan ends: Stop
    starts "Make mesh" at Standard quality, exactly as the button does,
    when the scan has frames. The post-scan card shows "Making the mesh…"
    with its progress and Cancel at once.
    A switch under Settings, "After a scan", turns it off (a preference
    kept in the browser like the theme, on by default); then Stop shows
    "Scan saved" and the Make mesh button with its quality menu as before.
    The first-scan guide's last line follows the switch.
    Checked in the app with the mock engine: with the switch on, a stopped
    simulator scan showed "Making the mesh…" right away; with it off,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
2026-11-12 Housing: shaped grip and flush screws on the faceplate and back cover
    Grip
    - Lofted through sections along its length instead of one straight
    section: straight at the top (yoke, button), a relief for the fingers
    under the button, a swell for the palm, and a hook at the bottom.
    - Its width stays constant, so both halves still print flat on their
    outer faces without supports.
    Screws
    - The faceplate and the back cover are countersunk for M3 x 8 flat-head
    screws, which sit flush with the surface (was: socket heads standing
    proud). flush_screws = false in scanner.scad brings the old seats back.
    - Fully hidden screws were not done: the only clean way ties the
    faceplate to the back cov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
    [back_cover.stl, faceplate.stl, grip_left.stl, grip_right.stl, scanner.scad]
2026-11-12 P4: the laser cloud is averaged once per processing run
    process_recording voxel-averaged the laser cloud to write
    laser_points.ply, averaged it again for the report's exported count,
    and joined every raw chunk per laser just to take its length. Now the
    points are averaged once, written and counted, and the raw counts come
    from the chunk lengths (new LaserCloud.raw_counts).
    Measured on a cloud as large as the largest real scan (602,000 raw
    points; the door at Best quality has 605,000): 220 -> 110 ms, three
    runs each, the written file byte-identical.
    The same 16-frame simulated recording processed with the old code (a
    temporary checkout of HEAD) and the new: the same report["lasers"] and
    a b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
2026-11-12 Plan: M5 first slice, fitted shapes in the viewer
    DESKTOP_APP_PLAN.md gets the plan for the roadmap's first "Next" item,
    based on RESEARCH_PLAN.md 4.8.1-4.8.4: a Fit tool in the viewer (plane,
    cylinder, hole by one click), fits weighted by each vertex's sigma with
    ± values from the covariance, region growing over the mesh, an API
    endpoint, relations between two fits, and a simulator check against the
    bracket's bosses and shaft and the car panel's hole. Five steps, one
    commit each, tests first. Docs only.
2026-11-12 Faceplate: fitted to the measured ELP stereo board
    The board arrived and was measured: PCB 80 x 16.5 mm, lenses 60 mm apart,
    14 mm across and 16 mm above the PCB, four M2 holes in the corners with
    their edges 0.8 mm in (centres 1.9 mm in).
    The posts move to the board corners (+-38.1, +-6.35 mm). They are 4.4 mm
    across and the lens openings 16 mm, so posts and openings stay apart. The
    posts are 10 mm tall, so the lenses stand about 2 mm proud of the
    faceplate and can be turned to focus. The assembly dummy is a 14 mm round
    lens. Only faceplate.stl changes; README and PARTS record the numbers.
    [faceplate.stl, scanner.scad]
2026-11-12 M5 step 1: plane, cylinder and circle fits with uncertainty
    New package ohs.measure (engine only, pure functions):
    - fit_plane: weighted total least squares (exact), with flatness, RMS,
    and ± for the normal's direction and the offset.
    - fit_cylinder: a start axis from the normals (or a given axis, or a
    robust guess), then Levenberg-Marquardt on the true distance to the
    axis; radius, axis and position with ±. Works on partial arcs (down
    to 90°) and short cylinders.
    - fit_circle: a circle in 3D for holes, plane given or fitted, then a
    geometric fit; radius (and diameter), centre with ±.
    Weights are 1/sigma² from each point's sigma. The ± values (1 sigma)
    come from the covarian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
    [test_measure_fit.py]
2026-11-12 ESP32 variant: the same firmware runs on a Waveshare ESP32-S3-Pico
    For builders who cannot get a Raspberry Pi Pico.
    Firmware: the pin map is now chosen by sys.platform (PINS in main.py).
    The "esp32" map is for the Waveshare ESP32-S3-Pico, a board in the
    Pico's shape, and uses the same physical pins as the Pico (4, 5, 9, 20,
    6, 7), so the wiring diagram is the same for both boards. On an ESP32
    the firmware logs "L board esp32" after its boot line. Nothing changes
    on a Pico: same pins, same lines, same protocol.
    PC side: find_pico_port also finds an ESP32's native USB port
    (Espressif's USB ID 0x303A). A Pico still comes first. USB-serial bridge
    chips (the board's CH343, CP210x) are never pic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
2026-11-12 M5 step 2: one click grows a plane, cylinder or hole region and fits it
    ohs.measure.fit_at(V, F, face, point, kind, sigma, filled): from the
    clicked face, grow over the mesh the region that matches the kind and
    fit it with step 1's fits.
    - Plane / cylinder: a seed patch around the click is fitted first; then
    faces join when all three vertices lie within the tolerance of the
    current fit and their normal agrees with it (the plane's normal, or
    the cylinder's radial direction, outward for a boss, inward for a
    bore). The fit is redone as the region grows; the tolerance and the
    angle stay fixed at the seed's, so a region cannot loosen its own
    test. Default tolerance: 3 x the seed's me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
    [test_measure_region.py]
2026-11-13 M5 step 2 fix: a too pessimistic sigma no longer loosens a fit's region
    fit_at's default tolerance was the larger of 3 x the seed's median
    sigma and 3 x its measured scatter, and each vertex could also stray
    3 x its own sigma. A scan's sigma can claim far more noise than the
    surface shows: on the 10-frame simulated test scan the table's
    vertices claim about 3 mm while it scatters 0.4 mm, so the tolerance
    became 13.9 mm and a plane clicked on the table took in part of the
    sphere.
    Now sigma sets the tolerance (and the per-vertex allowance) only while
    the seed's median sigma is at most twice its measured RMS; otherwise
    the scatter alone sets it and sigma is only the weight. Where sigma
    is righ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
    [test_measure_region.py]
2026-11-13 M5 step 3: POST .../fit, one click to a fitted shape
    POST /api/projects/{pid}/scans/{sid}/fit {kind, face, point,
    tolerance_mm?, version?} runs ohs.measure.fit_at on the scan's current
    mesh, the one the viewer shows, with each vertex's sigma and each
    face's filled flag (ProcessManager._load_step). The arrays are kept per
    mesh version, so the next click does not load them again. Read-only:
    no main lock; the scan lock only while the arrays are fetched.
    The answer: the shape with its ± values, the region's faces (base64 of
    little-endian uint32, like selections), the count, the tolerance used
    (null for a hole), the mean sigma of the fitted points, plain warnings
    and the mesh version. 409 befor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
    [app.py, processing.py, test_server_process_studio.py]
2026-11-13 Plan: P7 measured, not adopted
    Straighten fuses the whole scan a second time only when the loops and
    then the laser crossings both change the poses. With real tracking that
    never happened (0 of 11 runs: 6 simulated orbits, 5 studio
    recordings); only synthetic drift triggers it. When it does, the
    thrown-away fuse is 18-27 % of Straighten and 12-14 % of Make mesh.
    The plan's idea, a coarse reference fuse (preview quality or twice the
    voxel), saved up to 4.9 s at 1280x800 but made the mesh measurably
    worse in several cases (bracket object +7 %, floor +16 %, sphere 640
    +10 %) and adds a fuse to the common looped case (Straighten 26-41 %
    slower there). By the plan's stop rule it is not adopted;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
2026-11-13 M5 step 4: the viewer's Fit tool
    The viewer gets a Fit tool next to Measure (G; P / C / H choose Plane,
    Cylinder or Hole). One click asks the engine (POST .../fit); the
    region lights up on the mesh, a label shows the result with its ±
    ("Plane · flat within 0.55 mm", "Hole Ø 24.00 ± 0.07 mm"), and the
    side panel lists each fit with its numbers (points, residual RMS,
    flatness or diameter with ±, direction and position ±, mean sigma,
    tolerance) and the engine's warnings. Pick two fits for their
    relation: the angle between planes and axes; the distance between
    parallel planes (± as the root-sum-square of the offsets, tilt
    ignored, said in the tooltip), between axes, and from a hole's cent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
2026-11-13 Deviation map, plan and step 1: signed distance to the measured mesh
    Plan (DESKTOP_APP_PLAN.md, "M5 plan, second slice"): a Deviation
    shading that shows how far the edited mesh has moved from the scan's
    base mesh (the last stage's result, before any edit), with a limit the
    user sets, in four steps.
    Step 1, ohs/mesh/offset.py:
    - surface_offset(V, V_ref, F_ref, F=, filled=): for each vertex, the
    signed distance to the reference surface: the nearest point on it
    (Open3D's RaycastingScene), with the sign of the reference face's
    normal there (+ outward, - inward), so it works on open meshes.
    Vertices that only filled faces use get NaN: they were not measured
    and have nothing to compare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
2026-11-13 Deviation map step 2: the API
    GET .../process/deviation.json and .../process/deviation.bin compare
    the scan's current mesh with its base mesh (the last stage's result,
    before any edit): one signed float32 per vertex of result/mesh.ply, in
    its order (NaN for vertices that only filled faces use), and its
    statistics. With no edits every value is 0 without any computing. Made
    once per mesh version and kept; a second request during the first
    waits for it. 409 before there is a mesh. The contract is in
    APP_API.md.
    Test test_the_deviation_map_follows_the_edits: zeros with no edits;
    after remove floaters, fill holes and smooth, one value per vertex of
    mesh.ply, NaN exactly on the filled-only vertic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
2026-11-13 Deviation map step 3: the Deviation shading in the app
    A "Deviation" shading (key 5, next to Confidence) on the Process page
    and in the viewer shows how far the edited mesh has moved from the
    mesh as measured: blue = inward, grey = unchanged, orange-red =
    outward, saturating at a limit the user picks (0.05 to 1 mm, default
    0.1, kept as a preference); surface added by filling a hole is striped
    ("new, nothing to compare"). It is off, with a reason, while the scan
    has no edits.
    - The legend: the colour bar with its limit, the share of the surface
    within the limit, the largest and the 95 % move, the share that is
    new, and what it compares with.
    - The value under the cursor: "+0.034 mm (outw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
2026-11-13 Plan: M5 third slice, areas that need another pass
    DESKTOP_APP_PLAN.md gets the plan for the roadmap's third "Next" item:
    a Check panel where the user gives the tolerance the part needs and the
    app lists the areas whose own 2-sigma is larger, the surface that hole
    filling made up, and the open holes, with the share of the surface that
    meets the tolerance. Four steps: the areas (ohs/mesh/check.py), the
    API, the panel with highlight and camera move, and a simulator check
    of how well the list matches the true error. Docs only.
2026-11-13 M5 step 5: fitted shapes checked against the truth; the ± is not the accuracy
    VALIDATION.md, "Fitted shapes against the truth": the Fit tool's
    numbers on simulated scans of the bracket and the car panel (5 seeds,
    true poses and real tracking, 15 fits per shape).
    - The ± values are too small, mostly from systematic errors of the
    scan (stereo, fusion, tracking) that the fit cannot know. For ±2σ to
    cover 95 % they would have to grow 1-5 times at true poses and 5-60
    times with tracking: no single factor.
    - With tracking a Ø 14 mm boss reads 0.4 mm large and a Ø 16 mm shaft
    1.1 mm large.
    - The panel's Ø 25 mm hole cannot be fitted: the stereo depth fills it
    in and the fused open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
    [test_measure_region.py]
2026-11-13 Check panel step 1: the areas that miss a tolerance
    ohs.mesh.weak_areas(V, F, sigma, filled, tolerance_mm, k=2): a face
    fails when it is filled or has a vertex nothing measured ("not
    measured"), or when k times the mean sigma of its vertices exceeds the
    tolerance ("uncertain"). Failing faces that share an edge form an area.
    The result has the share of the surface that passes, is uncertain and
    is not measured, and the areas, largest first (at most 50): kind, area,
    share, centre, extent, radius, sigma median and worst, and faces.
    Areas under a minimum are not listed but count in the shares. The
    default minimum is the larger of 4 mm² and 10 times the mesh's median
    face area, so a coarse mesh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
    [test_mesh_check.py]
2026-11-13 Check panel step 2: POST .../check
    POST /api/projects/{pid}/scans/{sid}/check {tolerance_mm} runs
    ohs.mesh.weak_areas on the scan's current mesh with each vertex's sigma
    and the filled flags (the arrays the fits keep per mesh version) and
    answers the share of the surface that meets the tolerance, is uncertain
    or was not measured, and the areas, largest first, with their faces
    (base64, as for fits) and the mesh version. A mesh without sigma (made
    without a GPU) says so and lists only its filled areas. 409 before a
    mesh, 422 for a bad tolerance. The contract is in APP_API.md.
    Test test_check_lists_the_areas_that_miss_a_tolerance (a loose and a
    tight tolerance on the simulated scan; both the G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
    [app.py, processing.py, test_server_process_studio.py]
2026-11-13 App: warnings when saving falls behind or the GPU stops mid-scan
    - Server: the status message gets gpu_fallback (null, or stage ->
    reason once a GPU stage failed in the running scan and went on on
    the CPU). The scan thread reads it from its own pipeline after each
    frame and sends one notification when it first happens. APP_API.md
    lists record_backlog and gpu_fallback with the status fields.
    - Scan page: two warning chips next to the recording chip. "Saving is
    behind: N frames waiting" shows above 60 waiting frames and hides
    below 20, so it does not flicker; "Graphics card stopped: running
    slower" names the stage and reason in its tooltip.
    - The mock engine sends both fields and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
    [session.py, studio.py, test_server_live.py]
2026-11-13 Check answer and deviation map against the truth; two defaults follow
    VALIDATION.md, two new sections from the 20 simulated meshes of the
    fitted-shapes study:
    "The Check answer against the truth": weak_areas with k = 2 is safe
    (what it passes is truly within tolerance, 97-100 %) but useless as it
    is: at +-0.3 mm it passes about 10 % of a scan where 90-94 % is truly
    within, and on the bracket itself 0.1 %. On flat surface sigma is
    about 2.5 times too large; at edges, small features, hole rims and
    borders it misses bias. No single factor repairs it (k = 0.5 just
    holds 95 % on whole scans, no k below 1 works on the bracket part).
    The Check panel in the app (step 3) is on hold until sigma is ri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
2026-11-13 Holes filled in: the cause and the fixes tried, written up
    Documentation only; nothing in the engine changes. A study with
    prototypes outside the repository, on simulated scans.
    VALIDATION.md, new section "Holes filled in: the cause, and fixes
    tried":
    - The fill is the stereo matcher's: its windows spread the panel's
    depth into a hole whose background it cannot see (86 % seen by one
    camera only, 77 % in the projector's shadow). It is on every side of
    the hole, so it is not a half-occlusion effect and a left-right check
    removes 2-12 % of it. Fused from true depth the hole fits 26.17
    (truth 25.20): the fusion adds nothing, but it acts as a union.
    - A guard that drops depth within 8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
2026-11-13 S1: ohs --help and ohs config load neither OpenCV nor numpy
    ohs.app.config imported CameraParams from ohs.devices.camera (OpenCV)
    and PicoParams from ohs.devices.pico (numpy), so every command line
    call paid for both. The two dataclasses now live in
    ohs/devices/params.py, a module with no heavy import; camera.py and
    pico.py re-export them, so existing imports work and the classes are
    the same objects.
    PicoParams moved too, beyond the plan's wording: numpy is most of the
    time (about 300 ms; OpenCV itself about 45 ms), and pico.py loads it.
    Guard first: a new test imports the command line in a fresh interpreter,
    builds the parser and checks that cv2, numpy, scipy, open3d and pyopencl
    are not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
2026-11-13 U4: a shading switch no longer rebuilds the lighting environment
    StudioEnvironment built the room environment (PMREM) in one effect that
    also depended on the intensity, and the Viewer and the Process page pass
    a different intensity for Studio shading. So every switch to or from
    Studio threw the environment away and built it again.
    Now the environment is built once per renderer and scene, and a second
    effect sets the intensity.
    Counted in the built app against the engine, in the viewer on a scan of
    650 k triangles, by wrapping WebGL's createTexture / createFramebuffer:
    - before: Clay -> Studio 16 textures and 87 framebuffers, Studio -> Clay
    2 and 42;
    - after: 0 and 0 for both, three switc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
2026-11-13 The vertex sigma: why it is too large, and a candidate model, written up
    prototypes outside the repository, on the 20 simulated meshes, models
    fitted on seeds 0-2 and reported on seeds 3-4.
    VALIDATION.md, new section "The vertex sigma: why it is too large, and
    a candidate model":
    - The pixel sigma is about right on flat, well-seen pixels (median
    |error| / sigma 0.48-0.60). The vertex sigma is 4-5.5 times too large
    because a voxel's mean of the capped variances is dominated by a few
    observations next to gaps (the matcher inflates those up to 121
    times), plus the incidence factor, depth taken along the ray instead
    of th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
2026-11-13 P2: remove floaters carries sigma and filled flags by index
    After remove_floaters, each vertex's sigma and each face's filled flag
    were found again with a KD-tree search over the old mesh, although the
    edit knows what it kept. The default recipe runs this on every scan.
    remove_floaters(..., return_kept=True) now also returns the indices of
    the faces it kept. carry_sigma and carry_filled follow the mesh by them,
    the way they already do for delete_faces / keep_faces. The server's
    _apply returns those faces as a third value. Without the faces, both
    functions search as before.
    Measured on two real scans (857 k faces, about 3,700 removed, filled
    flags from Fill holes first), medians of 3: the c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
2026-11-13 Pico watchdog test: wait for the warning instead of racing it
    test_watchdog_turns_emitters_off_when_host_goes_silent waited until
    pico.emitters read (0, 0, 0) and then looked for the warning in the log
    at once. The reader thread sets the levels first and writes the warning
    on the next line, so the test could look between the two.
    It failed once in the full CPU-path run after c348f70 and once in five
    runs alone. The test now waits up to 1 s for the line before the same
    assertion; nothing in the driver changes. 15 runs alone: no failure.
    Full runs after c348f70: GPU path 721 passed; CPU path 677 passed,
    43 skipped, and this one test failed.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
    [test_devices_pico.py]
2026-11-13 The vertex sigma: the new model, built into the fusion
    The sigma stored with every vertex was 4 to 5.5 times too large on flat
    surface and too small at edges (VALIDATION.md, "The vertex sigma"). The
    candidate model of that study is now what the engine computes. The user
    approved the change on 2026-11-13. The geometry does not change.
    The model (ohs/track/recon_tsdf.py, module docstring):
    sigma^2 = C_NOISE^2 (scatter along the normal) / looks
    + (A_GAP k share of observations next to missing depth)^2
    + A_SCATTER^2 (scatter beyond what the pixels' sigmas predict)
    + mesh terms: curvature (A_CURV k) and open border (A_BORDER k)
    with k = the voxel size in mm, never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
    [test_track_recon_tsdf.py]
2026-11-13 The Check panel: which areas miss the tolerance the part needs
    Step 3 of the third M5 slice (DESKTOP_APP_PLAN.md), on hold until the
    vertex sigma was replaced (3b40d95). In the viewer and on the Process
    page the user types a tolerance and reads, for example, "97 % of the
    surface meets +-0.3 mm; 13 areas need another pass", with the areas
    listed largest first. A click on an area lights it on the mesh and
    flies the camera to it.
    - pages/viewer/CheckPanel.tsx: the field, the sentence, a bar of the
    three shares, the list (6, then all), what the answer rests on, and
    the states: no confidence in this mesh (why, and Make mesh again), a
    failed request, a mesh that changed since it was opened.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
2026-11-13 The gap guard against filled-in holes: in the engine, off by default
    Where nothing can be matched behind an edge, the matcher carries the
    near surface a few pixels into the gap, and fused from all round that
    closes a hole (VALIDATION.md, "Holes filled in"). The guard of that
    study is now in the reconstruction: depth within gap_guard_px (8 px at
    1280 px width) of a patch without depth is not fused. The tracker keeps
    every pixel.
    It is OFF by default (gap_guard_px = 0; None asks for the measured
    radius). With it off nothing changes: the same vertices and the same
    sigma as 3b40d95 on a real pipeline run. The user approved the fix on
    the condition that more tracked scans hold up. The holes do;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
    [test_app_pipeline.py, test_track_recon_tsdf.py]
2026-11-13 The gap guard is on by default
    The user's decision of 2026-11-13, after reading the comparison of
    0357786 (VALIDATION.md, "The gap guard in the engine"): holes are what
    car parts are mounted by, so the fix is worth its cost on a small part
    with tracking.
    PipelineParams.gap_guard_px and ConfidenceTsdf(gap_guard_px=...) now
    default to None: 8 px at 1280 px width, scaled with the width. 0 turns
    the guard off, and a scan then comes out as before it.
    What changes in a scan (16 simulated recordings, each fused with and
    without the guard at identical poses): a 25 mm hole over a far
    background can be fitted every time (23.6-24.3 mm on the car panel,
    22.0-23.6 mm on the plate; without the guard the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
    [test_app_pipeline.py, test_server_process_studio.py, test_track_recon_tsdf.py]
2026-11-13 F1: the Fit tool no longer calls a drifted region a cylinder
    On a 10-frame test scan a click on the table could come back as a
    cylinder of radius 22.6 m, or, on the scan's curled far rim, of radius
    52 mm (MAINTENANCE_PLAN.md, F1; found when 288e74d turned the gap
    guard on).
    In both cases the region had drifted away from its seed, because the
    refits follow the region. The seed saw a radius of 247 mm in a bump of
    the noisy table and the region then ran over the whole table (22.8 m,
    1 degree of arc). On the rim the seed saw 26 mm and the region 52-54 mm:
    the curl tightens towards the edge, so there is no one radius.
    fit_at now refuses a cylinder whose final radius is more than
    SEED_DRIFT (1.5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
    [test_measure_region.py, test_server_process_studio.py]
2026-11-13 Fitted shapes against the truth, measured again with the engine as it is
    The study of 2026-11-12 (VALIDATION.md, "Fitted shapes against the
    truth") run again after the new vertex sigma (3b40d95), the gap guard
    (288e74d) and the Fit tool's refusal of a drifted cylinder (0c7ed21):
    the same ten recordings and clicks, 15 fits per shape and pose source.
    Documentation only; nothing in the engine changes.
    Better: the car panel's hole is fitted on 15 of 15 clicks at both pose
    sources (before: none, or a wrong loop), about 1.2 mm small in
    diameter; planes (base top offset 0.013 -> 0.004 mm at true poses); the
    shaft at true poses (axis position 0.17 -> 0.03 mm).
    Worse: the two bosses. Radius error 0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
2026-11-13 Fitted shapes, measured again: one share corrected
    The share of cylinder fits whose +-2 sigma covers the true radius at
    true poses is 32 % (13 of 41), not 23 %: the 15 hole fits had been
    counted with them.
2026-11-13 The Fit tool: a cylinder's points all weigh the same
    The user's decision of 2026-11-13, after the fits were measured again
    (a5d35f1): since the new vertex sigma, a 14 mm boss fitted 0.39 mm off
    in radius with tracking (before 0.18 mm) and 12.5 degrees off in axis
    direction (before 8.0), because the fit weighed each point by
    1 / sigma^2 and the new sigma, with its bias terms, is very uneven on a
    small round feature: the fit was left to a narrow band of the wall.
    fit_at now fits a cylinder with equal weights for all the points of its
    region, and their median sigma for the +- values. Planes keep
    1 / sigma^2 (equal weights made them worse).
    Measured with the changed engine on the simulated bra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
2026-11-13 Where the lasers and the mesh disagree: the map and its API
    Roadmap item 4, the engine side. The laser lines are measured
    independently of the stereo depth that makes the mesh; this map says,
    for each vertex of the current mesh, how far the laser points near it
    lie from the mesh.
    - ohs.mesh.laser_agreement(V, F, P): per vertex the mean signed
    distance of its laser points along the vertex normal (+ = the lasers
    see the surface further out), NaN where no laser point came near.
    Points are paired with the mesh as anchor_to_points pairs them; one
    farther than 3 mm from the surface is counted as stray and left out.
    With it the numbers a legend needs: the share of the surface the lines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
2026-11-13 The Lasers shading: where the laser lines and the mesh disagree
    Roadmap item 4, the app side of b2fb3ae. A sixth shading in the viewer
    and on the Process page (key 6): the vertices a laser line passed over
    are coloured by how far the laser points lie from the mesh (blue: the
    lasers see the surface further in, light grey: they agree, orange-red:
    further out), on a plain darker grey where no laser line came.
    - pages/viewer/LasersLegend.tsx, useLasers.ts, three/lasers.ts,
    lib/lasers.ts: the legend with a scale limit (0.1 to 1 mm, default
    0.3), the numbers in sentences ("The laser lines cover 15 % of the
    surface. There the mesh and the lasers agree within 0.1 mm for 92 %
    and within 0.3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
2026-11-13 The Scan page shows the tracked mesh as soon as tracking is done
    An open question since F4 (the finished mesh swapped in on the Scan
    page); the user said yes on 2026-11-13. During "Make mesh" the live
    model stayed on screen until the whole job was done. Now the tracked
    mesh takes its place as soon as the job's Track stage is done, and the
    finished mesh replaces it at the end, with the camera left where it is.
    - lib/scanMesh.ts: which mesh the page shows for a job (live, tracked,
    finished). The Track stage records the job that ran it, so the mesh
    of an earlier job is never taken for this one's. A job that fails or
    is cancelled after tracking leaves the tracked mesh: it is the scan's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
2026-11-13 A4: lint for unused code
    pyproject.toml gets [tool.ruff.lint] with the pyflakes rules only
    (unused imports and variables, undefined names): no style rules, no
    reformatting. ruff joins the dev extra; the owner agreed to installing
    it (0.17.5 in the venv). Run: python -m ruff check ohs tests
    It reported 9 unused names, all in tests, now removed: 3 imports
    (field, Pico, BUILTIN_RECIPES) and 6 variables (st, W, H, and j three
    times, where the call stays and only the name goes). The engine and the
    firmware had none.
    Not added: the rule the "# noqa: PLC0415" comments name (imports inside
    functions). It reports 337 places and none is fixed by deleting
    something; the comments stay as notes.
    Guard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
    [test_app_cli.py, test_server_calibration.py, test_server_process_studio.py, test_sim_datasets.py]
2026-11-13 S2: new app connections are seeded off the event loop
    A new WebSocket client, and one that asks for the mesh, got its first
    messages from Studio.seed_client on the event loop. That reads the
    calibration and setup files, and every client's sender waited for it.
    Both calls are now awaited in a thread (asyncio.to_thread). The first
    is awaited before the client's own sender starts, so the order of its
    messages does not change. Hub.offer takes the hub's lock, so it is safe
    from a thread.
    Guard first: test_a_new_connection_is_seeded_off_the_event_loop failed
    on the old code (both seeds ran on the loop) and passes now. The plan's
    three guard tests pass with their files: test_server_basic,
    test_se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
    [app.py, test_server_basic.py]
2026-11-13 Screenshots of OpenHandScan Studio from the simulator demo
    Four 1920 x 1080 pictures in docs/screenshots/, with a caption file:
    live scanning, the result viewer with a measurement, stereo calibration
    in the setup wizard, and the processing studio. All from the simulator,
    not from real hardware. For the project page on jessiescars.com.
2026-11-13 F2: Fill holes no longer doubles a lone triangle
    A fused scan has a few single triangles that touch the surface at one
    vertex only. Their three edges are open, so their outline looked like a
    hole of three edges, and Fill holes filled it with the same triangle
    reversed: two faces back to back, one of them flagged "filled". Found
    with P2 (c348f70); the owner said yes to the fix on 2026-11-13, as it
    changes that edit's result.
    fill_holes now leaves a three-edge loop alone when its three edges
    belong to one face. A real three-edge hole (three faces around it) is
    filled as before. _simple_loops returns positions in the loop, so each
    simple loop knows the face of each of its edges also where a lo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
    [test_mesh_holes.py]
2026-11-13 A1 (2 and 3 of 3): the tests keep their simulated recordings on disk
    About a third of a full test run was fixture setup, most of it the
    simulator rendering recordings (about 1 s per full-resolution stereo
    frame). tests/recordings.py puts a cache in front of that:
    - scan_recording() for make_scan_recording, cached_recording() for any
    function that writes a recording folder, cached_result() for a
    simulator function that returns data (board views, a calibration).
    - The key is the call's arguments and a hash of the renderer: the source
    of ohs/sim, ohs/io, ohs/types.py and ohs/geometry.py, with the numpy
    and OpenCV versions. Any change to the simulator makes a new key, so a
    render of a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
    [recordings.py, test_app_live.py, test_app_pipeline.py, test_app_quality.py, test_calib_drift.py, test_e2e_calibration.py, test_e2e_scan.py, test_recordings_cache.py]
2026-11-14 A1 (2 of 2): 25 more tests marked slow
    With the recording cache warm, the tests that are still slow are slow
    for what they compute, so they move to the full run. 42 tests are
    marked slow now (17 before).
    Kept fast although slower than the limit of about 4.8 s:
    test_track_edits_undo_redo_and_the_process_messages (7.7 s; the tests
    after it in its file build on it) and test_imu_from_recording_fast
    (5 s; it is the fast IMU check). Every file that lost a test to slow
    keeps fast ones, and the fast run passes on its own.
    Measured (Radeon 680M, cache warm):
    full run before A1 737 tests 1,372 s (22.9 min)
    full run now, GPU path 743 passed 840 s (14.0 min)
    fast run, GPU path 701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
2026-11-14 B15: a calibration view is on disk before the session shows it
    CalibrationSession._store added the new view to the session's list and
    only then rewrote frames.csv and meta.json. For a few milliseconds
    GET /api/calibration showed a view the recording did not have yet.
    A1's full run on the CPU path lost that race once
    (test_device_target_stereo_is_saved_and_the_camera_reloads_it: 14
    frames in meta.json, 15 views in the session).
    Now the index is written with the new view first, then the view joins
    the list, and only then the frame counts as captured, so a failed
    write leaves the session as it was. Removing a view already went the
    right way round.
    Test first: test_a_view_is_on_disk_before_the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
    [calibration.py, test_server_calibration.py]
2026-11-14 F3: Fill holes gives each of two touching holes its own neighbour normals
    Two holes that share a rim vertex come out of the boundary walk as one
    loop that passes the vertex twice. fill_holes fills it as two simple
    loops, but looked the neighbour normals up by vertex, so at the shared
    vertex both loops got the face of whichever edge came last. The
    normals are now looked up by the position in the loop.
    Test first: a folded sheet with two square holes that meet at a
    vertex. The old code handed one hole the normal of the other side of
    the fold at that vertex.
    On the 12 real meshes used for F2 (after Remove floaters, Fill holes
    up to 5 mm): 20 of the 4,690 loops are pinched. The fill is identic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
2026-11-14 F5: the Fit tool answers a boss click whose seed is clearly round
    8 of 60 clicks on the simulated bracket's bosses were refused at the
    seed with "its curvature is not clear (radius 7 +- 1 mm)". The radius
    was right. The +- came from the vertex sigma, which is 2 to 3 times
    the wall's scatter on a small round feature.
    Where the seed's points scatter less than their sigma says, a seed
    that bends through 45 degrees of the round or more (SEED_ARC_DEG) is
    now judged by its scatter. Measured on ten simulated scans: a real
    cylinder's seed covers 60 to 274 degrees (100 seeds), the seed of a
    flat face clicked as a cylinder at most 36 degrees of the cylinder
    fitted to it (114 seeds).
    Result on the sa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
2026-11-14 P6 (trajectory half): one reader and one writer of trajectory.csv
    process_recording had its own writer, the app its own reader, and the
    pose graph both. read_trajectory and write_trajectory in
    ohs/track/posegraph.py are now the only ones; ohs/app/process.py and
    ohs/server/processing.py use them.
    The two readers disagreed on the ok column: the app's took 1, True
    and true as tracked and everything else as lost; the pose graph's
    took any integer and raised on True. Now: 1 / 0 as written, True /
    False in any case, and anything else is a ValueError that names the
    file and the frame.
    The written file is the same byte for byte (500 rows, hash before and
    after). The round-trip test pins the format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
2026-11-14 P5: the curve adjustment reads each frame's points only
    For its depth term the laser curve adjustment built, for up to 200
    frames, a fine and a coarse cloud with a search tree each, kept them
    all, and then used about 400 points of the fine one.
    KeyframeClouds.fine_points(pos) gives exactly get(pos).fine.pts
    without the normals' cloud, the coarse level, the trees and the cache.
    Measured on a 60-frame recording, twice each (Radeon 680M):
    640 x 400 1280 x 800
    building clouds 1.6-1.7 s -> 1.1 s 1.7 -> 1.2 s
    whole reading 5.5 -> 5.0 s 6.5 -> 6.1 s
    memory held after 140 -> 30 MB 141 -> 33 MB
    About 1.8 MB less per frame: near 37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
2026-11-14 A6: why the CPU path differs from run to run, and a switch that stops it
    Found the stage: Open3D's VoxelBlockGrid.ray_cast (0.20, CPU) gives
    slightly different answers for the same grid and pose when it runs on
    several threads. Of 38 casts repeated in one process, 14 differed from
    themselves, by 4 to 199 of about 25,000 surface pixels, points up to
    1.9 mm apart. Depth, the laser points and the tracker's own maths are
    the same every time. A warm-up cast does not help; OMP_NUM_THREADS
    does not reach it (Open3D's threads are TBB's).
    OHS_O3D_THREADS=1 holds Open3D to one thread. Two runs are then the
    same in every stage of every frame, and two CPU snapshots (20 frames,
    preview and full) are ide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
2026-11-14 Plan: E7 measured and left as it is
    The laser cloud holds 12-18 KB a frame on the simulated scans, less
    than half the estimate: 62-96 MB after a three-minute scan, 116-178 MB
    after 10,000 frames. float32 would halve that and change the laser
    cloud (a few points move into the neighbouring 0.2 mm voxel), so the
    item's own guard cannot hold. Not worth it; the plan says when to look
    again.
2026-11-14 F4: Remove floaters counts a piece by shared edges
    A fused scan has lone triangles and small flaps that touch the surface
    at a single vertex. Pieces were faces connected through shared
    vertices, so these counted as surface and stayed: 11-19 lone triangles
    and 340-870 faces of flaps on each Standard scan of 1.4-1.7 million
    triangles. Against the true surface they are 0.18-0.33 mm off in the
    median and 0.8-1.0 mm at 90 %, where the surface itself is 0.03-0.04
    and 0.20-0.27 mm: the noisy fringe.
    A piece is now faces joined through shared edges (edge_components in
    ohs/mesh/topology.py; piece_sizes in ohs/mesh/clean.py), so each flap
    is judged by its own size. The hole finder and the mesh statis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
2026-11-14 A6 fix: the snapshot tool no longer leaves Open3D on one thread
    The first version of the repeatability switch (3dcb781) let
    tools/snapshot.py set OHS_O3D_THREADS in the environment and leave it
    there. In a full CPU-path test run the snapshot tool's test then put
    every later test on one thread: slower, and with other results. That
    run had two failures: the repeatability test (the limit was already
    set) and test_the_refined_mesh_is_closer_to_the_truth (0.3026 mm
    against its limit of 0.3 on one thread; it passes 3 of 3 alone with
    the default threads).
    The tool now holds Open3D to one thread only while it processes a
    snapshot (open3d_threads in ohs/track/markerless.py, a context manager
    that pu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
    [test_tools_snapshot.py]
2026-11-14 P6 (STL half): one STL writer for the export and the app
    The export (save_mesh) and the app (its mesh.stl after every edit)
    each had an STL writer. They wrote the same vertices and different
    normals: the export computed them in float64, the app in float32, up
    to 0.00024 apart on a real mesh.
    write_stl in ohs/track/export.py is now the only one: a single np.take
    gather, the normals in float64 as face_normals computes them, stored
    as float32. The owner chose this: the exported file stays as it is,
    the app's mesh.stl takes the more exact normals.
    Measured on a random mesh with faces without area and on a real mesh
    of 1.7 million faces:
    exported file same byte for byte (hash); 0.79 -> 0.40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
2026-11-14 Docs: where a tracked scan's shape errors come from
    A study outside the repository; the engine is not changed.
    With the true depth and the true poses the bracket's mesh is 0.010 mm
    from the part (median), with the matcher's depth 0.065 mm, with
    tracking 0.11-0.22 mm and about 0.3 mm too fat. The tracker makes that
    error itself: its model marks everything up to 8 mm behind a surface
    as inside the part, so edges and thin features swell as the scan goes
    round, the cameras land 0.3-0.5 % too far out and the mesh is fused
    too fat. With 4 mm (GPU model only; the Open3D model of the CPU path
    gets worse with it) the share of the part more than 0.3 mm off falls
    from 42 % to 20 % (13 % at true poses)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
2026-11-14 Docs: the mesh's shorter truncation on other scenes
    The second candidate change of the shape-error study (the mesh's
    truncation 4 -> 2 mm), checked on more scenes; the engine is not
    changed. Smooth scenes get a little worse with it (the full sphere
    scan's mesh distance 0.257 -> 0.301 mm at the 95 % level), marker mode
    clearly worse (1.48 -> 2.47 mm), and a model that also tracks does not
    take it. So a shorter band alone trades thin walls and edges against
    smooth surfaces and poor poses; a band that is short only behind the
    surface is the thing to try next. VALIDATION.md and ROADMAP.md say so.
2026-11-14 Tracking model on the GPU truncates at 4 mm instead of 8 mm
    A TSDF writes "inside" as far as its truncation behind every surface it
    sees. With 8 mm in the 2 mm tracking model, edges and walls thinner than
    that swelled once their far side was seen; frames were registered to the
    swollen model, the cameras landed 0.3-0.5 % too far out and the mesh was
    fused about 0.3 mm too fat (VALIDATION.md, "Where a tracked scan's shape
    errors come from"). The owner decided on 2026-11-14 to make the change.
    - FusionParams.gpu_trunc_mult: the GPU model's own truncation in voxels
    (None: trunc_mult). The pipeline sets 2 for its tracking model
    (TRACK_GPU_TRUNC_MULT). MarkerlessTracker.trunc_mm says what the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
    [test_app_pipeline.py]
